Taeron-Systems-Inc/BespokeToast/data/plant-id/README.md

# Captures for plant identification

Eleven runs, taken off the serial console rather than out of the oven's own
logs, and decimated to 1 Hz.

The run logs the oven writes carry `elapsed_s, target_c, actual_c, relay,
cold_c, cpu_c` and **no duty**. Identification needs the input signal, and
the relay column sampled at 1 Hz is an aliased view of a 4 s
time-proportional window rather than the power actually applied. The console
prints the commanded duty every control step, which is what these hold.

1 Hz because the element time constant is about 14 s.

    python3 tools/identify_plant.py            cross-validate and score
    python3 tools/identify_plant.py --fit      fit on everything
    python3 tools/score_runs.py                the tracking figures the docs quote

`../README.md` lists every run in the repository, including the oven's own
logs for some of these same runs, and how to fetch one that is not here.

| file | run | span |
|---|---|---|
| `run-0011-ts391snl-warm.csv` | 0011 | 34 C warm start, to 247 C |
| `run-0013-ts391snl-hot.csv` | 0013 | 59 C start, the hottest allowed, to 247 C |
| `run-0014-ts391lt.csv` | 0014 | 28 C cold start, to 168 C |
| `run-0015-bake-125c.csv` | 0015 | 30 C to 125 C and held |
| `run-0016-ts391snl-hot-precharge.csv` | 0016 | 59 C start on the pre-charge loop, 2026-09-11 |
| `run-0017-ts391lt-hot-precharge.csv` | 0017 | 59 C start, TS391LT, pre-charge loop, 2026-09-11 |
| `run-0018-ts391snl-warm-predictive.csv` | 0018 | 34 C start on the predictive loop (lead 6 s), 2026-09-11 |
| `run-0019-ts391snl-hot-predictive.csv` | 0019 | 59 C start, predictive loop, decay-form prediction (ran 1.5 C hot from 160 C), 2026-09-11 |
| `run-0020-ts391lt-hot-predictive.csv` | 0020 | 59 C start, TS391LT, driven-form prediction, 2026-09-11 |
| `run-0021-ts391snl-cold-predictive.csv` | 0021 | 25 C cold start, driven-form prediction, 2026-09-11 |
| `run-0022-ts391snl-hot-predictive.csv` | 0022 | 59 C start, driven-form prediction -- the direct answer to 0019 |

0011-0015 on 2026-09-10, empty oven, and the four the element model was
fitted on are 0011, 0013, 0014 and 0015.

0016 is the same start as 0013 on the pre-charge firmware: 33 s of charge,
entered the profile at 80.5 C, heating phase rms 1.57 C, worst lag -5.1 C
(0013: 13.06 and -32.0). Its `precharge` rows are full-duty with the profile
clock held. 0017 is TS391LT from the same start: 27 s of charge, entered at
71.8 C, heating phase rms 2.24 C, worst lag -5.2 C, and +4.1 C of overshoot
at the soak knee at 98 C on stored element heat -- the case the predictive
lead was built from.

## The identification run, 2026-09-11

`run-ident-2026-09-11.csv` is the first schedule from
`tools/device/heat_step_test.py`: plateaux at 60, 100, 150, 195 and 235 C,
each held and then square-waved in duty. `run-ident-2026-09-11-console-4hz.txt`
is the raw console capture it was decimated from, kept because the
per-plateau analysis (`tools/plateau_dynamics.py`) reads the step markers
that decimation drops.

Stopped by hand at step 35 of 41 with the cold junction at 65 C and the top
plateau clamping on its 250 C ceiling; the 235 C excitation and the
scheduled cooling are not in it. Peak 250.8 C, no faults.

What it found, per plateau:

    plateau   mean C   gain C/s   tau s    determined?
    60C        42.2      --        --      no: flat, excitation too gentle
    100C       82.9      --        --      weakly, prefers longer tau
    150C      146.1     1.71      ~15-18   yes
    195C      212.3     1.46      ~9       yes

The element time constant FALLS with temperature. The fitted gains at 150
and 212 C agree with the heating table's h - c to within 8%, so the table
is right there; the 235 C plateau climbed 14 C above its setpoint at the
table's own hold duty, so the table is wrong at the top. That locates the
30% dispute between the linear two-state model and the table: it is a
high-temperature effect, and it is the table's.

A single-tau linear model fitted to all five captures is worse than one
fitted to the four profile runs -- rms 11.3 against 5.3 -- because this run
spans a tau that is not constant. The observer in oven/elementff.py uses
the four-run beta, fitted on the warm-start regime it is used in.
