Taeron-Systems-Inc/BespokeToast/docs/hardware.md

# Hardware

A toaster oven converted to a reflow soldering oven, controlled by an Adafruit
PyPortal.

No design documentation exists. Everything here was established by
inspecting the running device, and confirmed by the owner where marked. Claims
are tagged so it is clear what rests on what:

- **[observed]** — read directly off the device or host
- **[confirmed]** — confirmed by the owner
- **[spec]** — published board specification, not verified on this unit
- **[inferred]** — deduced from the firmware, not electrically confirmed
- **[unverified]** — assumed, still unconfirmed
- **[recorded]** — measured previously and recovered from this repository's
  history; conditions not fully documented

## Controller

| | |
|---|---|
| Board | Adafruit PyPortal **[observed]** |
| MCU | ATSAMD51J20 **[observed]** |
| USB ID | `239a:8036` **[observed]** |
| Board UID | `FCC166805943385320202046141E04FF` **[observed]** |
| CircuitPython | **8.0.5** (2023-03-31) **[observed]** |
| Serial | USB CDC console; enumerates as `Adafruit Industries LLC PyPortal` **[observed]** |
| Mass storage | 8 MB FAT volume, label `CIRCUITPY` **[observed]** |

The board also enumerates as a USB HID keyboard and mouse **[observed]**. It
sends no input, but it is capable of typing into whatever host it is connected
to.

## Mains switching

| | |
|---|---|
| Device | Mechanical relay **[confirmed]** |
| Control pin | `board.D4`, `digitalio` output, `True` energises **[observed]** |
| Connector | `D4` is one of the PyPortal's two 3-pin JST-PH connectors **[spec]** |
| Load | 120 VAC to the oven elements **[confirmed]** |

**Actuations are a consumable, and this firmware spends more of them than
the one it replaced [measured].** The relay is driven by a 4 s
time-proportional window, so it is held continuously while the error is
large and modulates near setpoint. Measured across the hold of a four-hour
bake, `data/bake-125c-run-0024-2026-09-16.csv`: 8.19 closures per minute,
about 1965 in the run. A reflow profile costs far fewer, because most of it
is spent saturated. The controller that was here before this one managed
roughly 20 in a session by holding the relay across consecutive saturated
windows; the cost of the change is relay life, and what it buys is 0.240 C
rms instead of a curve the oven wandered around. Contact rating is still
unknown — see *Open questions*.

**The relay fails safe [measured].** Reading `D4` back as an input under each
internal pull returns `False` under both pull-up and pull-down, so an external
pulldown dominates and the relay is de-energised whenever the pin is not
driven. Reproduced identically on three separate runs.

This matters beyond the obvious: CircuitPython releases pins whenever the VM
exits, so high-Z on `D4` occurs on every reset, every `Ctrl-C` and every
auto-reload. All of those are safe.

## Temperature sensing

| | |
|---|---|
| Device | MCP9601 thermocouple amplifier, Adafruit **5165** (STEMMA QT) **[confirmed]** |
| Thermocouple | Type **K**, Adafruit **3245**: glass braid, 2 mm stainless tip **[confirmed]** |
| I²C address | `0x67` (103 decimal), the board's default **[spec]** |
| Bus | `board.SCL` / `board.SDA` at 100 kHz **[observed]** |
| Driver | `adafruit_mcp9600`, which serves both chips **[spec]** |

Probe placement inside the oven cavity is **[unverified]**, which leaves thermal
lag between element and probe unquantified.

### What changed from the MCP9600 and the bare-bead probe

The oven was built with an MCP9600 (Adafruit 4101) and a bare-bead type-K
probe (Adafruit 270). **Everything measured in this document was measured on
that pair**: the step tests, the coast, the latch-up and the enclosure
temperatures. None of it has been repeated on the new parts yet.

**The driver on the board must accept the MCP9601.** It checks the chip's
device ID, and older releases of `adafruit_mcp9600` accept only the MCP9600's
`0x40`. With one of those the firmware stops at boot with "Failed to find
MCP9600". Install a current release from the bundle **[spec]**.

**The firmware refuses an MCP9600.** `oven/hardware.py` reads the device ID
itself and stops at boot unless it is the MCP9601's `0x41`. It reads the
MCP9601's status bits, and on an MCP9600 those mean something else.

**An open or shorted probe now trips at once.** The MCP9601 sets bit 4 of
its status register when the probe is open (or its voltage is outside the
type-K range, which at oven temperatures only a wiring fault causes) and bit
5 when it is shorted to VDD or ground. The firmware reports them as
`thermocouple open circuit` and `thermocouple short circuit`, and the
supervisor latches on either. Before, a disconnected probe produced a reading
and only the stall and frozen guards could catch it. They still run.

The detection works only if the breakout wires the chip's VSENSE pin, and
that is **[unverified]** for the 5165. To check it, with the oven unpowered at
the wall, take one probe lead out of the terminal block and power the
PyPortal over USB: the first reading should fault with `thermocouple open
circuit`. If it reads a temperature instead, the bits are not wired and the
oven is protected exactly as it was before.

**The probe's tip is its junction.** The 3245's junction is bonded to the
stainless tip, so the tip is electrically part of the thermocouple. If it
touches the oven's metal it ties the input to the chassis. Expect a short
circuit fault, if VSENSE is wired, or a noisy reading if it is not. Mount it
so the tip touches nothing but air.

**The probe is slower.** A 2 mm steel tip responds more slowly than a bare
bead, so the oven will look like it lags more and coasts further past a peak
than *Measured thermal behaviour* says. The controller was tuned on those
figures. Repeat the step tests before trusting a reflow profile to them
**[unverified]**.

**The PyPortal's I²C port jumper must be on 3V.** The port supplies 5 V by
default, and the breakout pulls SDA and SCL up to its supply through 10 kΩ.
At 5 V that back-feeds the SAMD51's 3.3 V rail through the bus lines, which
stopped the board booting with the MCP9600 fitted.

### The amplifier can latch up and hold the bus down

Twenty-three minutes into a 125 C bake, holding steady at 124.7 C, the
MCP9600 stopped answering between one sample and the next. The supervisor
faulted on the first missing reading and opened the relay: the run was lost,
and nothing else. Neither temperature channel gave warning. The cold junction
was 46.1 C and levelling off, below what it had reached twice that day without
trouble, and the chamber reading was quieter in its last minutes than earlier
in the hold.

Afterwards the board could not start the bus at all (`RuntimeError: No pull up
found on SDA or SCL`). Read as plain inputs, SCL sat high and SDA sat low even
with the processor's internal pull-up on: SDA was being held to ground.
Resetting the processor did not clear it. Removing all power did -- unplugging
the Pi and the oven's USB cable and plugging them back in, with nothing else
changed.

That is the amplifier latching up and holding SDA low, not a wiring fault.
Seen once. The oven faults safely when it happens -- the supervisor opens
the relay on the first missing reading -- and the fix is to remove power,
which can be done from the Pi without touching the bench (see *Cutting the
oven's power from the Pi*).

## Measured thermal behaviour

Measured with the MCP9600 and the bare-bead probe; see *What changed from the
MCP9600 and the bare-bead probe*.

Two step tests were run on 2026-08-25, empty oven, logged at 2 Hz:
`data/e2-step-test-2026-08-25.csv` (26 → 200 °C) and
`data/e2-step-test-240c-2026-08-25.csv` (53 → 240 °C).

| | **[measured]** |
|---|---|
| Heating, 26 → 200 °C | 143 s |
| Heating, 53 → 240 °C | 177 s |
| Peak heating rate | **1.85 °C/s at 80 °C** |
| Heating rate at 200 °C | **0.90 °C/s** |
| Passive cooling at 190 °C, door shut | **−0.70 °C/s** |
| Coast after relay opens, from 200 °C | **1.06 °C over 3 s** |
| Coast after relay opens, from 240 °C | **0.56 °C over 2 s** |
| Enclosure cold junction, peak | 41.8 °C |
| CPU die, peak | 36.2 °C |

Three things follow.

**The oven is not a first-order system.** Its heating rate *rises* to a peak
near 80 °C rather than decaying from the start, and its heating and cooling
time constants differ by roughly 2.5×. A fitted first-order-plus-dead-time
model gave a 20 s dead time, which predicts about 17 °C of coast — sixteen
times what was measured. The model is not used; the measured curves are.

**The oven's capability falls as it gets hotter, and reflow needs it hottest.**
1.85 °C/s at 80 °C but 0.90 °C/s at 200 °C. Both available profiles demand
their fastest rise in the spike zone, where the oven is weakest.

**Cooling cannot follow any reflow profile with the door shut**, at −0.70 °C/s
against the 1.3–2.0 °C/s profiles ask for.

### The 2023 figure was wrong

A calibration recovered from this repository's history recorded 29.6 °C of
overshoot over 37 s at a 100 °C setpoint. The measurement above is 1.06 °C
over 3 s — smaller by a factor of 28. Whatever that run measured, it does not
describe this oven. It is recorded here only so nobody re-derives anything
from it.

The procedure: heat until the setpoint is reached, open the relay, keep sampling
until the temperature stops rising. The resulting figures were stored as
`calibrate_temp` and `calibrate_seconds` in a configuration file the current
firmware no longer reads.

One data point, at one temperature, with ambient and load unrecorded — treat the
numbers as indicative rather than exact. What they establish is not in doubt:
this oven keeps heating substantially after power is removed. Any control scheme
that decides when to stop by looking only at the present temperature will
overshoot its peak.

## The enclosure warms unevenly

Two thermometers sit in the enclosure: the amplifier's cold junction (its own
die, which it needs anyway to compensate the thermocouple) and the SAMD51's
die. Across a full run they behave completely differently **[measured]**, on
the MCP9600:

| | cold junction | controller die |
|---|---|---|
| rise, step to 200 °C | **+15.3 °C** | +0.2 °C |
| rise, step to 240 °C | **+12.2 °C** | 0.0 °C |

The enclosure as a whole is not warming. One chip is. The SAMD51, centimetres
away in the same box, does not move at all, which rules out warm air and
points at conduction — almost certainly heat travelling up the thermocouple
wires into the MCP9600's terminals.

That matters beyond the enclosure. Cold-junction compensation assumes the
chip's die and the thermocouple terminals are at the same temperature. Heat
arriving *through the terminals* is exactly the case where they are not, and
the error grows through the run, peaking when the oven is hottest and the
reading matters most. Its size is **[unverified]**: bounding it needs a
reference probe in the cavity to compare against.

Both temperatures are logged every control step, so the divergence is
recorded on every run rather than inferred afterwards.

## Display and input

- 320×240 2.4" TFT with resistive touch **[spec]**. The firmware reads
  `board.DISPLAY.width` / `.height` rather than hardcoding **[observed]**.
- The panel is full colour. The firmware uses a five-entry palette — black,
  white, red, green, blue **[observed]**.
- Touch calibration in use: `((5200, 59000), (5800, 57000))` **[observed]**.

## Physical installation

The PyPortal, the relay, and the associated wiring are housed together in a
small 3D-printed plastic enclosure, hardwired into the oven and sitting beside
it **[confirmed]**.

Consequences worth recording:

- **No plug to pull.** The oven is hardwired, so isolating it means a breaker or
  an upstream switch, not unplugging. Any procedure that assumes a plug can be
  yanked needs rewriting.
- **The NeoPixel is not visible** from outside the enclosure **[confirmed]**,
  which leaves the screen as the only visual indicator, and audio as the only
  non-visual one.
- **The enclosure sits next to a heat source.** Internal ambient will rise during
  a run by an unmeasured amount. Two consequences: the enclosure material's
  softening point is a limit nobody has characterised, and the amplifier's
  cold-junction compensation assumes its die and the thermocouple terminals are
  at the same temperature — a thermal gradient across the enclosure introduces
  measurement error. Neither is quantified. **[unverified]**

## Fitted, not used by the firmware

microSD slot and light sensor **[spec]**, and the NeoPixel, which is in any
case enclosed and invisible — see above.

The speaker **is** used, for two sounds: a rising arpeggio when a profile
finishes, and a falling tone pair, twice, on a fault or a preheat that timed
out. Both are under two seconds and play without blocking the loop; see
`oven/chime.py`. `CHIME DONE` and `CHIME FAULT` on the console play them on
demand. A speaker that fails to start leaves the oven silent, not stopped.
The relay is driven open before the speaker is set up or touched, and
cannot close again until the sound is over (`hal.Interlocked`).

The ESP32 WiFi co-processor **is** used: it sets the clock at boot and serves
the oven's page while it is idle. It is kept out of the control loop by
timing rather than by choice, because one SPI call to it can block for 227 ms
against a 250 ms deadline. See `network.md`.

## Connecting to the device

Over USB the board presents two interfaces:

- **Serial console / REPL** — a USB CDC device, conventionally `/dev/ttyACM*` on
  Linux. The stable path is under `/dev/serial/by-id/`, keyed by the board UID
  above, which does not move between reboots or ports. On most Linux systems the
  node is group `dialout`, so the account using it needs that membership.
- **`CIRCUITPY` volume** — a small FAT filesystem. Where it does not auto-mount,
  mount it read-only unless you intend to deploy:

  ```
  sudo mount -o ro,uid=$(id -u),gid=$(id -g) /dev/disk/by-label/CIRCUITPY /mnt/circuitpy
  ```

Opening the serial console does not reset the board. Toggling DTR at 1200 baud
puts it into the UF2 bootloader, so avoid that unless reflashing is intended.

### Cutting the oven's power from the Pi

The bench Pi is a Raspberry Pi 3 Model B. Its USB ports 2 to 5 share one power
switch, reached through port 2, so the oven's power is cut and restored with

    sudo uhubctl -l 1-1 -p 2 -a cycle -d 12

That cuts every USB device plugged into the Pi, not only the oven. The Pi's own
network is its built-in WiFi, which is not on USB, so an SSH session survives
it; the wired Ethernet adapter sits on hub port 1 and is not switched.
Verified 2026-09-15: the board dropped off the bus and came back with its clock
restarted from zero.

**Asking for port 4, where the oven is plugged in, does nothing.** `uhubctl`
reports the port as off and the board re-enumerates, but power never drops. On
2026-09-11 that was taken for a real power cycle and reported as one. It was
not, which is why the latched amplifier survived it and a physical unplug
cleared it.

## Open questions

1. Where is the thermocouple mounted in the cavity? Unknown placement leaves
   the lag between element and probe unquantified.
2. Relay contact rating, and whether it switches one leg or both.
3. Is there an independent thermal cutout, or is the PyPortal the only
   control over the elements?
4. How large is the cold-junction compensation error at peak? Bounding it
   needs a reference probe in the cavity (see *The enclosure warms
   unevenly*).
5. Does the Adafruit 5165 wire the MCP9601's VSENSE pin? If not, the open
   and short circuit bits never set (see *What changed from the MCP9600 and
   the bare-bead probe*).
6. How much lag and coast does the 3245's steel tip add? The step tests need
   repeating on it.
