Taeron-Systems-Inc/BespokeToast/docs/frozen-build.md

# Building the firmware with the oven's own code frozen

## Why

The PyPortal has 256 kB of RAM and no more. Python module bytecode loaded
from the filesystem lives in that RAM; bytecode frozen into the CircuitPython
image executes from flash and costs almost nothing. Measured on this board:

| | free | largest block |
|---|---|---|
| all ten profiles loaded, libraries shadowed | 16 384 | 1 696 |
| one profile loaded | 30 352 | 4 912 |
| rate curves packed into arrays | 34 160 | — |
| shadowing libraries moved aside | 36 032 | 2 608 |
| **oven package frozen into the firmware** | **77 952** | **7 024** |

Nearly five times the memory it started with. The largest contiguous block
matters as much as the total: every render failure in this project was a
few hundred bytes failing against a heap with plenty free and no hole big
enough.

## Why the largest free block is the number to watch

Free memory has never been what failed on this board. Every render failure
in this project has been a few hundred to a couple of thousand bytes failing
against a heap with tens of kB free and no hole big enough, because
MicroPython's collector does not compact.

The clearest case: run 0009, a four-hour bake, reported 50 kB free and a
largest free block of 1776 bytes while the console counted 3256 memory
failures composing a screen. (The counter is a console warning from
`code.py`, not a column in the log —
`data/bake-125c-run-0009-2026-09-09.csv` is the run, not the counter.)
Measured on the board, one compose of
the running screen holds 2896 bytes -- but as forty small tuples plus, at
the time, two copied point lists:

    list(history), 150 points      1056 bytes
    list(profile_points), 25        160

A fragmented heap can satisfy forty small requests. It cannot satisfy one
kilobyte in one piece. Removing those two copies removed the largest single
request the screen makes, and nothing else about the compose changed.

The lesson generalises: when something fails for memory here, ask what the
biggest single allocation is, not how much is free.

## The rule that makes it work, and breaks it

**A file on CIRCUITPY shadows the frozen copy of the same module.** That is
how you undo all of this without any error appearing: everything still
works, on a third of the memory.

So a frozen build requires the volume NOT to contain:

- `oven/` — the firmware's own package
- `adafruit_display_text`, `adafruit_esp32spi`, `adafruit_bus_device`,
  `adafruit_portalbase`, `adafruit_requests`, `neopixel` — these are frozen
  into the stock PyPortal firmware already, and the Adafruit bundle puts
  copies on the volume

`tools/deploy.py` refuses to deploy when any of the libraries reappear, and
skips `oven/` entirely when it sees the board is running a frozen build.
The displaced copies are kept in `.shadowed/` on the volume.

## Why 8.0.5, and why it is pinned

The board runs CircuitPython **8.0.5** and the frozen build is pinned to it.
The reason is a version coupling inherited from the oven as found: the
controller that was on it called `display.show(group)`, which CircuitPython
9 removed, and its bundled `.mpy` libraries were 8.x builds. The current
firmware no longer depends on either, so the pin is now a deliberate choice
rather than a constraint: 8.0.5 is the version every measurement in this
repository was taken on, and moving it is a change to be made and validated
on purpose, not inherited by building against whatever is current.

## Building

The build host needs ~3 GB of disk and an ARM toolchain, which the Pi that
talks to the oven has neither of. `tools/release.py` takes it from
`TOASTER_BUILD_HOST` and refuses to run without it, rather than defaulting
to whichever machine happened to build it here:

    export TOASTER_BUILD_HOST=user@host

    # toolchain, no root required
    mkdir -p ~/toolchains && cd ~/toolchains
    curl -LO https://developer.arm.com/-/media/Files/downloads/gnu/13.2.rel1/binrel/arm-gnu-toolchain-13.2.rel1-x86_64-arm-none-eabi.tar.xz
    tar xf arm-gnu-toolchain-13.2.rel1-x86_64-arm-none-eabi.tar.xz
    pip3 install --user cascadetoml

    # source, matching the version already on the board
    mkdir -p ~/build && cd ~/build
    git clone --depth 1 --branch 8.0.5 https://github.com/adafruit/circuitpython.git
    cd circuitpython && make fetch-submodules

    # the oven's code, and the line that freezes it
    rsync -a firmware/oven/ ~/build/circuitpython/frozen/BespokeToast/oven/
    echo 'FROZEN_MPY_DIRS += $(TOP)/frozen/BespokeToast' \
      >> ports/atmel-samd/boards/pyportal/mpconfigboard.mk

    export PATH=$HOME/.local/bin:$HOME/toolchains/arm-gnu-toolchain-13.2.Rel1-x86_64-arm-none-eabi/bin:$PATH
    cd ports/atmel-samd && make -j24 BOARD=pyportal

Result: `build-pyportal/firmware.uf2`.

### One patch is required

GCC 13.2 is newer than CircuitPython 8.0.5 and its new diagnostics — a
dangling-pointer warning in `py/stackctrl.c` — are fatal under the port's
hardcoded `-Werror`. There is no `WERROR` knob and `CFLAGS_EXTRA` is applied
too early to override it, so the blanket flag is removed from
`ports/atmel-samd/Makefile`:

    -Wall -Werror -std=gnu11   ->   -Wall -std=gnu11

`-Werror=missing-prototypes` is deliberately left in place. The alternative
is to fetch a GCC contemporary with 8.0.5.

## Flashing

The bootloader can be entered without touching the board, which matters
because the USB port is behind a panel:

    import microcontroller
    microcontroller.on_next_reset(microcontroller.RunMode.BOOTLOADER)
    microcontroller.reset()

The volume reappears as `PORTALBOOT`; copy the `.uf2` onto it and the board
reboots itself.

## Rolling back

Two levels, cheapest first.

1. **Move `oven/` back** from `.shadowed/` on the volume. The filesystem
   copy shadows the frozen one, so the board runs the old code again with no
   reflash. This is why the flash and the switch are separate steps.
2. **Reflash the stock image**, kept alongside the build:
   `adafruit-circuitpython-pyportal-en_US-8.0.5.uf2` from
   downloads.circuitpython.org.

If CircuitPython will not boot at all, the bootloader is in a protected
region and survives; entering it then needs a physical double-tap on reset,
which means opening the panel.

## Who owns CIRCUITPY

A deploy needs the host to own the volume; the oven needs to own it to record
a run. Only one direction is automatic:

    cable comes out          the oven takes it back, one boot later
    cable goes in            nothing happens

    python3 tools/deploy.py /mnt/circuitpy      take it, and keep it
    python3 tools/deploy.py --standalone        hand it back, and keep it that way

Attaching a cable used to take the volume by itself, which meant an oven with
a programming cable left in could never record a run: every boot rewrote the
mode back to HOST, so every following boot came up host-owned with logging
off. It showed on the power-on screen as a red FAIL beside "run logging", on
an oven that was working perfectly.

Being locked out is a single command over the serial console, which is
available exactly when a cable is attached, so making this explicit costs
nothing and stops the oven quietly losing the one job only it can do.

## What changes about day-to-day work

Editing anything under `firmware/oven/` no longer takes effect by deploying.
It needs a rebuild and a reflash. `code.py`, `profiles/`, `assets/` and
`characterisation.json` still deploy normally, which covers most changes.
