Taeron-Systems-Inc/BespokeToast/tests/data/nc191-measured-run.csv

# NC191LTA10 datasheet profile as this oven actually ran it
# 2026-09-01 | cold start | operator opened the door at the end
# of the run. Decimated to 1 Hz. Used to test decisions against
# what the oven does rather than against a perfectly followed
# target -- with perfect tracking the door is never needed
# which is exactly why an idealised test proved nothing.
elapsed_s | temp_c
0.0 | 26.188
1.0 | 26.125
2.0 | 26.188
3.0 | 26.250
4.3 | 26.312
5.5 | 26.438
6.5 | 26.688
7.8 | 26.875
9.0 | 27.250
10.0 | 27.500
11.0 | 28.000
12.3 | 28.500
13.3 | 29.062
14.5 | 29.938
15.7 | 30.812
16.7 | 31.500
17.8 | 32.500
19.0 | 33.688
20.0 | 34.688
21.0 | 35.688
22.0 | 37.125
23.0 | 38.312
24.4 | 39.875
25.5 | 41.750
26.5 | 43.125
27.5 | 44.562
28.5 | 45.938
29.8 | 48.125
31.0 | 50.000
32.0 | 51.562
33.1 | 53.500
34.3 | 55.500
35.5 | 57.875
36.5 | 59.562
37.8 | 61.562
39.0 | 64.188
40.3 | 66.375
41.3 | 68.125
42.3 | 70.250
43.5 | 72.000
44.5 | 74.188
45.5 | 76.312
46.8 | 78.000
48.0 | 79.188
49.2 | 80.688
50.3 | 81.562
51.3 | 82.438
52.3 | 83.188
53.5 | 84.188
54.5 | 84.750
55.8 | 85.500
57.0 | 86.188
58.0 | 86.562
59.2 | 87.125
60.3 | 87.500
61.3 | 87.812
62.5 | 88.125
63.5 | 88.438
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
