Taeron-Systems-Inc/BespokeToast/tests/data/run-0006-nc191lta10.csv

# Taeron Reflow Oven run log
# firmware | v2.0-dev
# profile | NC191LTA10
# started_at_epoch | 1788899927
# started_at_local | 2026-09-08 13:38:47 PDT
# entered_at_s | 0.0
# wall clock of a row = started_at_epoch + elapsed_s
elapsed_s | target_c | actual_c | relay | cold_c | cpu_c
# event | 0.2 | run_started | entered_at_s=1.1 oven_c=26.4 profile=NC191LTA10
0.2 | 25.00 | 26.438 | 0 | 27.00 | 37.47
# event | 0.7 | stage_changed | stage=preheat
1.2 | 27.84 | 26.438 | 0 | 27.00 | 37.47
2.5 | 29.50 | 26.438 | 0 | 27.00 | 37.26
3.5 | 30.84 | 26.500 | 0 | 27.06 | 37.05
4.7 | 32.51 | 26.438 | 1 | 27.00 | 36.41
5.8 | 33.90 | 26.438 | 1 | 27.00 | 36.62
7.0 | 35.49 | 26.438 | 1 | 27.00 | 37.26
8.0 | 36.83 | 26.500 | 1 | 27.06 | 36.62
9.0 | 38.17 | 26.438 | 1 | 27.00 | 37.05
10.0 | 39.51 | 26.500 | 1 | 27.00 | 37.26
11.3 | 41.22 | 26.563 | 1 | 27.00 | 36.84
12.5 | 42.85 | 26.750 | 1 | 27.00 | 36.41
13.5 | 44.19 | 26.938 | 1 | 27.00 | 36.84
14.7 | 45.63 | 27.188 | 1 | 27.00 | 37.26
16.0 | 46.87 | 27.500 | 1 | 27.06 | 36.84
17.2 | 48.12 | 27.875 | 1 | 27.06 | 36.62
18.2 | 49.13 | 28.250 | 1 | 27.06 | 36.41
19.5 | 50.39 | 28.875 | 1 | 27.06 | 37.69
20.7 | 51.63 | 29.438 | 1 | 27.06 | 37.26
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
