Taeron-Systems-Inc/BespokeToast/design_files/BespokeToast_Rev-0_v77.brd

## EAGLE design design_files/BespokeToast_Rev-0_v77.brd (2023-02-11, last stored version)

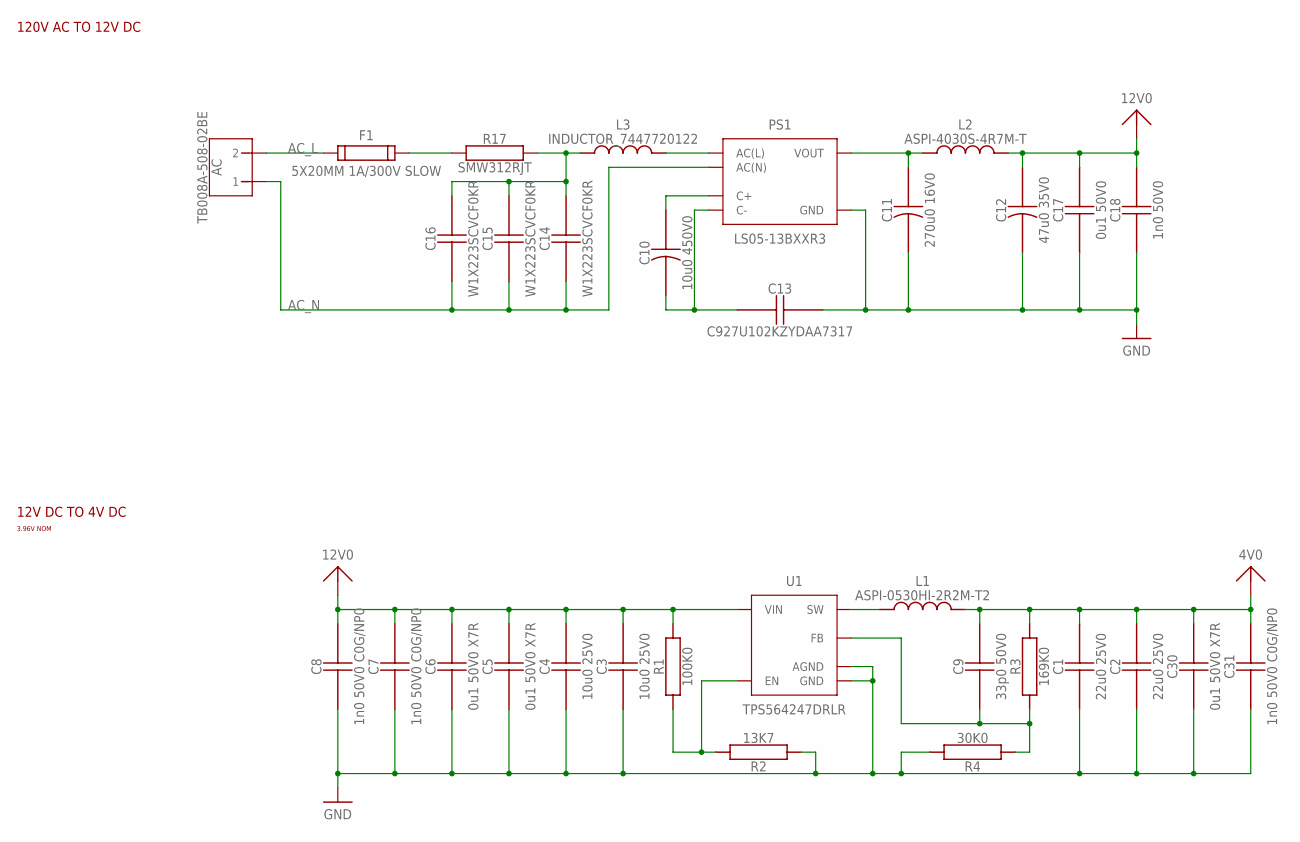
[picture p1: schematic BespokeToast_Rev-0_v77.sch, sheet 1, POWER SUPPLY]

Parts:
AC: TB008A-508-02BE
C1, C2: 22u0 25V0; SAMSUNG_CAP-0805
C3, C4: 10u0 25V0; SAMSUNG_CAP-0805
C5, C6, C30: 0u1 50V0 X7R; SAMSUNG_CAP-0402
C7, C8, C31: 1n0 50V0 C0G/NP0; SAMSUNG_CAP-0402
C9: 33p0 50V0; SAMSUNG_CAP-0402
C10: 10u0 450V0; RUBYCON_CAP-POL-5X10
C11: 270u0 16V0; RUBYCON_CAP-POL-3.5X8
C12: 47u0 35V0; RUBYCON_CAP-POL-3.5X8
C13: C927U102KZYDAA7317; TH_CAP-7.5
C14, C15, C16: W1X223SCVCF0KR; TH_CAP-7.5
C17: 0u1 50V0; SAMSUNG_CAP-0402
C18: 1n0 50V0; SAMSUNG_CAP-0402
F1: 5X20MM 1A/300V SLOW; FC-203-22
L1: ASPI-0530HI-2R2M-T2
L2: ASPI-4030S-4R7M-T
L3: INDUCTOR_7447720122; 7447720122
PS1: LS05-13BXXR3
R1: 100K0; YAGEO_RES-0402
R2: 13K7; YAGEO_RES-0402
R3: 169K0; YAGEO_RES-0402
R4: 30K0; YAGEO_RES-0402
R17: SMW312RJT
U1: TPS564247DRLR

Connections:
4V0: C1.P$2, C2.P$2, C9.P$2, C30.P$2, C31.P$2, L1.P$2, R3.P$2; also elsewhere on the board
12V0: C3.P$2, C4.P$2, C5.P$2, C6.P$2, C7.P$2, C8.P$2, C12.+, C17.P$2, C18.P$2, L2.P$2, R1.P$2, U1.P$1 (VIN); also elsewhere on the board
AC_L: AC.P$2 (2), F1.P$1, F1.P$2; also elsewhere on the board
AC_N: AC.P$1 (1), C14.P$1, C15.P$1, C16.P$1, PS1.P$2 (AC(N)); also elsewhere on the board
GND: C1.P$1, C2.P$1, C3.P$1, C4.P$1, C5.P$1, C6.P$1, C7.P$1, C8.P$1, C11.-, C12.-, C13.P$2, C17.P$1, C18.P$1, C30.P$1, C31.P$1, PS1.P$5 (GND), R2.P$1, R4.P$2, U1.P$3 (GND), U1.P$4 (AGND); also elsewhere on the board
unnamed: R1.P$1, R2.P$2, U1.P$5 (EN)
unnamed: C10.+, PS1.P$3 (C+)
unnamed: C10.-, C13.P$1, PS1.P$4 (C-)
unnamed: C11.+, L2.P$1, PS1.P$6 (VOUT)
unnamed: F1.P$3, F1.P$4, R17.P$2
unnamed: C9.P$1, R3.P$1, R4.P$1, U1.P$6 (FB)
unnamed: C14.P$2, C15.P$2, C16.P$2, L3.P$1, R17.P$1
unnamed: L3.P$2, PS1.P$1 (AC(L))
OUT: L1.P$1, U1.P$2 (SW)

Notes on the sheet:
120V AC TO 12V DC
12V DC TO 4V DC
3.96V NOM

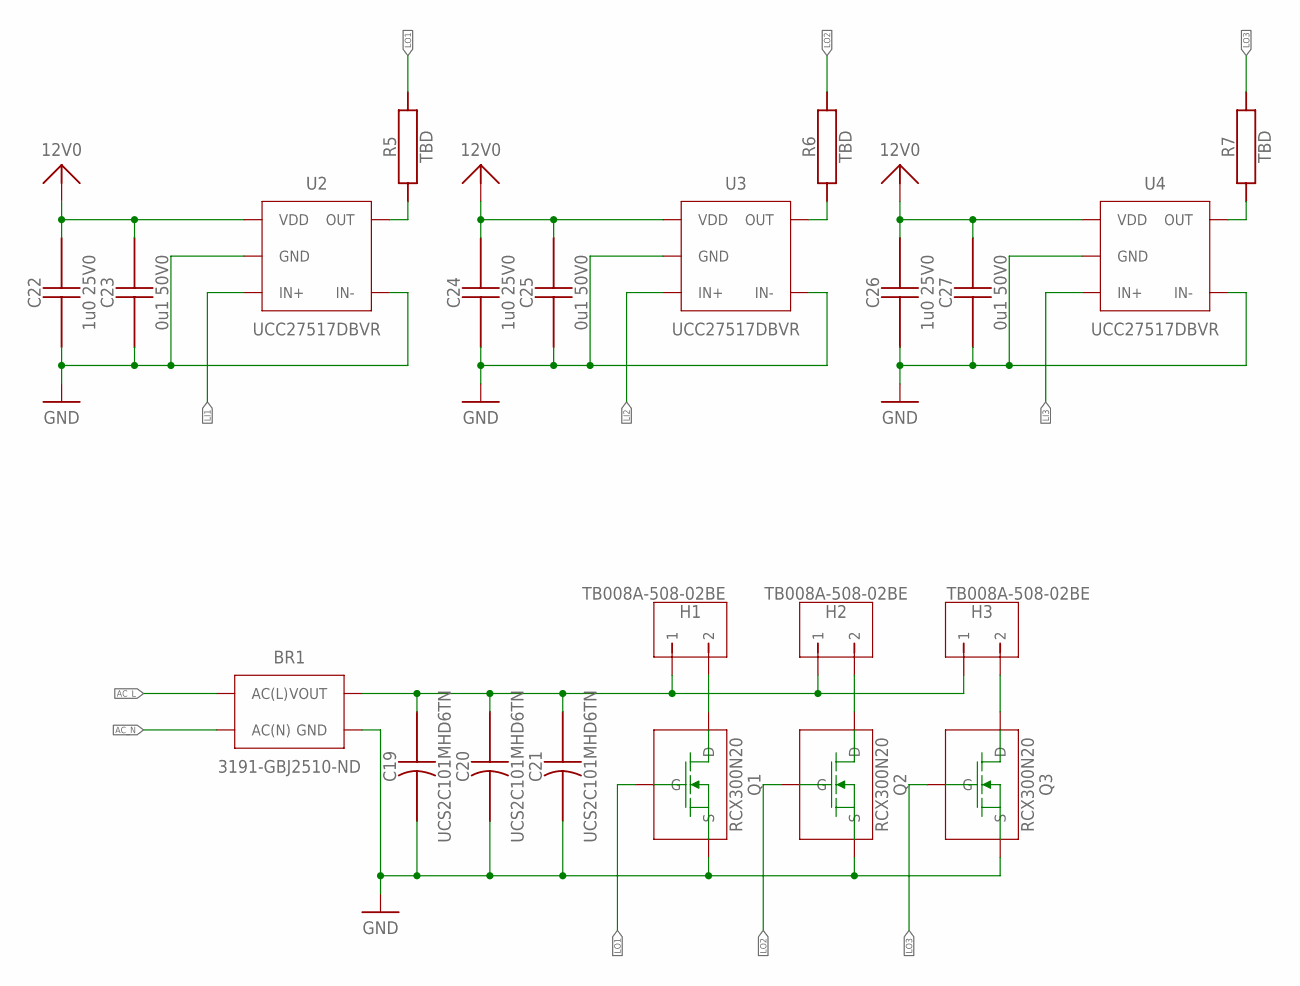
[picture p2: schematic BespokeToast_Rev-0_v77.sch, sheet 2, POWER]

Parts:
BR1: 3191-GBJ2510-ND; GBJ2510
C19, C20, C21: UCS2C101MHD6TN; RUBYCON_CAP-POL-7.5X16
C22, C24, C26: 1u0 25V0; SAMSUNG_CAP-0805
C23, C25, C27: 0u1 50V0; SAMSUNG_CAP-0402
H1, H2, H3: TB008A-508-02BE
Q1, Q2, Q3: RCX300N20; FET_TO220-VTH
R5, R6, R7: TBD; YAGEO_RES-0402
U2, U3, U4: UCC27517DBVR

Connections:
12V0: C22.P$2, C23.P$2, C24.P$2, C25.P$2, C26.P$2, C27.P$2, U2.P$1 (VDD), U3.P$1 (VDD), U4.P$1 (VDD); also elsewhere on the board
AC_L: BR1.P$2 (AC(L)); also elsewhere on the board
AC_N: BR1.P$3 (AC(N)); also elsewhere on the board
GND: BR1.P$4 (GND), C19.-, C20.-, C21.-, C22.P$1, C23.P$1, C24.P$1, C25.P$1, C26.P$1, C27.P$1, Q1.S, Q2.S, Q3.S, U2.P$2 (GND), U2.P$4 (IN-), U3.P$2 (GND), U3.P$4 (IN-), U4.P$2 (GND), U4.P$4 (IN-); also elsewhere on the board
LI1: U2.P$3 (IN+); also elsewhere on the board
LI2: U3.P$3 (IN+); also elsewhere on the board
LI3: U4.P$3 (IN+); also elsewhere on the board
LO1: Q1.G, R5.P$2
LO2: Q2.G, R6.P$2
LO3: Q3.G, R7.P$2
unnamed: H1.P$2 (2), Q1.D
unnamed: H2.P$2 (2), Q2.D
unnamed: H3.P$2 (2), Q3.D
unnamed: BR1.P$1 (VOUT), C19.+, C20.+, C21.+, H1.P$1 (1), H2.P$1 (1), H3.P$1 (1)
unnamed: R6.P$1, U3.P$5 (OUT)
unnamed: R5.P$1, U2.P$5 (OUT)
unnamed: R7.P$1, U4.P$5 (OUT)

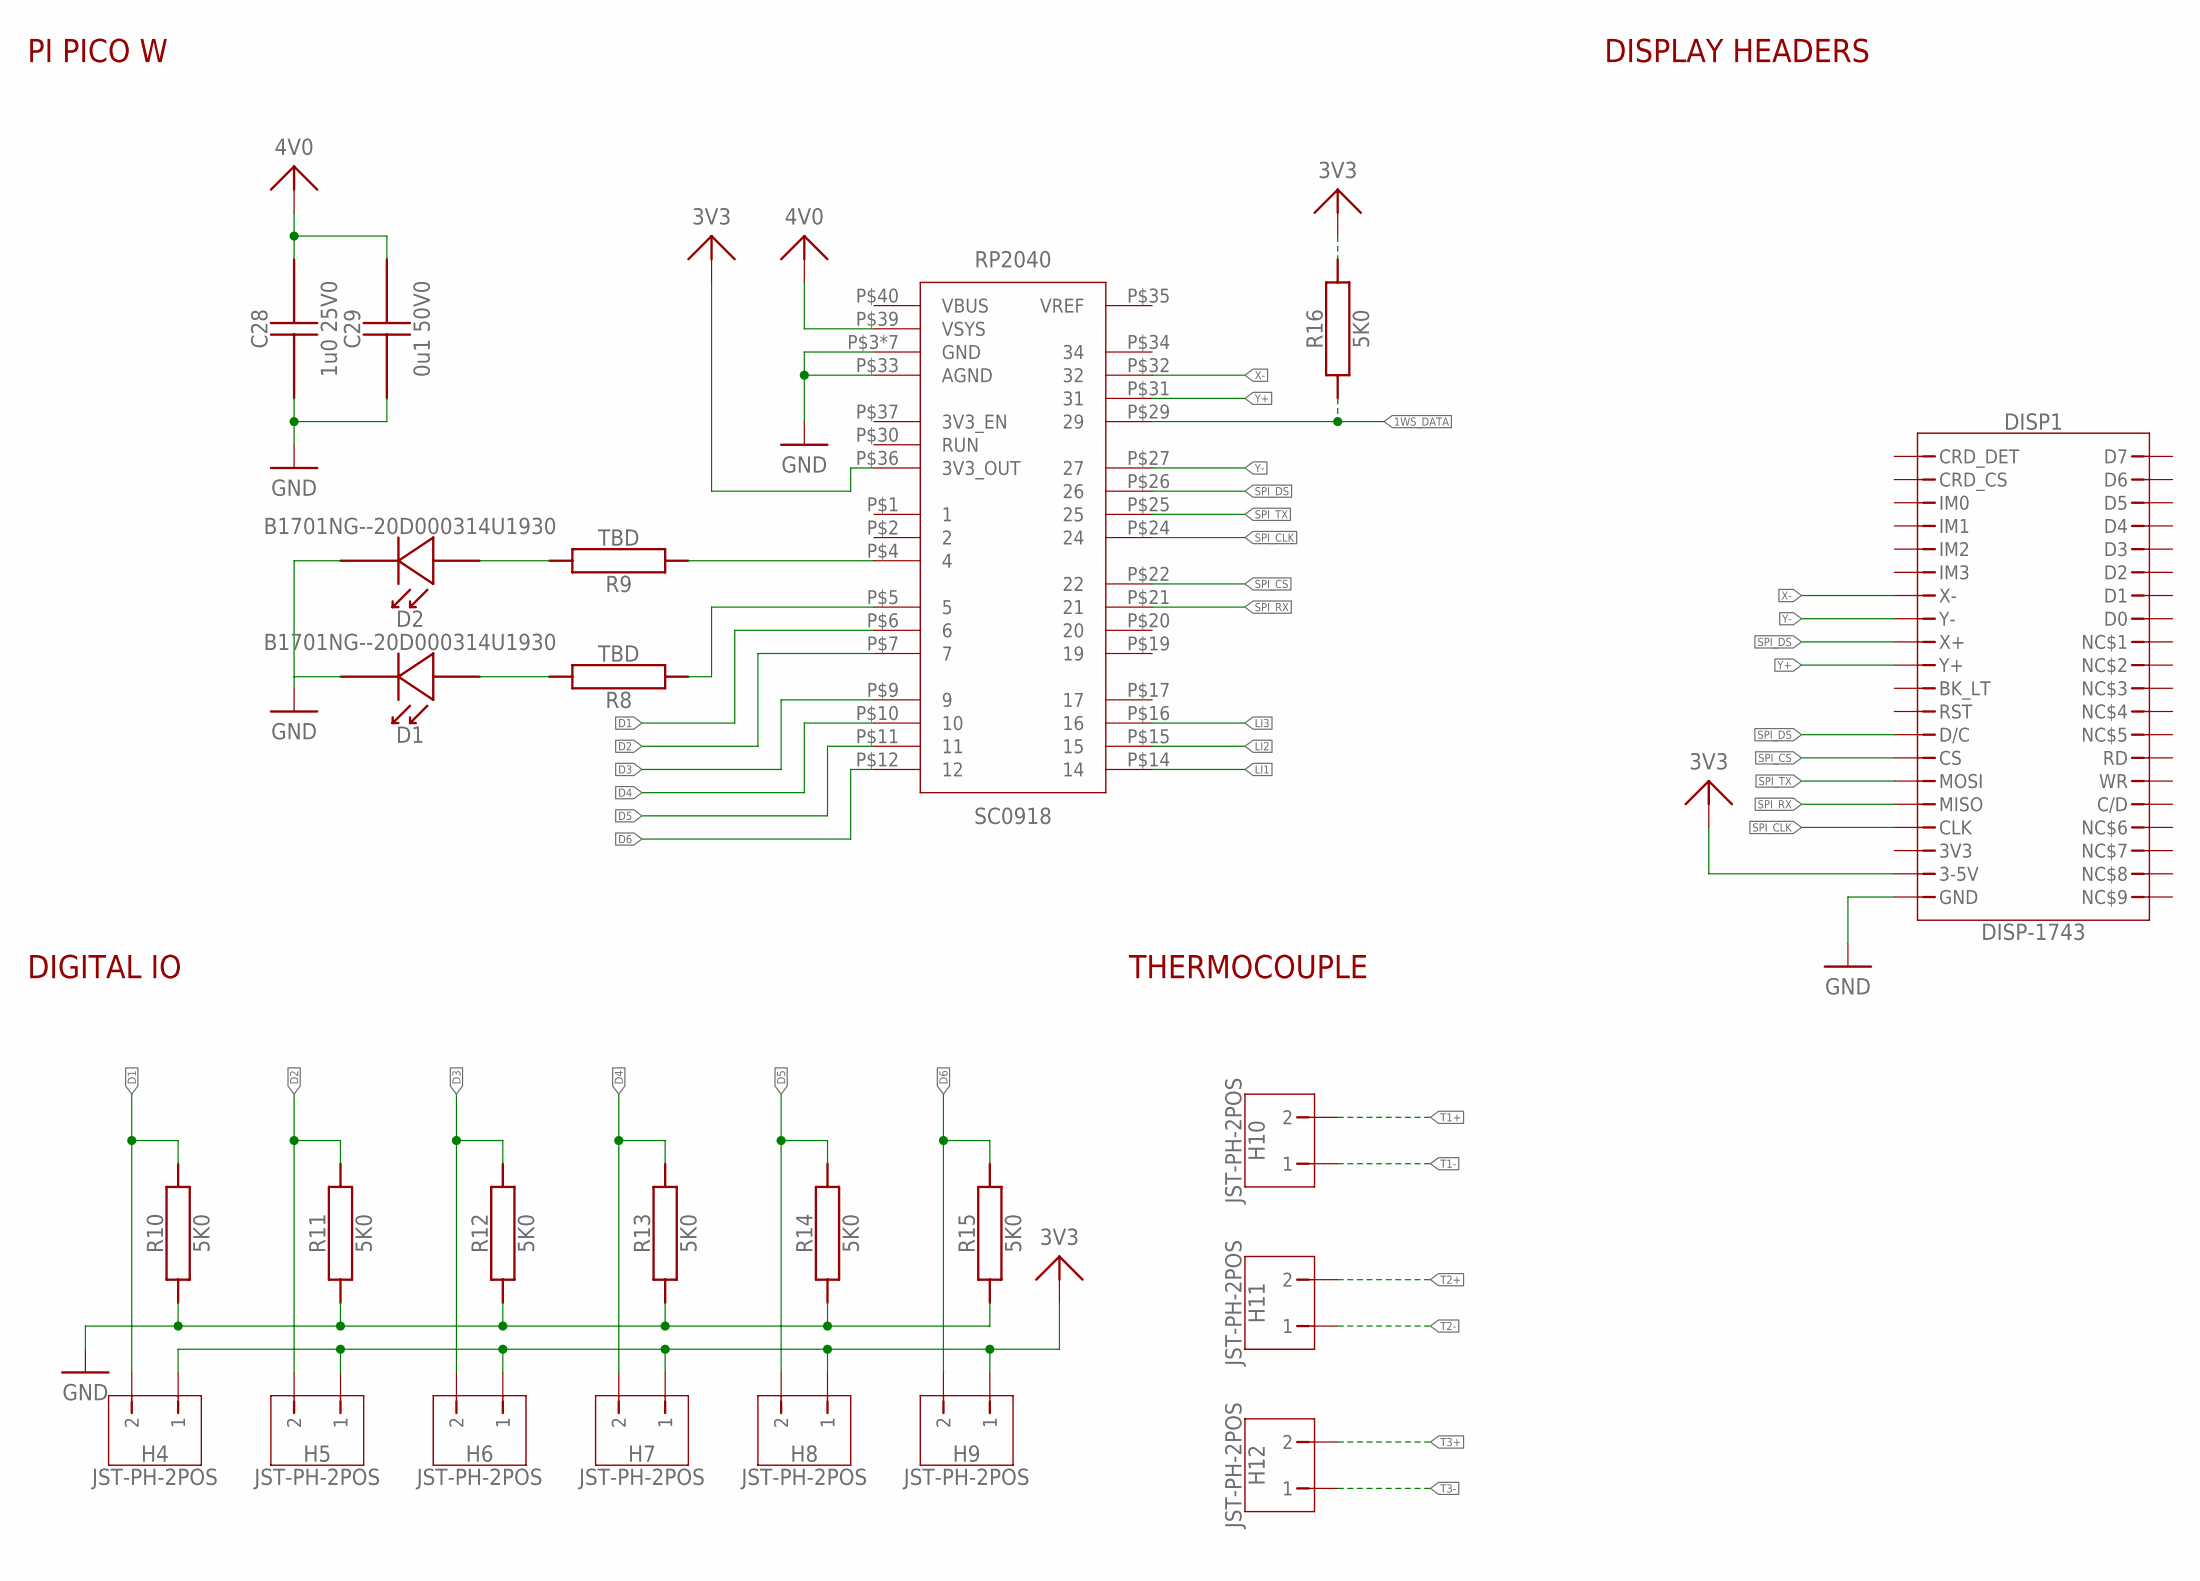
[picture p3: schematic BespokeToast_Rev-0_v77.sch, sheet 3, LOGIC]

Parts:
C28: 1u0 25V0; SAMSUNG_CAP-0805
C29: 0u1 50V0; SAMSUNG_CAP-0402
D1, D2: B1701NG--20D000314U1930
DISP1: DISP-1743
H4, H5, H6, H7, H8, H9, H10, H11, H12: JST-PH-2POS
R8, R9: TBD; YAGEO_RES-0402
R10, R11, R12, R13, R14, R15, R16: 5K0; YAGEO_RES-0402
RP2040: SC0918; SC0915

Connections:
1WS_DATA: R16.P$1, RP2040.P$29 (29); also elsewhere on the board
3V3: DISP1.P$19 (3-5V), H4.P$1 (1), H5.P$1 (1), H6.P$1 (1), H7.P$1 (1), H8.P$1 (1), H9.P$1 (1), R16.P$2, RP2040.P$36 (3V3_OUT)
4V0: C28.P$2, C29.P$2, RP2040.P$39 (VSYS); also elsewhere on the board
D1: H4.P$2 (2), R10.P$2, RP2040.P$6 (6)
D2: H5.P$2 (2), R11.P$2, RP2040.P$7 (7)
D3: H6.P$2 (2), R12.P$2, RP2040.P$9 (9)
D4: H7.P$2 (2), R13.P$2, RP2040.P$10 (10)
D5: H8.P$2 (2), R14.P$2, RP2040.P$11 (11)
D6: H9.P$2 (2), R15.P$2, RP2040.P$12 (12)
GND: C28.P$1, C29.P$1, D1.P$1 (VSS), D2.P$1 (VSS), DISP1.P$20 (GND), R10.P$1, R11.P$1, R12.P$1, R13.P$1, R14.P$1, R15.P$1, RP2040.P$3 (GND), RP2040.P$8 (GND), RP2040.P$13 (GND), RP2040.P$18 (GND), RP2040.P$23 (GND), RP2040.P$28 (GND), RP2040.P$33 (AGND), RP2040.P$38 (GND); also elsewhere on the board
LI1: RP2040.P$14 (14); also elsewhere on the board
LI2: RP2040.P$15 (15); also elsewhere on the board
LI3: RP2040.P$16 (16); also elsewhere on the board
unnamed: D1.P$2 (VDD), R8.P$2
unnamed: D2.P$2 (VDD), R9.P$2
unnamed: R8.P$1, RP2040.P$5 (5)
unnamed: R9.P$1, RP2040.P$4 (4)
SPI_CLK: DISP1.P$17 (CLK), RP2040.P$24 (24)
SPI_CS: DISP1.P$14 (CS), RP2040.P$22 (22)
SPI_DS: DISP1.P$9 (X+), DISP1.P$13 (D/C), RP2040.P$26 (26)
SPI_RX: DISP1.P$16 (MISO), RP2040.P$21 (21)
SPI_TX: DISP1.P$15 (MOSI), RP2040.P$25 (25)
T1+: H10.P$2 (2); also elsewhere on the board
T1-: H10.P$1 (1); also elsewhere on the board
T2+: H11.P$2 (2); also elsewhere on the board
T2-: H11.P$1 (1); also elsewhere on the board
T3+: H12.P$2 (2); also elsewhere on the board
T3-: H12.P$1 (1); also elsewhere on the board
X-: DISP1.P$7 (X-), RP2040.P$32 (32)
Y+: DISP1.P$10 (Y+), RP2040.P$31 (31)
Y-: DISP1.P$8 (Y-), RP2040.P$27 (27)

Notes on the sheet:
DIGITAL IO
PI PICO W
DISPLAY HEADERS
THERMOCOUPLE

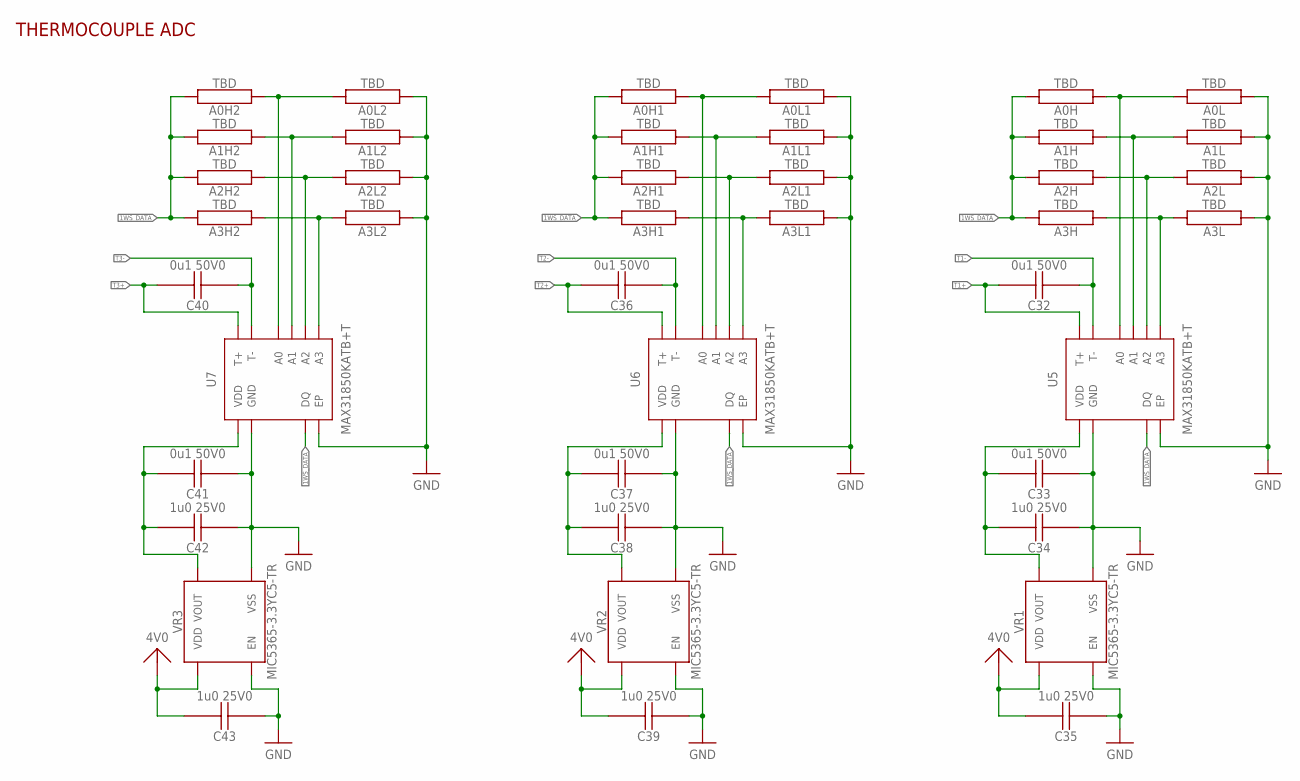
[picture p4: schematic BespokeToast_Rev-0_v77.sch, sheet 4, THERMOCOUPLE ADC]

Parts:
A0H, A0H1, A0H2, A0L, A0L1, A0L2, A1H, A1H1, A1H2, A1L, A1L1, A1L2, A2H, A2H1, A2H2, A2L, A2L1, A2L2, A3H, A3H1, A3H2, A3L, A3L1, A3L2: TBD; YAGEO_RES-0402
C32, C33, C36, C37, C40, C41: 0u1 50V0; SAMSUNG_CAP-0402
C34, C35, C38, C39, C42, C43: 1u0 25V0; SAMSUNG_CAP-0603
U5, U6, U7: MAX31850KATB+T; MAX31850
VR1, VR2, VR3: MIC5365-3.3YC5-TR

Connections:
1WS_DATA: A0H.P$2, A0H1.P$2, A0H2.P$2, A1H.P$2, A1H1.P$2, A1H2.P$2, A2H.P$2, A2H1.P$2, A2H2.P$2, A3H.P$2, A3H1.P$2, A3H2.P$2, U5.P$5 (DQ), U6.P$5 (DQ), U7.P$5 (DQ); also elsewhere on the board
4V0: C35.P$2, C39.P$2, C43.P$2, VR1.P$1 (VDD), VR2.P$1 (VDD), VR3.P$1 (VDD); also elsewhere on the board
GND: A0L.P$1, A0L1.P$1, A0L2.P$1, A1L.P$1, A1L1.P$1, A1L2.P$1, A2L.P$1, A2L1.P$1, A2L2.P$1, A3L.P$1, A3L1.P$1, A3L2.P$1, C33.P$1, C34.P$1, C35.P$1, C37.P$1, C38.P$1, C39.P$1, C41.P$1, C42.P$1, C43.P$1, U5.EP, U5.P$1 (GND), U6.EP, U6.P$1 (GND), U7.EP, U7.P$1 (GND), VR1.P$2 (VSS), VR1.P$3 (EN), VR2.P$2 (VSS), VR2.P$3 (EN), VR3.P$2 (VSS), VR3.P$3 (EN); also elsewhere on the board
unnamed: A0H.P$1, A0L.P$2, U5.P$6 (A0)
unnamed: A1H.P$1, A1L.P$2, U5.P$7 (A1)
unnamed: A2H.P$1, A2L.P$2, U5.P$8 (A2)
unnamed: A3H.P$1, A3L.P$2, U5.P$9 (A3)
unnamed: A0H1.P$1, A0L1.P$2, U6.P$6 (A0)
unnamed: A1H1.P$1, A1L1.P$2, U6.P$7 (A1)
unnamed: A2H1.P$1, A2L1.P$2, U6.P$8 (A2)
unnamed: A3H1.P$1, A3L1.P$2, U6.P$9 (A3)
unnamed: C33.P$2, C34.P$2, U5.P$4 (VDD), VR1.P$5 (VOUT)
unnamed: C37.P$2, C38.P$2, U6.P$4 (VDD), VR2.P$5 (VOUT)
unnamed: A0H2.P$1, A0L2.P$2, U7.P$6 (A0)
unnamed: A1H2.P$1, A1L2.P$2, U7.P$7 (A1)
unnamed: A2H2.P$1, A2L2.P$2, U7.P$8 (A2)
unnamed: A3H2.P$1, A3L2.P$2, U7.P$9 (A3)
unnamed: C41.P$2, C42.P$2, U7.P$4 (VDD), VR3.P$5 (VOUT)
T1+: C32.P$2, U5.P$3 (T+); also elsewhere on the board
T1-: C32.P$1, U5.P$2 (T-); also elsewhere on the board
T2+: C36.P$2, U6.P$3 (T+); also elsewhere on the board
T2-: C36.P$1, U6.P$2 (T-); also elsewhere on the board
T3+: C40.P$2, U7.P$3 (T+); also elsewhere on the board
T3-: C40.P$1, U7.P$2 (T-); also elsewhere on the board

Notes on the sheet:
THERMOCOUPLE ADC

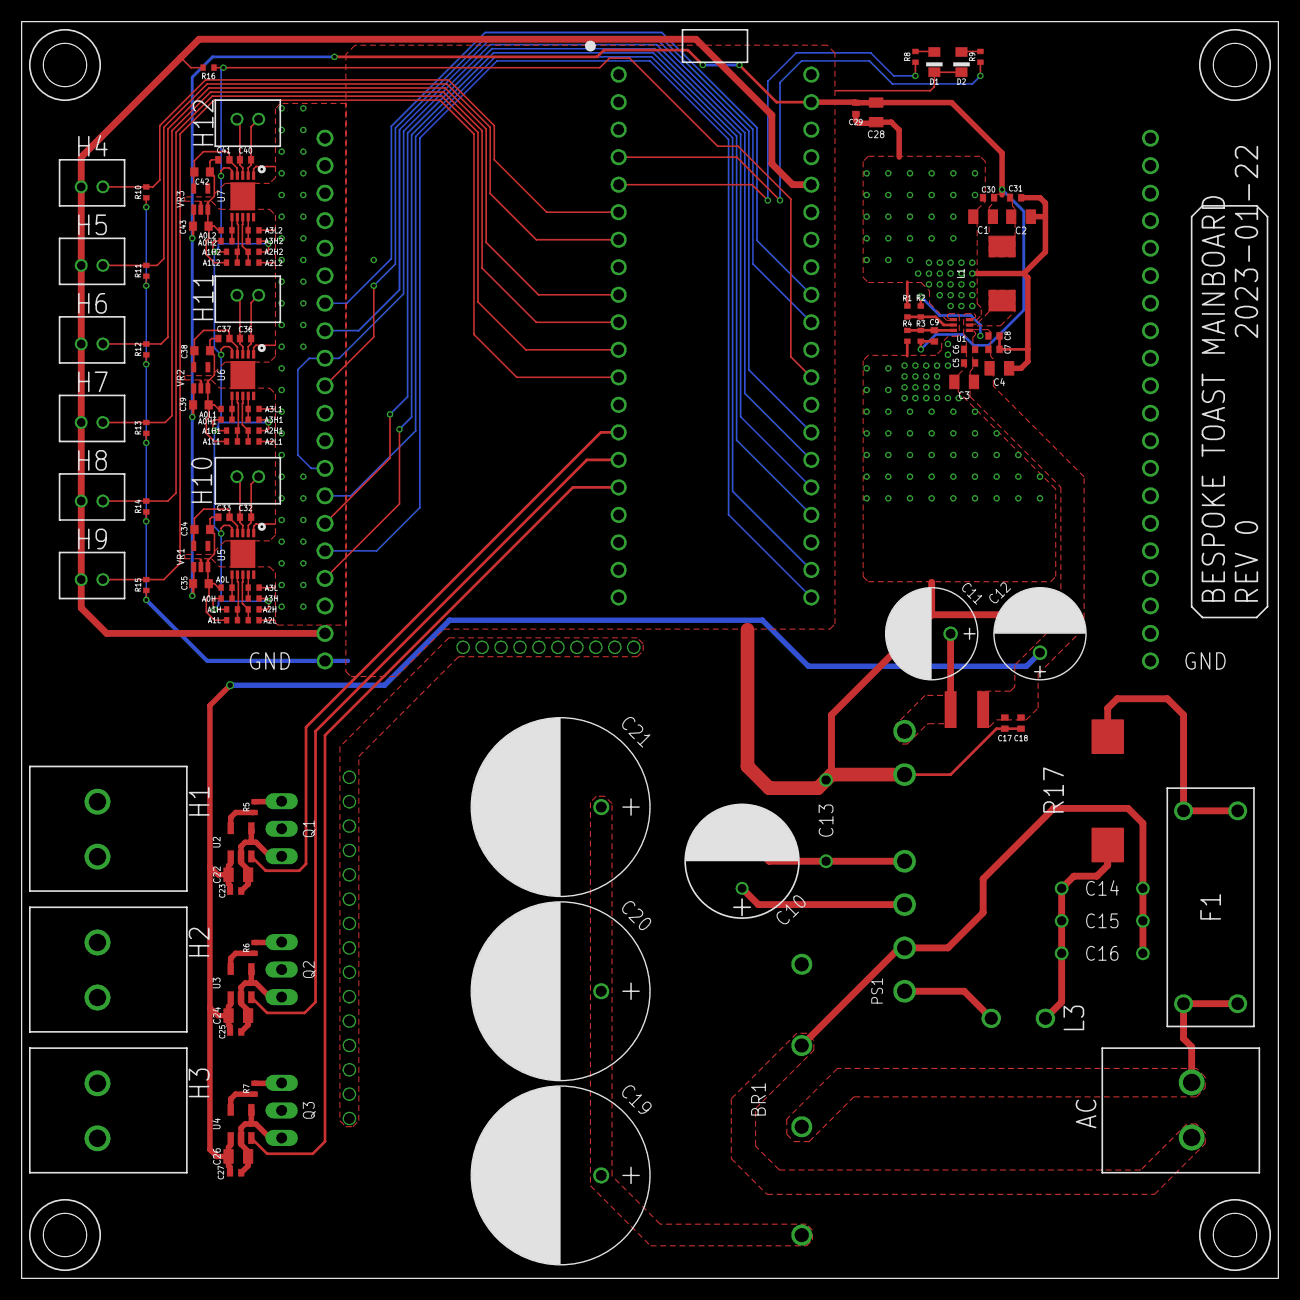
[picture p5: board BespokeToast_Rev-0_v77.brd from above]

Board: 2 copper layers, 116.0 x 116.0 mm, 120 parts (0 on the bottom side), 68 nets.
