Taeron-Systems-Inc/BespokeToast/firmware/oven/hardware.py

# SPDX-License-Identifier: MIT
"""The only module that touches the board.

Everything else in this package is plain stdlib and runs under CPython, which
is what makes the control and safety logic testable. That property is only
worth anything if this file stays the single exception — so keep board,
digitalio, busio and their kin here.

A note on fault detection, because it shapes the safety design. The amplifier
is an MCP9601 (Adafruit 5165), which reports an open or shorted probe in its
status register, and the supervisor trips at once on either. That detection
depends on the chip's VSENSE pin being wired on the breakout, which is not yet
confirmed on this oven (docs/hardware.md), so it is not the only line. The
checks below also include an I2C failure and plausibility bounds, and the rest
of the work falls to the supervisor's stall and frozen-value guards, which
catch a probe that reads plausibly but is not measuring the oven.
"""

import array
import math

import board
import busio
import digitalio
import microcontroller
import time

import adafruit_touchscreen

from adafruit_mcp9600 import MCP9600

from . import hal

RELAY_PIN = board.D4
MCP9601_ADDRESS = 0x67
MCP9601_DEVICE_ID = 0x41
I2C_FREQUENCY = 100000
THERMOCOUPLE_TYPE = "K"

_STATUS_REGISTER = 0x04
_DEVICE_ID_REGISTER = 0x20

# Anything outside this is not a temperature this oven can be at.
PLAUSIBLE_MIN_C = -20.0
PLAUSIBLE_MAX_C = 400.0


class Relay(hal.Interlocked):
    """The mains relay on D4.

    Measured on this oven: an external pulldown holds the relay de-energised
    whenever the pin is not driven, so releasing the pin — on reset, on an
    unhandled exception, on a watchdog reset — is a safe state rather than an
    undefined one.

    Everything but the pin itself is hal.Interlocked, including the hold
    the speaker takes before it is touched.
    """

    def __init__(self, pin=RELAY_PIN):
        hal.Interlocked.__init__(self)
        self._io = digitalio.DigitalInOut(pin)
        self._io.direction = digitalio.Direction.OUTPUT
        self._io.value = False

    def _drive(self, on):
        self._io.value = on

    def deinit(self):
        try:
            self._io.value = False
        finally:
            self._io.deinit()


class Thermocouple(object):
    """MCP9601 + type-K probe, reporting faults rather than hiding them."""

    def __init__(self, i2c=None, address=MCP9601_ADDRESS):
        self._i2c = i2c or busio.I2C(board.SCL, board.SDA,
                                     frequency=I2C_FREQUENCY)
        self._address = address
        # One driver serves both chips and accepts either. The status bits
        # read below are the MCP9601's: on an MCP9600 bit 4 means something
        # else and a short is never reported, so that chip is refused here
        # rather than trusted to detect what it cannot.
        self._sensor = MCP9600(self._i2c, address, THERMOCOUPLE_TYPE)
        device_id = self._register(_DEVICE_ID_REGISTER)
        if device_id != MCP9601_DEVICE_ID:
            raise RuntimeError(
                "thermocouple amplifier is not an MCP9601 (device ID 0x%02x)"
                % device_id)

    def read(self):
        faults = hal.FAULT_NONE
        hot = cold = None
        try:
            hot = self._sensor.temperature
            cold = self._sensor.ambient_temperature
        except Exception:
            # Any I2C or device error is a bus fault. Deliberately broad:
            # the supervisor's job is to refuse heat, not to diagnose.
            return hal.Reading(None, None, hal.FAULT_BUS, time.monotonic())

        try:
            faults |= hal.mcp9601_status_faults(
                self._register(_STATUS_REGISTER))
        except Exception:
            faults |= hal.FAULT_BUS

        if hot is None or not (PLAUSIBLE_MIN_C <= hot <= PLAUSIBLE_MAX_C):
            faults |= hal.FAULT_RANGE

        return hal.Reading(hot, cold, faults, time.monotonic(),
                           cpu=cpu_temperature())

    def _register(self, register):
        """The first byte of *register*: for the device ID, the ID itself."""
        buf = bytearray(1)
        while not self._i2c.try_lock():
            pass
        try:
            self._i2c.writeto_then_readfrom(
                self._address, bytes([register]), buf)
        finally:
            self._i2c.unlock()
        return buf[0]


class Touchscreen(object):
    """Resistive touch panel.

    Calibration measured on this panel rather than inherited.

    Re-derived 2026-09-01 with a person touching five crosses at known
    points. The inherited values read consistently high: mean bias +11.8 px
    in x and +5.6 px in y, and because the bias almost equalled the mean
    absolute error it was systematic offset rather than noise. Both ends of
    each axis are shifted by the same number of raw counts, which moves the
    output without changing the scale.

    Previous value, carried over from the firmware before this one and
    never checked: ((5200, 59000), (5800, 57000)).
    """

    CALIBRATION = ((7184, 60984), (6995, 58195))

    def __init__(self):
        self._ts = adafruit_touchscreen.Touchscreen(
            board.TOUCH_XL, board.TOUCH_XR, board.TOUCH_YD, board.TOUCH_YU,
            calibration=self.CALIBRATION,
            size=(board.DISPLAY.width, board.DISPLAY.height))
        self._was_down = False

    def press(self):
        """Return (x, y) once per touch, on the press edge.

        Edge-triggered deliberately: a held finger must not repeat an action,
        and START is not something to trigger twice.
        """
        point = self._ts.touch_point
        if point is None:
            self._was_down = False
            return None
        if self._was_down:
            return None
        self._was_down = True
        return (point[0], point[1])


class Speaker(object):
    """The PyPortal's onboard speaker, as a voice for oven.chime.

    One cycle of a sine wave, looped, with the pitch set by the rate it is
    played at: 32 bytes of buffer for any note, where a rendered melody
    would want kilobytes in one block. Playback is DMA, so ``tone`` returns
    at once and the control loop never waits on sound.

    The amplifier is enabled only while a note sounds. Left on, it hisses.
    """

    SAMPLES = 16
    # Fraction of full scale. Loud enough to hear across a room through the
    # enclosure; a sine at full scale on this speaker is shrill.
    VOLUME = 0.5

    def __init__(self):
        import audiocore
        import audioio
        mid = 32768
        amp = int(32767 * self.VOLUME)
        wave = array.array("H", [
            mid + int(amp * math.sin(2 * math.pi * i / self.SAMPLES))
            for i in range(self.SAMPLES)])
        self._sample = audiocore.RawSample(wave, sample_rate=8000)
        self._enable = digitalio.DigitalInOut(board.SPEAKER_ENABLE)
        self._enable.direction = digitalio.Direction.OUTPUT
        self._enable.value = False
        self._out = audioio.AudioOut(board.SPEAKER, quiescent_value=mid)

    def tone(self, hz):
        # A RawSample's rate only takes effect when play is called, so
        # every note is a fresh play.
        self._out.stop()
        self._sample.sample_rate = int(hz * self.SAMPLES)
        self._enable.value = True
        self._out.play(self._sample, loop=True)

    def quiet(self):
        self._out.stop()
        self._enable.value = False


class Clock(object):
    def monotonic(self):
        return time.monotonic()


def cpu_temperature():
    """SAMD51 die temperature — a second, independent read on how warm the
    enclosure is getting, free of the thermocouple's cold junction."""
    try:
        return microcontroller.cpu.temperature
    except Exception:
        return None


class Hardware(object):
    """Everything the application needs, assembled and in a safe state."""

    def __init__(self):
        self.relay = Relay()          # first: the pin is claimed and driven low
        self.clock = Clock()
        self.sensor = Thermocouple()
        self.touch = Touchscreen()
        # Optional. The oven is no less safe without sound, so a speaker
        # that will not start costs the sound and nothing else. Loaded with
        # the relay held open, like every other speaker call: see
        # hal.Interlocked.
        self.relay.hold_off("speaker setup")
        try:
            self.speaker = Speaker()
        except Exception as e:
            print("# speaker: not available (%r); runs will be silent" % e)
            self.speaker = None
        self.relay.release("speaker setup")

    def safe(self):
        self.relay.off()
