Taeron-Systems-Inc/BespokeToast/firmware/code.py

# SPDX-License-Identifier: MIT
"""BespokeToast entry point.

Assembles the hardware, wires the application to the interface, and runs the
loop. Deliberately thin: everything that decides anything lives in oven/,
where it can be tested without a board.
"""

import gc
import json
import os
import sys
import time

import board
import supervisor

from oven import bringup as bringup_mod
from oven import chime as chime_mod
from oven.app import App, STATE_IDLE, STATE_RUNNING, STATE_PREHEAT, \
    STATE_PRECHARGE, STATE_COOLDOWN, STATE_REPORT, STATE_FAULT
from oven.controller import Controller, FeedForward, PID
from oven.hardware import Hardware, cpu_temperature
from oven.history import History
from oven.metrics import Limits as MetricLimits
from oven import profilestore
from oven.profile import Profile, choose, latest, offered, \
    scan as scan_profiles, versions_of
from oven.ui import layout as L
from oven.ui import theme as T
from oven.ui.display import Display, preload

VERSION = "v2.0"

# Commands accepted on the serial console, one per line. This exists so a run
# can be started and supervised from a host when nobody is standing at the
# oven. ABORT is unconditional and always available -- that is the point of
# having it at all.
#
# Reading the console does not disable the REPL: Ctrl-C still interrupts.
PROFILE_DIR = "/profiles"
CHARACTERISATION = "/characterisation.json"


def remember_boot_mode():
    """Record, for the next boot, that no host is attached.

    boot.py cannot tell -- usb_connected reads False there because
    CircuitPython starts USB afterwards. Here it is reliable, so the answer
    is written to non-volatile memory, which does not care who owns the
    filesystem. The cost is a boot of lag after the cable comes out.

    Only that direction is automatic, and that is a change. This used to
    write HOST whenever it saw a cable, which meant an oven with a
    programming cable left in could never record a run: every boot rewrote
    the mode back to HOST, so every subsequent boot came up with the volume
    owned by the host and logging off. It showed on the power-on screen as
    a red FAIL beside "run logging", on an oven that was working perfectly.

    Taking the volume is now something a person asks for, once, and it
    sticks: `python3 tools/deploy.py <mount>` claims it and
    `--standalone` hands it back. That is safe in a way it was not when
    this was written -- the reclaim goes over the serial console, which is
    available exactly when a cable is attached, and it is now the ordinary
    path rather than a rescue. Unset or corrupt nvm still reads as HOST, so
    a fresh board is programmable without knowing any of this.
    """
    try:
        import microcontroller
        from oven.bootmode import STANDALONE, decode, encode, name
        if supervisor.runtime.usb_connected:
            return
        if decode(microcontroller.nvm) != STANDALONE:
            microcontroller.nvm[0:2] = encode(STANDALONE)
            print("# boot mode recorded as %s; it takes effect on the next "
                  "hard reset" % name(STANDALONE))
    except Exception as e:
        print("# WARNING could not record the boot mode (%r); the oven may "
              "not be able to log its next run" % e)


def set_rtc(epoch_seconds):
    """Put the network's answer into the board's own clock.

    This used to restart the program afterwards, and the reason was real at
    the time: importing the WiFi stack cost 7280 bytes measured, sys.modules
    held them for the life of the program even after the connection was
    dropped, and that was 22% of a heap which then had to build a run
    screen. It showed immediately -- on the boot that first synced the
    clock, the font metrics failed to load and every button label fell back
    to being centred by estimate. Deleting the modules by hand made it
    worse, 25392 free becoming 11472.

    The reason has expired twice over. The radio now stays associated for
    the whole session, so the modules are resident whatever happens here and
    the restart freed memory that was re-spent seconds later by the page.
    And the frozen build moved the numbers: measured on the board with the
    server up, 60368 free with a largest block of 8624.

    What the restart cost was a second cold boot on every power cycle, with
    the self-test panel frozen on screen for the whole of the first one.
    That is what "it boots up twice and looks hung" was.
    """
    try:
        import rtc
        import time as _time
        rtc.RTC().datetime = _time.localtime(epoch_seconds)
    except Exception as e:
        print("# clock: could not set the RTC (%r); the time will not "
              "survive this restart" % e)
        return False
    print("# clock: %s UTC" % now_iso())
    return True


def now_epoch():
    """Seconds since 1970, or None if the clock has never been set.

    Recorded beside the local stamp because it is the one form nothing has
    to parse: no timezone, no format, no ambiguity about which of two
    numbers in a date is the month.
    """
    if not clock_is_set():
        return None
    try:
        return int(time.time())
    except Exception as e:
        print("# clock: cannot read the epoch (%r)" % e)
        return None


def now_iso():
    """The current UTC time as a sortable stamp, or None if unknown.

    Reads the RTC rather than anything the network handed back. The
    bring-up reports a time only on the boot that actually fetched one --
    never when the clock was already set and the radio was deliberately not
    asked -- so relying on that value put "monotonic+" in the header of
    every log except the first after a power cut, which is exactly
    backwards.
    """
    try:
        import rtc
        import time as _time
        from oven import timesync
        now = rtc.RTC().datetime
        if now.tm_year < 2025:
            return None
        return timesync.iso(_time.mktime(now))
    except Exception as e:
        print("# clock: cannot read the time (%r)" % e)
        return None


# How often the web service checks that the radio is still associated.
# Long enough that it costs nothing -- one SPI call a minute on the idle
# path -- and short enough that a silent drop is noticed in a minute rather
# than the eight hours it went unnoticed on 2026-09-16.
LIVENESS_INTERVAL_S = 60.0

# How long to wait before trying the network again after a bring-up fails.
# Not zero: a failed scan-and-join costs three join attempts of 10 s, and
# retrying flat out would spend the idle loop on the radio. Not never, which
# is what it used to be -- see the retry note in WebService.advance.
RETRY_INTERVAL_S = 120.0


class WebService(object):
    """The oven's own web page, served only while it is idle.

    The oven is the only machine present in normal operation: USB is
    power-only behind a panel, and the network it sits on does not reach
    the machine that builds its firmware. So a browser pointed at the oven
    is how anyone gets a run log off it.

    Served only while idle. Not a preference: an SPI call to the
    co-processor can block for 227 ms against a 250 ms control deadline, so
    polling a socket during a profile would put network latency inside the
    loop that decides when the heater switches off.

    The radio itself is NOT brought down for a run. It used to be, and
    bringing it back up cost a measured 24.22 s of frozen main loop on the
    one transition that does it -- back to idle, which is the DONE button
    at the end of every run. Staying associated costs 1472 bytes and no
    loop time, because the driver touches SPI only when it is called.
    """

    def __init__(self, logs, profiles_ref, status_fn):
        self.logs = logs
        self.profiles_ref = profiles_ref
        self.status_fn = status_fn
        # Called after the page changes what is in /profiles, so the oven
        # can move its selection off a profile that was archived or
        # deleted, or onto the version that was just uploaded.
        self.on_catalogue = None
        self.radio = None
        self.server = None
        self.address = None
        self.bringup = None
        self.on_epoch = None
        self.status = None
        # When the association was last confirmed still to exist. See
        # _still_associated.
        self._checked_at = None
        # When to try again after a failed bring-up, or None.
        self._retry_at = None

    def advance(self):
        """One step towards being up, or one poll once it is.

        Called from the loop, while idle, and it returns immediately. That
        is the whole design: bringing the radio up used to be one blocking
        call of a measured 24.22 s, done twice at boot -- once for the clock
        and once for the page -- with a reload between them. The oven
        answered nothing for the whole of it and looked hung, which is
        exactly what it was reported as.

        Returns False when there is no point calling again.
        """
        if self._retry_at is not None:
            if time.monotonic() < self._retry_at:
                return True
            self._retry_at = None
        if self.server is not None:
            if not self._still_associated():
                # Gone. stop() clears the server and the bring-up, so the
                # next pass starts a fresh one and the screen goes back to
                # saying which stage it is in.
                #
                # Returns True, not False. The caller keeps calling advance()
                # only while it returns True, so False means "stop trying" --
                # which is right for a network that is not there, and exactly
                # wrong here, where the whole point is to try again. Written
                # as False first, which would have turned an eight-hour
                # silent drop into a permanent one.
                print("# web: the radio is no longer associated; rejoining")
                self.stop()
                return True
            self.poll()
            return True
        if self.bringup is None:
            return self._begin()

        state = self.bringup.step()
        self.status = self.bringup.status_text()
        if state == bringup_mod.FAILED:
            # Try again later; do NOT return False. The caller keeps calling
            # advance() only while it returns True, and web_wanted is set
            # True exactly once at startup and never restored -- so returning
            # False here took the oven off the network until a human rebooted
            # it. A boot that loses a scan to a busy channel, or meets an
            # access point still coming up, was permanently offline while
            # sitting there healthy and reporting no fault. The liveness
            # check does not save it either: that only guards an association
            # lost AFTER a server exists.
            print("# web: no network (%s); retrying in %.0f s"
                  % (self.bringup.detail, RETRY_INTERVAL_S))
            self.bringup = None
            self.stop()
            self._retry_at = time.monotonic() + RETRY_INTERVAL_S
            return True
        if state != bringup_mod.READY:
            return True

        # Joined. The clock, if it was asked for and the network had one to
        # give, then the page.
        if self.bringup.epoch is not None:
            if self.on_epoch is not None:
                self.on_epoch(self.bringup.epoch)
        elif self.bringup.want_clock:
            # Only worth saying when a clock was actually wanted. Printing
            # the bring-up's detail unconditionally reported "clock:
            # starting" on every warm boot, which reads as a failure and is
            # the clock already being set.
            print("# clock: %s" % self.bringup.detail)
        self.address = self.bringup.ip
        self.bringup = None
        return self._serve()

    def _begin(self):
        try:
            from oven import netconfig
            from oven.radio import Radio
        except Exception as e:
            print("# web: not available (%r)" % e)
            return False
        networks = netconfig.load()
        if not networks:
            return False
        self.radio = Radio()
        self.bringup = bringup_mod.Bringup(
            networks, self.radio, want_clock=not clock_is_set())
        self.status = self.bringup.status_text()
        return True

    def _serve(self):
        try:
            from adafruit_esp32spi import adafruit_esp32spi_wsgiserver as wsgi
            wsgi.set_interface(self.radio._hardware())
            self.server = wsgi.WSGIServer(80, application=self._app)
            self.server.start()
            print("# web: http://%s/ -- runs and profiles, while idle"
                  % self.address)
            self.status = self.address
            return True
        except Exception as e:
            print("# web: could not start (%r)" % e)
            self.stop()
            return False

    def _still_associated(self):
        """Is the radio actually still on the network?

        Nothing used to ask. On 2026-09-16 the access point restarted its
        radio, the oven lost its association, and for eight hours it went on
        reporting a joined network and a live address while answering
        nothing and being absent from the access point's station table. Its
        own console could not be told apart from a healthy one. Restarting
        code.py rejoined it in seconds, so the recovery was always there --
        only the noticing was missing.

        One SPI call, and at most one per LIVENESS_INTERVAL_S. This runs on
        the idle path only, because advance() is not called during a run;
        the 227 ms an SPI call can cost must never land inside the control
        loop. A co-processor that raises rather than answering is treated as
        gone, which is what the library does with a busy or wedged one.
        """
        now = time.monotonic()
        if self._checked_at is not None and \
                now - self._checked_at < LIVENESS_INTERVAL_S:
            return True
        self._checked_at = now
        if self.radio is None:
            return False
        try:
            return bool(self.radio._hardware().is_connected)
        except Exception as e:
            print("# web: cannot ask the radio if it is associated (%r)" % e)
            return False

    def stop(self):
        # _retry_at is deliberately NOT cleared here: stop() is how a failed
        # bring-up tears itself down, and clearing it would retry instantly.
        self._checked_at = None
        self.server = None
        self.bringup = None
        if self.radio is not None:
            self.radio.close()
            self.radio = None
        self.address = None
        self.status = None

    def poll(self):
        if self.server is None:
            return
        try:
            self.server.update_poll()
        except Exception as e:
            print("# web: stopped serving (%r)" % e)
            self.stop()

    def _app(self, environ, start_response):
        from oven import webapp
        method = environ.get("REQUEST_METHOD", "GET")
        path = environ.get("PATH_INFO", "/")
        kind, arg = webapp.route(method, path)

        if kind == "log":
            known = self.logs.runs() if self.logs else []
            name = webapp.safe_log_name(arg, known)
            if name is None:
                start_response("404 Not Found", [("Content-Type", "text/plain")])
                return [b"no such run"]
            # Saved under the name the page offered, not the name on
            # flash. A file called .sent tells whoever downloaded it
            # nothing, and will not open in the thing they open CSVs with.
            start_response("200 OK", [
                ("Content-Type", "text/csv"),
                ("Content-Disposition", 'attachment; filename="%s"' % name)])
            # Streamed off the filesystem: a run log is tens of kilobytes
            # and must never exist in memory as one object.
            return self.logs.chunks(name, webapp.CHUNK)

        if kind == "get-profile":
            # Served so that "what does a profile look like?" is answered by
            # a real one rather than by prose that can go stale. Only the
            # profiles offered at the oven, matched by filename against the
            # catalogue, so this cannot be talked into reading anything else
            # off the filesystem.
            wanted = None
            for ref in self._listed():
                if ref.filename == arg:
                    wanted = ref.path
                    break
            if wanted is None:
                start_response("404 Not Found",
                               [("Content-Type", "text/plain")])
                return [b"no such profile"]
            try:
                with open(wanted, "r") as f:
                    body = f.read()
            except OSError as e:
                print("# web: cannot read %s (%r)" % (wanted, e))
                start_response("500 Internal Server Error",
                               [("Content-Type", "text/plain")])
                return [b"could not read it"]
            start_response("200 OK", [("Content-Type", "application/json")])
            # In pieces, like everything else here: a profile is up to
            # 2.5 kB and one contiguous bytes object of that is the
            # allocation this page has failed on before.
            return [body[i:i + webapp.CHUNK].encode("utf-8")
                    for i in range(0, len(body), webapp.CHUNK)]

        if kind == "get-bundle":
            refs = [r for r in self._listed() if r.stem == arg]
            if not refs:
                start_response("404 Not Found",
                               [("Content-Type", "text/plain")])
                return [b"no such profile"]
            start_response("200 OK", [
                ("Content-Type", "application/json"),
                ("Content-Disposition",
                 'attachment; filename="%s-all-versions.json"' % arg)])
            # Streamed: every version at once is several times the largest
            # block this heap can be relied on for.
            return profilestore.bundle_chunks(refs, arg, webapp.CHUNK)

        if kind in ("archive", "unarchive", "delete-version",
                    "delete-profile"):
            return self._change(kind, arg, start_response)

        if kind == "index":
            runs = []
            if self.logs:
                # Newest first: whoever loads this page has almost always
                # just finished a run and wants that one.
                for name in reversed(self.logs.runs()):
                    head = self.logs.header(name)
                    # started_at_epoch is what the header writes now;
                    # started_at is what it wrote before 2026-09-08. Both,
                    # or the older runs lose their dates -- which is
                    # exactly what happened.
                    runs.append((name, self.logs.size(name),
                                 head.get("started_at_epoch")
                                 or head.get("started_at"),
                                 head.get("profile")))
            # Name and filename: the filename makes each one a link to the
            # profile itself, which is the only description of the format
            # that cannot drift from the format.
            refs = self._listed()
            profiles = [webapp.profile_entry(
                r.name, r.stem, r.archived,
                [(v.version, v.filename) for v in versions_of(refs, r.stem)])
                for r in latest(refs)]
            refs = None
            # The only thing worth saying at the top of the page, and only
            # when it is true: an unset clock means every date below was
            # written by a board that did not know the date.
            warning = None
            if not clock_is_set():
                warning = ("This oven's clock is not set, so the dates "
                           "below are not to be trusted.")
            # Returned in pieces, never as one string: the whole page is
            # 3 kB and asking the heap for that in one block is what made
            # it answer one request in four.
            parts = webapp.index_parts(runs, profiles, warning=warning)
            start_response("200 OK", [("Content-Type", "text/html")])
            return [piece.encode("utf-8") for piece in parts]

        if kind == "put-profile":
            body = None
            try:
                length = int(environ.get("CONTENT_LENGTH") or 0)
            except ValueError:
                print("# web: upload sent a Content-Length that is not a "
                      "number (%r); treating it as empty"
                      % environ.get("CONTENT_LENGTH"))
                length = 0
            if length > webapp.MAX_PROFILE_BYTES:
                page = webapp.result_page(
                    "Too big",
                    "That is %d bytes and the limit is %d. The body is not "
                    "read at all past the limit, so nothing was written."
                    % (length, webapp.MAX_PROFILE_BYTES), ok=False)
                start_response("413 Payload Too Large",
                               [("Content-Type", "text/html")])
                return [page.encode("utf-8")]
            try:
                stream = environ.get("wsgi.input")
                body = stream.read(length) if stream and length else None
                if isinstance(body, bytes):
                    body = body.decode("utf-8")
            except Exception as e:
                body = None
                print("# web: could not read the uploaded profile (%r)" % e)

            filename, data, rest = webapp.accept_profile(body, Profile.from_dict)
            if filename is None:
                page = webapp.result_page("Not kept", rest, ok=False)
                start_response("400 Bad Request",
                               [("Content-Type", "text/html")])
                return [page.encode("utf-8")]

            # The device can only write to its own filesystem when it owns
            # it, which is when no host is attached. Saying so beats an
            # OSError 30 that reads like a broken oven.
            if not storage_is_writable():
                page = webapp.result_page(
                    "Cannot write",
                    "The oven does not own its filesystem right now, which "
                    "happens while it is plugged into a computer. Unplug it "
                    "and send this again.", ok=False)
                start_response("409 Conflict",
                               [("Content-Type", "text/html")])
                return [page.encode("utf-8")]

            # A new version, never an overwrite: the slug filename only
            # decides which profile this is when no listed profile already
            # has the name.
            filename, version = profilestore.new_version_filename(
                self.profiles_ref[1], data.get("name", ""), filename)
            if profilestore.reserved(self.profiles_ref[1], filename):
                page = webapp.result_page(
                    "Not kept", "%s is the diagnostic profile's name; give "
                    "this one another." % data.get("name", filename), ok=False)
                start_response("400 Bad Request",
                               [("Content-Type", "text/html")])
                return [page.encode("utf-8")]
            path = "%s/%s" % (webapp.PROFILE_DIR, filename)
            try:
                handle = open(path, "w")
                handle.write(json.dumps(data))
                handle.close()
            except Exception as e:
                page = webapp.result_page(
                    "Not kept", "could not write %s (%r)" % (filename, e),
                    ok=False)
                start_response("500 Internal Server Error",
                               [("Content-Type", "text/html")])
                return [page.encode("utf-8")]

            # The catalogue is read at startup, so a profile written now is
            # invisible until it is read again.
            self._rescan()
            archived = False
            for r in self.profiles_ref[1]:
                if r.filename == filename:
                    archived = r.archived
            if version > 1:
                detail = ("%s is on the oven as version %d (%s). The newest "
                          "version is the one that runs, so this replaces "
                          "the older ones at the oven; they stay on the "
                          "page until you delete them."
                          % (data.get("name", filename), version, filename))
            else:
                detail = ("%s is on the oven as %s. Select it at the oven "
                          "to use it." % (data.get("name", filename),
                                          filename))
            if archived:
                detail += (" It is archived, so it is not offered at the "
                           "oven until you unarchive it.")
            page = webapp.result_page(
                "Version %d added" % version if version > 1 else "Added",
                detail, rest)
            start_response("200 OK", [("Content-Type", "text/html")])
            return [page.encode("utf-8")]

        if kind == "status":
            start_response("200 OK", [("Content-Type", "text/plain")])
            return [self.status_fn().encode("utf-8")]

        start_response("404 Not Found", [("Content-Type", "text/plain")])
        return [b"not found"]

    def _listed(self):
        """Every version the page manages. DIAGNOSTIC is not one of them,
        for the same reason it is not offered at the oven."""
        return [r for r in self.profiles_ref[1] if not r.diagnostic]

    def _rescan(self):
        try:
            self.profiles_ref[1][:] = scan_profiles(PROFILE_DIR)
        except Exception as e:
            print("# web: /profiles changed but the catalogue did not "
                  "reload (%r)" % e)
            return
        if self.on_catalogue is not None:
            self.on_catalogue()

    def _change(self, kind, arg, start_response):
        """Archive, unarchive or delete, then say what happened."""
        from oven import webapp

        def reply(status, heading, detail, ok):
            start_response(status, [("Content-Type", "text/html")])
            return [webapp.result_page(heading, detail, ok=ok)
                    .encode("utf-8")]

        if not storage_is_writable():
            return reply("409 Conflict", "Cannot write",
                         "The oven does not own its filesystem right now, "
                         "which happens while it is plugged into a computer. "
                         "Unplug it and try again.", False)
        refs = self._listed()
        name = arg
        for r in refs:
            if r.stem == arg or r.filename == arg:
                name = r.name
        try:
            if kind == "archive":
                why = profilestore.set_archived(webapp.PROFILE_DIR, refs,
                                                arg, True)
                done = ("Archived", "%s is no longer offered at the oven. "
                        "Nothing about it has changed otherwise." % name)
            elif kind == "unarchive":
                why = profilestore.set_archived(webapp.PROFILE_DIR, refs,
                                                arg, False)
                done = ("Unarchived", "%s is offered at the oven again."
                        % name)
            elif kind == "delete-version":
                ref = profilestore.find_version(refs, arg)
                why = profilestore.delete_version(webapp.PROFILE_DIR, refs,
                                                  arg)
                done = ("Deleted", "Version %d of %s is gone from the oven."
                        % (ref.version if ref else 0, name))
            else:
                why = profilestore.delete_profile(webapp.PROFILE_DIR, refs,
                                                  arg)
                done = ("Deleted", "%s, every version of it, is gone from "
                        "the oven." % name)
        except Exception as e:
            print("# web: %s %s failed (%r)" % (kind, arg, e))
            self._rescan()
            return reply("500 Internal Server Error", "Not done",
                         "could not change %s (%r)" % (arg, e), False)
        refs = None
        if why is not None:
            return reply("404 Not Found", "Not done", why, False)
        self._rescan()
        print("# web: %s %s" % (kind, arg))
        return reply("200 OK", done[0], done[1], True)


def uploader_pending(logs):
    """How many runs are waiting, without importing the radio."""
    try:
        from oven import uploader
        return uploader.pending(logs.runs(), logs.sent())
    except Exception as e:
        print("# archive: cannot list pending runs (%r)" % e)
        return []


def upload_finished_runs(logs, state, heating, radio=None):
    """Send any runs the oven has kept but not yet handed over.

    Only when the oven is idle and not heating -- netconfig.may_connect
    decides that, and the reason is in its docstring. An SPI call to the
    co-processor can block for 227 ms against a 250 ms control deadline,
    so the radio has no business being up while a profile is running.

    A log is marked sent only on a 2xx. Anything else leaves it pending,
    because marking it wrongly means the oven's copy is the only one and
    the next run's eviction may delete it.

    *radio* is the one the web service already has associated, and it is
    required. This used to construct its own, scan and join -- a second
    independent bring-up, on the return to idle, which is the DONE press at
    the end of every run. Two ESP_SPIcontrol objects on the same pins is
    also how you get "ESP_CS in use" now that the first one never goes
    away. Archiving is switched off on this oven, so that never fired; it
    would have on the day somebody turned it on.
    """
    if logs is None:
        return 0
    if radio is None:
        return 0
    try:
        from oven import netconfig, uploader
    except Exception as e:
        print("# archive: no networking available (%r)" % e)
        return 0

    endpoint = netconfig.archive()
    if endpoint is None:
        return 0
    if not netconfig.may_connect(state, heating):
        return 0
    waiting = uploader.pending(logs.runs(), logs.sent())
    if not waiting:
        return 0

    host, port, path = endpoint
    sent = 0
    print("# archive: uploading %d run(s) to %s:%d%s"
          % (len(waiting), host, port, path))
    for name in waiting:
        length = logs.size(name)
        if length is None:
            continue
        ok = False
        for _ in range(uploader.MAX_ATTEMPTS):
            # A callable, not the bytes: the log is streamed off the
            # filesystem straight into the socket and never exists as
            # one object. Reading a 26 kB run whole failed with
            # MemoryError with the radio up.
            if uploader.succeeded(
                    radio.post(host, port, path, name,
                               lambda n=name: logs.chunks(n),
                               length=length)):
                ok = True
                break
        if not ok:
            print("# archive: %s not accepted; keeping it" % name)
            break          # a receiver that is refusing will refuse the rest
        if logs.mark_sent(name):
            sent += 1
            print("# archive: sent %s" % name)
    return sent


def clock_is_set():
    """Whether this board already knows the date.

    CircuitPython's RTC keeps running as long as the board has power, and
    this oven is powered continuously -- USB carries 5 V from an internal
    converter even with no data host. So the clock survives soft resets and
    auto-reloads, and only a power cut clears it.

    A microcontroller.reset() clears it too -- observed, three times in a
    row, each hard reset coming back to "clock: not set" and re-syncing.
    That costs a boot two radio bring-ups instead of one, about 50 s, and
    it does not happen in service because nothing hard-resets the oven
    there. It happens constantly while programming, which is the only
    reason it is worth writing down.
    """
    try:
        import rtc
        from oven import timesync
        now = rtc.RTC().datetime
        return now.tm_year >= 2025
    except Exception as e:
        # No rtc module, or it has never been set. Either way the answer is
        # "no", and the caller will go and ask the network.
        print("# clock: not set (%r)" % e)
        return False


def storage_is_writable():
    """Can the device write to its own filesystem?

    Only when CIRCUITPY is not mounted writable by a host. Asking directly is
    better than assuming: the answer decides whether runs are recorded, and a
    silent no would look exactly like a logging bug later.
    """
    probe = "/.write-probe"
    try:
        with open(probe, "w") as f:
            f.write("x")
        os.remove(probe)
        return True
    except OSError:
        return False


def load_characterisation():
    """The measured plant model.

    Without it the controller falls back to a crude straight-line estimate of
    the oven, which will track badly and could miss a peak entirely. That is
    far too significant to happen quietly.
    """
    try:
        with open(CHARACTERISATION) as f:
            return json.load(f)
    except Exception as e:
        print("# WARNING no %s (%r): falling back to an ESTIMATED oven "
              "model. Tracking will be poor." % (CHARACTERISATION, e))
        return None


def load_profiles():
    """Catalogue the profiles without keeping them.

    Each file is parsed and validated here, so a broken profile is reported
    at boot rather than when someone presses START with a board in the oven
    -- but only the name and a couple of flags are retained. Holding all ten
    cost 24 kB of a heap with about 180 kB in it, measured on the device,
    for nine profiles nobody had selected.
    """
    return scan_profiles(PROFILE_DIR)


HARDWARE = None


def load_element_model(characterisation):
    """The identified two-state model from the characterisation, or None
    (and a line on the console saying why)."""
    if not characterisation or not characterisation.get("element_model"):
        print("# element model: none in the characterisation; pre-charge and "
              "predictive tracking off")
        return None
    em = characterisation["element_model"]
    try:
        from oven.elementff import ElementModel
        return ElementModel(g=em["g"], beta=em["beta"], gamma=em["gamma"],
                            d=em["d"], ambient_c=em["ambient_c"])
    except Exception as e:
        print("# element model: unusable (%r); off" % e)
        return None


def make_precharge_factory(characterisation, model=None):
    """(profile, temperature, observer) -> PreCharge, from the identified
    model.

    Returns a factory that yields None when there is nothing to charge for:
    no model in the characterisation, or a curve whose opening asks for
    less than the element already gives. Cold starts therefore go straight
    to running, which simulation says is right -- they charge for a second
    or two and stand aside.
    """
    if model is None:
        model = load_element_model(characterisation)
    if model is None:
        return None
    from oven.elementff import ElementObserver, PreCharge
    pc = (characterisation.get("precharge") or {}) if characterisation else {}
    max_s = float(pc.get("max_s", 40.0))
    margin = float(pc.get("margin", 1.0))

    def factory(profile, temp_c, observer=None):
        entry = profile.entry_time_for(temp_c)
        slope = profile.slope_at(entry)
        # The curve has to be asking for a rise. z_for is
        # rate + d*(temp - ambient), so on a flat opening the rate term
        # vanishes and the test collapses to "is the oven warmer than the
        # model's 23.5 C ambient" -- true in any warm room, for any
        # profile, however cold its target. A no-heat profile with a 10 C
        # target closed the relay for 0.6 s at full duty on 2026-09-16
        # because of this. Pre-charge exists to fill the element before a
        # ramp; where there is no ramp there is nothing to fill it for.
        if slope <= 0.0:
            return None
        need = model.z_for(slope, temp_c)
        if need <= 0.0:
            return None
        return PreCharge(observer or ElementObserver(model), need,
                         max_s=max_s, margin=margin)
    return factory


def make_observer_factory(model):
    """(profile, temperature) -> a fresh ElementObserver on *model*, so the
    controller can read the element state for the whole run. None when
    there is no model. A plain function rather than an attribute on the
    pre-charge factory: CircuitPython functions do not take attributes,
    and the board said so on the first boot that tried."""
    if model is None:
        return None
    from oven.elementff import ElementObserver

    def factory(profile, temp_c):
        return ElementObserver(model)
    return factory


def main():
    global HARDWARE
    hw = Hardware()                    # claims D4 and drives it low
    HARDWARE = hw
    display = Display(board.DISPLAY)
    # Warm the font cache here, not inside the first render: see preload().
    preload((T.FONT_READOUT, T.FONT_LARGE, T.FONT_BODY, T.FONT_SMALL))
    # Claim the chart buffer now, while the heap is whole.
    display.reserve_chart(L.CHART[2], L.CHART[3])

    # Run logging. CircuitPython can only write to CIRCUITPY when the volume
    # is NOT writable over USB, which is the opposite of what a development
    # machine wants, so on a bench-connected board this is unavailable.
    #
    # Imported only when it can be used: the module costs 5.9 kB of a heap
    # that has about 22 kB to give, and paying that for a feature that is
    # switched off is how the display ran out of memory in the first place.
    log_writable = storage_is_writable()
    remember_boot_mode()
    logs = None
    LOG_INTERVAL_S = 1.0
    if log_writable:
        from oven.logstore import LogStore, INTERVAL_S as LOG_INTERVAL_S
        logs = LogStore()

    data = load_characterisation()
    have_characterisation = data is not None
    characterisation_data = data
    if data:
        ff = FeedForward(heating_rates=data.get("heating_rate_c_per_s"),
                         cooling_rates=data.get("cooling_rate_c_per_s"))
        coast = data.get("coast_tau_s", 1.2)
        # Drop the parsed JSON. FeedForward has packed the curves into
        # array('f'); holding the dict as well keeps the original lists of
        # [temperature, rate] pairs alive for the life of the run, which is
        # the 7 kB the packing was meant to recover. Measured: free went
        # DOWN, from 30352 to 27056, until this line existed.
        characterisation_data = {
            "element_model": data.get("element_model"),
            "precharge": data.get("precharge"),
            "predictive": data.get("predictive")}
        data = None
        gc.collect()
    else:
        ff = FeedForward()
        coast = 1.2

    # Pre-charge the element before a run's clock starts, and let the
    # controller track the curve a few seconds ahead against the same
    # element state. Both come from the identified two-state model in the
    # characterisation; without one the factory is None, runs start the
    # way they always did, and the loop acts on the present. See
    # oven/elementff.py and docs/control-loop.md.
    element_model = load_element_model(characterisation_data)
    precharge_factory = make_precharge_factory(characterisation_data,
                                               element_model)
    lead_s = 0.0
    if element_model is not None and characterisation_data:
        lead_s = float((characterisation_data.get("predictive") or {})
                       .get("lead_s", 0.0))
    print("# predictive tracking: %s" % ("lead %.1f s" % lead_s if lead_s > 0.0
                                         else "off"))

    profiles = load_profiles()
    # Alphabetical order would select "4900P (as run)", which measurement
    # shows this oven cannot follow. A profile may declare itself the default.
    # Only the newest version of a profile that is not archived is chosen.
    chosen = choose(profiles)

    # Exactly one profile is resident at a time: the one that is selected.
    selected_ref = [chosen]
    selected_profile = [None]

    def selected():
        """The loaded profile for the current selection, read on demand."""
        if selected_profile[0] is None and selected_ref[0] is not None:
            try:
                selected_profile[0] = selected_ref[0].load()
            except Exception as e:
                print("# WARNING could not load %s (%r)"
                      % (selected_ref[0].name, e))
                return None
        return selected_profile[0]

    def select(ref):
        selected_ref[0] = ref
        selected_profile[0] = None
        gc.collect()

    display.render(L.splash(VERSION))
    time.sleep(1.2)

    reading = hw.sensor.read()
    display.render(L.self_test([
        ("thermocouple", reading is not None and reading.ok),
        ("relay safe state", not hw.relay.is_on()),
        ("profiles", bool(profiles)),
        ("characterisation", have_characterisation),
        # Not a fault when it is off: it means a programming cable owns the
        # filesystem, which is a choice somebody made with deploy.py.
        ("run logging", True if log_writable else "HOST"),
    ]))
    if not log_writable:
        print("# run logging unavailable: CIRCUITPY is writable over USB, so "
              "the device cannot write to it. Serial telemetry is unaffected.")
    time.sleep(1.5)

    def make_controller(profile):
        # Tuned against the measured plant, not guessed. Run 3 showed the
        # oven lagging the early ramp by up to 15 °C while only 1 % of the
        # samples that were behind had duty saturated -- headroom sitting
        # unused because the gains were too soft. Swept in simulation and
        # checked for robustness against +/-20 % plant error and a warm
        # start; every case stayed inside the peak and time-above-liquidus
        # windows.
        return Controller(profile, coast_tau_s=coast, feed_forward=ff,
                          pid=PID(kp=0.22, ki=0.004, kd=0.5,
                                  i_max=0.6, i_min=-0.6),
                          element_model=element_model, lead_s=lead_s)

    # Every control step is printed as CSV on the serial console. The
    # previous firmware kept no record of any run it ever performed; a host
    # capturing this gets the whole run without the device needing storage.
    # cpu_c is a second thermometer in the same box, on a different chip.
    # The pair is the useful thing: across a full run the amplifier's cold
    # junction rises 12-15 °C while the SAMD51 die does not move at all, so
    # the box is not warming -- heat is reaching that one chip, almost
    # certainly along the thermocouple wires into its terminals. That is the
    # mechanism behind cold-junction compensation error, and logging both is
    # what turns it from a worry into a measurement.
    memory_failures = {}

    def note_memory_failure(where):
        """Count a memory failure, and say so without making it worse.

        Printing on every failure allocates, which is precisely what is
        already failing, so this reports on a widening schedule. The totals
        are available from MEM and are printed at the end of a run.
        """
        n = memory_failures.get(where, 0) + 1
        memory_failures[where] = n
        if n in (1, 10, 100, 1000):
            print("# WARNING %s ran out of memory %d time(s); the display "
                  "may be stale, the run is not affected" % (where, n))

    last_log = [0.0]
    logging_run = [False]
    run_started_at = [0.0]
    entered_at = [0.0]

    def _detail(payload):
        """A dict flattened to one readable field, without json."""
        if not payload:
            return ""
        return " ".join("%s=%s" % (k, payload[k]) for k in sorted(payload))

    def begin_log(profile):
        if logs is None:
            return
        stamp = now_iso() or ("monotonic+%.0f" % hw.clock.monotonic())
        # A warm oven does not start at the beginning of the curve: the run
        # clock is set to wherever the profile already matches the oven, so
        # elapsed_s = 0 is a point that never happened. Recording the offset
        # is what makes wall clock recoverable from any row.
        entered_at[0] = app.elapsed
        # Wound back to the instant elapsed_s would have been zero. A warm
        # oven joins the curve part-way along, so the moment START was
        # pressed is somewhere in the middle of the file; a header stamp
        # that matches row one and nothing else is the more useful of the
        # two, and it makes wall clock a plain addition.
        epoch = now_epoch()
        if epoch is not None:
            epoch -= int(round(app.elapsed))
        path = logs.begin(profile.name, VERSION, stamp,
                          entered_at_s=app.elapsed, epoch=epoch)
        logging_run[0] = path is not None
        last_log[0] = 0.0
        run_started_at[0] = hw.clock.monotonic()
        if path:
            print("# recording this run to %s" % path)

    def end_log():
        if logging_run[0] and logs is not None:
            summary = None
            # peak_c is None until the first sample, and a run can end before
            # one: a fault at START. "%.1f" % None raised out of the main
            # loop and stopped the controller, so that run has no summary.
            if app.metrics and app.metrics.peak_c is not None:
                summary = "peak=%.1f" % app.metrics.peak_c
                if app.metrics.liquidus_c:
                    summary += " tal=%.0f" % app.metrics.time_above_liquidus
                # The verdict too, so the log answers "was this run good?"
                # without needing the profile file alongside it.
                if app.profile is not None:
                    try:
                        checks = app.metrics.check(
                            MetricLimits.for_profile(app.profile))
                        for name, _value, ok, text in checks:
                            logs.event(app.elapsed, "check",
                                       "%s %s %s" % (name,
                                                     "ok" if ok else "FAILED",
                                                     text))
                    except Exception as e:
                        print("# WARNING could not record the run checks "
                              "(%r)" % e)
            logs.end(summary)
            logging_run[0] = False

    # Anything left over from a run that finished while the network was
    # down, or before an archive was configured. Without this a log that
    # missed its upload waits for the NEXT run to end, which may be days,
    # and may be evicted first.
    # ...but not here. At boot the radio is not up yet -- it comes up over
    # the first few seconds of the loop, behind a live screen -- so this
    # waits for the moment it is.
    caught_up = [logs is None]

    print("# t,state,temp_c,target_c,duty,relay,cold_c,cpu_c")

    def emit(row):
        # Formatting and printing a row allocates. Losing a telemetry line
        # is nothing; losing the run because of one is not acceptable.
        try:
            _emit(row)
        except MemoryError:
            gc.collect()
            note_memory_failure("printing telemetry")

    def _emit(row):
        cpu = cpu_temperature()
        # One row a second on the device against four a second on the wire:
        # nothing in a reflow profile moves faster than a second, and it
        # quarters what the flash has to hold.
        if logging_run[0] and row["t"] - last_log[0] >= LOG_INTERVAL_S:
            last_log[0] = row["t"]
            # Profile time, not board uptime. The column used to hold
            # monotonic seconds -- 8672.2 on a run that had been going for
            # two -- while events on the very next line held run-relative
            # seconds. Two clocks, one column heading, and nothing could be
            # plotted against anything.
            logs.write(row["t"] - run_started_at[0] + entered_at[0],
                       row["target"], row["temp"], row["relay"],
                       row["cold"], cpu)
        print("%.2f,%s,%s,%s,%.3f,%d,%s,%s" % (
            row["t"], row["state"],
            "" if row["temp"] is None else "%.4f" % row["temp"],
            "" if row["target"] is None else "%.2f" % row["target"],
            row["duty"] or 0.0, 1 if row["relay"] else 0,
            "" if row["cold"] is None else "%.2f" % row["cold"],
            "" if cpu is None else "%.2f" % cpu))

    # The end of a run, said out loud: the screen is the only other
    # indicator, and nobody stands watching it. An abort from the button or
    # the console is silent -- whoever pressed it already knows -- but a
    # preheat that gave up is an abort nobody asked for, and sounds like the
    # fault it is.
    #
    # A sound holds the relay open from start to finish: see oven/chime.py
    # and hal.Interlocked. Every event that plays one has opened the relay
    # already. Starting a run stops any sound first, which releases the
    # hold, so the run gets its heat at once rather than up to two seconds
    # later.
    chime = chime_mod.Chime(hw.speaker, hw.clock, hw.relay)

    def announce(name, payload):
        print("# event %s %s" % (name, payload))
        if name == "run_finished":
            chime.play(chime_mod.DONE)
        elif name == "faulted" or (name == "aborted" and payload
                                   and payload.get("reason")):
            chime.play(chime_mod.FAULT)
        # The log opens here, not when START is accepted. request_start
        # enters PREHEAT; the warm-start offset is not applied until the
        # transition into RUNNING, so opening earlier read the offset as
        # zero and wound the header stamp back by nothing. A run whose
        # header said entered_at_s,0.0 while its own first event said 1.1
        # is what showed it.
        #
        # Nothing is lost by waiting: on the run that found this, zero
        # sample rows preceded run_started.
        if name == "run_started" and not logging_run[0] and app.profile:
            begin_log(app.profile)
        # Into the run's own log as well. A log that stops without saying
        # why is indistinguishable from a power cut.
        if logging_run[0] and logs is not None:
            detail = payload if isinstance(payload, str) else _detail(payload)
            # The same clock the samples use, in every state. This used
            # a third origin once the run ended, so a fault during cooldown
            # landed at a time no sample ever had.
            logs.event(hw.clock.monotonic() - run_started_at[0]
                       + entered_at[0], name, detail)

    app = App(hw.relay, hw.sensor, hw.clock, make_controller,
              on_event=announce, sample=emit)

    # The chart needs a trace. One point every two seconds is plenty at 308
    # pixels wide, and History is bounded: past its limit it halves its own
    # resolution instead of growing. This was a plain list, and growing it
    # killed a run at 90 C with the relay at full duty -- the allocation that
    # failed was 256 bytes.
    history = History(max_points=150, interval_s=2.0)

    def cooling_rate():
        if len(history) < 4:
            return None
        pts = history.points
        (t0, v0), (t1, v1) = pts[-4], pts[-1]
        return None if t1 <= t0 else (v1 - v0) / (t1 - t0)

    screen = []
    last_render = [0.0]
    command = [""]

    def poll_command():
        """Read a line from the console without blocking."""
        try:
            n = supervisor.runtime.serial_bytes_available
        except AttributeError:
            return None
        while n:
            ch = sys.stdin.read(1)
            n -= 1
            if ch in ("\r", "\n"):
                line = command[0].strip().upper()
                command[0] = ""
                if line:
                    return line
            elif len(command[0]) < 32:
                command[0] += ch
        return None

    def status_line():
        return "%s, %s, profile %s" % (
            app.state,
            "-- \u00b0C" if app.temperature is None
            else "%d \u00b0C" % round(app.temperature),
            selected_ref[0].name if selected_ref[0] else "none")

    app.precharge_factory = precharge_factory
    app.observer_factory = make_observer_factory(element_model)

    web = WebService(logs, (selected_ref[0], profiles), status_line)
    # The clock is set on the connection the page is already making, rather
    # than on a second one of its own. Two bring-ups at boot was two scans,
    # two joins and a restart between them.
    web.on_epoch = set_rtc

    def catalogue_changed():
        # Stay on the same profile, at its newest version; or, if the page
        # archived or deleted it, fall back the way boot does.
        select(choose(profiles, selected_ref[0]))
        print("# profiles changed from the page; selected: %s"
              % (selected_ref[0].name if selected_ref[0] else "none"))

    web.on_catalogue = catalogue_changed
    # One attempt. If the radio is not there, do not spend a scan every
    # time round the loop looking for it.
    web_wanted = [True]
    previous_state = [app.state]

    while True:
        app.tick()
        chime.tick()

        # A run has ended when it leaves the states that heat or cool. The
        # log is closed here rather than on an event so that an abort, a
        # fault and a normal finish all go through one path.
        if app.state != previous_state[0]:
            if previous_state[0] in (STATE_PREHEAT, STATE_PRECHARGE, STATE_RUNNING,
                                     STATE_COOLDOWN) and \
                    app.state in (STATE_REPORT, STATE_FAULT, STATE_IDLE):
                end_log()
            if app.state in (STATE_PREHEAT, STATE_PRECHARGE, STATE_RUNNING) and \
                    web.server is not None:
                # A run is starting. What must not happen during it is
                # polling the socket -- that is the call that costs up to
                # 227 ms against a 250 ms control deadline -- and the guard
                # on the poll below is what prevents it. The radio itself
                # stays associated and the listening socket stays bound.
                #
                # This used to close both, and bringing them back up when
                # the run ended took a measured 24.2 s of frozen main loop:
                # no telemetry, no touch, no console, and the report screen
                # still up because the render never got a turn. That is the
                # lag between pressing DONE and the home screen appearing,
                # and it happened after every single run.
                #
                # Staying up costs 1472 bytes, measured on the board:
                # associated 1200, listening socket a further 272. The
                # imports are 5792 more and are not returned by closing
                # anyway -- CircuitPython keeps them in sys.modules.
                print("# web: not polled until this run ends "
                      "(the radio stays associated)")
            if app.state == STATE_IDLE and previous_state[0] != STATE_IDLE:
                # Back to idle with nothing on the line: the one moment the
                # radio is allowed up.
                upload_finished_runs(logs, app.state,
                                     hw.relay.is_on(), radio=web.radio)
            previous_state[0] = app.state

        cmd = poll_command()
        # poll_command returns None on every pass with no complete line, and
        # None has no .startswith. The equality branches tolerated it; the
        # prefix match did not, and it crashed the firmware on the first
        # loop.
        if not cmd:
            pass
        elif cmd == "ABORT":
            app.abort()
            print("# command ABORT accepted, state=%s" % app.state)
        elif cmd == "START":
            chime.stop()
            profile = selected()
            problem = app.request_start(profile) if profile else None
            if profile is None:
                print("# command START refused: no profile")
            elif problem is not None:
                print("# command START refused: %s" % problem.message)
            else:
                print("# command START accepted: %s" % profile.name)
        elif cmd == "ACK":
            app.acknowledge_fault()
            print("# command ACK, state=%s" % app.state)
        elif cmd == "DONE":
            # Dismiss a finished run's report. The touchscreen has a DONE
            # button; the console had no equivalent, so a run that finished
            # with nobody present parked on the report screen indefinitely.
            if app.state == STATE_REPORT:
                app.state = STATE_IDLE
            print("# command DONE, state=%s" % app.state)
        elif cmd.startswith("PROFILE "):
            wanted = cmd[8:].strip().lower()
            match = None
            for pr in latest(profiles):
                if wanted in pr.name.lower():
                    match = pr
                    break
            if match is None:
                print("# command PROFILE unknown %r; have: %s"
                      % (wanted, " | ".join(p.name for p in latest(profiles))))
            elif app.state not in (STATE_IDLE, STATE_REPORT):
                print("# command PROFILE refused: oven is %s" % app.state)
            else:
                select(match)
                print("# command PROFILE selected: %s" % match.name)
        elif cmd == "PROFILES":
            for pr in latest(profiles):
                print("# profile %s%s%s%s"
                      % (pr.name,
                         " v%d" % pr.version if pr.version > 1 else "",
                         " (selected)" if pr is selected_ref[0] else "",
                         " (not offered at the oven)"
                         if pr.diagnostic or pr.archived else ""))
        elif cmd.startswith("SELECT "):
            # The console is the only way to reach DIAGNOSTIC, which is
            # deliberately kept out of the cycle someone steps through at
            # the oven looking for their paste. Hiding it without this left
            # it unreachable, and a comment claiming otherwise.
            wanted = cmd[len("SELECT "):].strip().upper()
            found = None
            for pr in latest(profiles):
                if pr.name.upper() == wanted:
                    found = pr
                    break
            if found is None:
                print("# no profile called %r -- PROFILES lists them" % wanted)
            elif app.state != STATE_IDLE:
                print("# not while the oven is %s" % app.state)
            else:
                select(found)
                print("# selected %s" % found.name)
        elif cmd == "MEM":
            # No "import gc" here: gc is imported at module scope, and a
            # local import would make the name local to the whole of main(),
            # so every other gc.collect() in this function -- including the
            # ones in the MemoryError guards and in select() -- would raise
            # NameError instead of collecting. That is exactly what happened.
            gc.collect()
            from oven.ui.display import largest_free_block
            print("# mem free=%d largest=%s memory_failures=%s"
                  % (gc.mem_free(), largest_free_block(),
                     memory_failures or "none"))
        elif cmd == "UPLOAD":
            # Force a hand-over now. Useful when a receiver has been down,
            # and the only way to exercise this path without waiting for a
            # run to finish.
            if logs is None:
                print("# command UPLOAD refused: the host owns the "
                      "filesystem, so there are no logs of our own")
            else:
                waiting = len(uploader_pending(logs))
                print("# command UPLOAD: %d run(s) waiting" % waiting)
                sent = upload_finished_runs(logs, app.state,
                                            hw.relay.is_on(),
                                            radio=web.radio)
                print("# command UPLOAD done: %d sent" % sent)
        elif cmd in ("CHIME DONE", "CHIME FAULT"):
            # Hear the sounds without running a profile to the end. Not
            # while a run is in progress: nothing touches the speaker then.
            if app.state not in (STATE_IDLE, STATE_REPORT, STATE_FAULT) \
                    or hw.relay.is_on():
                print("# command %s refused: oven is %s" % (cmd, app.state))
            else:
                chime.play(chime_mod.DONE if cmd == "CHIME DONE"
                           else chime_mod.FAULT)
                print("# command %s: %s" % (cmd, "playing" if chime.playing
                                            else "no speaker"))
        elif cmd.startswith("CLOCK "):
            # Set the board's clock from the host. The network sets it too,
            # but a board that has just been reflashed often cannot join for
            # a minute or two, and a run started in that window is written
            # with no date at all -- runs 0020 to 0022 are undated for
            # exactly this reason. The host always knows the time.
            try:
                set_rtc(int(cmd[6:].strip()))
                print("# clock set from the host")
            except Exception as e:
                print("# clock: refused (%r)" % e)
        elif cmd == "STATUS":
            print("# status state=%s temp=%s target=%s relay=%d profile=%s"
                  % (app.state, app.temperature, app.target,
                     1 if hw.relay.is_on() else 0,
                     selected_ref[0].name if selected_ref[0] else None))
            # The network belongs here too. A boot that fails to join says
            # so once, in a line that scrolls past; after that the only way
            # to find out whether the page is reachable was to try the page.
            print("# status network=%s" % (web.status or "not up"))
        elif cmd:
            print("# unknown command %r" % cmd)

        if app.state in (STATE_RUNNING, STATE_COOLDOWN) and \
                app.temperature is not None:
            now = hw.clock.monotonic()
            # During cooldown the run clock has stopped, so the trace is
            # continued on its own axis rather than restarting at zero.
            mark = app.elapsed if app.state == STATE_RUNNING else now
            # This is the line a run died on. History is bounded now, but a
            # bounded buffer still allocates a tuple per sample, and a chart
            # point is never worth a run.
            try:
                history.add(mark, app.temperature)
            except MemoryError:
                gc.collect()
                note_memory_failure("recording a chart point")
        elif app.state in (STATE_IDLE, STATE_PREHEAT, STATE_PRECHARGE) and len(history):
            history.clear()

        # Touch is polled outside the control step: a press must not be able
        # to delay a control step, and a missed press is merely annoying.
        point = hw.touch.press()
        if point is not None:
            action = L.hit(screen, point[0], point[1])
            if action == "start" and selected_ref[0] is not None:
                # A run started here is the one most likely to have nobody
                # watching it, so it is the one that most needs recording.
                chime.stop()
                profile = selected()
                problem = app.request_start(profile) if profile else None
                if problem is not None:
                    print("# start refused: %s" % problem.message)

            elif action == "abort":
                app.abort()
            elif action == "acknowledge":
                app.acknowledge_fault()
            elif action == "done":
                app.state = STATE_IDLE
            elif action == "profiles" and profiles:
                cycle = offered(profiles)
                if selected_ref[0] in cycle:
                    nxt = (cycle.index(selected_ref[0]) + 1) % len(cycle)
                else:
                    nxt = 0
                if cycle:
                    select(cycle[nxt])

        # Composing a screen allocates, and the heap late in a run has no
        # large holes left. A MemoryError here used to propagate out of
        # main() and stop the firmware: the exit handler drove the relay
        # low, so it failed safe, but the oven stopped controlling and
        # stopped answering ABORT. The display is never worth a run -- on
        # failure the previous screen simply stays up.
        try:
            if app.state == STATE_FAULT:
                screen = L.fault(app.fault.message if app.fault else "unknown")
            elif app.state in (STATE_RUNNING, STATE_PREHEAT, STATE_PRECHARGE):
                remaining = 0.0
                if app.profile is not None:
                    remaining = app.profile.duration - app.elapsed
                screen = L.running(app.temperature, app.target, app.elapsed,
                                   remaining, app.stage,
                                   app.metrics.time_above_liquidus if app.metrics
                                   else 0.0,
                                   app.profile.liquidus_c if app.profile else None,
                                   app.duty, hw.relay.is_on(),
                                   history=history.points,
                                   profile_points=app.profile.points
                                   if app.profile else None,
                                   duration_s=app.profile.duration
                                   if app.profile else None,
                                   open_the_door=app.door_prompted,
                                   door_in_s=app.door_in_s)
            elif app.state == STATE_COOLDOWN:
                screen = L.open_the_door(app.temperature, cooling_rate())
            elif app.state == STATE_REPORT and app.metrics and app.profile:
                screen = L.report(app.metrics.check(
                    MetricLimits.for_profile(app.profile)),
                    app.metrics.peak_c, app.metrics.time_above_liquidus)
            else:
                ready = app.temperature is not None and app.temperature < 60.0
                screen = L.home(app.temperature,
                                selected_ref[0].name if selected_ref[0] else None,
                                ready and selected_ref[0] is not None,
                                None if ready else "oven too hot to start",
                                address=web.address,
                                net_status=web.status)
        except MemoryError:
            gc.collect()
            note_memory_failure("composing a screen")

        # Rendering at the control cadence rebuilds every label four times a
        # second for no benefit; 2 Hz is beyond what anyone reads and halves
        # the allocation churn.
        now_r = hw.clock.monotonic()
        if now_r - last_render[0] >= 0.5:
            last_render[0] = now_r
            try:
                display.render(screen)
            except MemoryError:
                gc.collect()
                note_memory_failure("drawing the screen")

        # The web page, only while idle and only between control steps --
        # and after the frame, never before it. One step per pass: the
        # radio comes up over several seconds of loop time rather than in
        # one call that stops the oven, and the screen says what it is
        # doing while it happens.
        # Idle OR the report screen. netconfig.SAFE_STATES has always said
        # both are safe; this line said only idle, and the two disagreed.
        # The cost of that disagreement: after every run the oven parks on
        # the report screen until somebody presses DONE, and for the whole
        # of that time the page is unreachable while the oven sits there
        # healthy and still associated. Measured 2026-09-16: ping 0% loss
        # throughout the run and the report, HTTP dead for both, back
        # within 34 s of DONE. It reads exactly like "it doesn't come back
        # after a run", and the radio never went anywhere.
        if app.state in (STATE_IDLE, STATE_REPORT) and not hw.relay.is_on():
            if web_wanted[0]:
                web_wanted[0] = web.advance()
            if not caught_up[0] and web.server is not None:
                # The first moment the radio has ever been up this boot.
                # Anything left over from a run that finished while the
                # network was down goes now; without this it waits for the
                # NEXT run to end, which may be days, and may be evicted
                # first.
                caught_up[0] = True
                upload_finished_runs(logs, app.state, hw.relay.is_on(),
                                     radio=web.radio)


try:
    main()
finally:
    # Whatever happens, stop heating. CircuitPython releases the pin on the
    # way out anyway and this oven's relay has a pulldown, but saying it
    # explicitly costs nothing.
    # Use the relay object that already owns the pin. Constructing a second
    # DigitalInOut on D4 raises "D4 in use" and the drive-low never happens --
    # which is exactly what occurred when the run crashed, leaving the
    # hardware pulldown as the only thing holding the relay off. It held, but
    # the belt-and-braces did not.
    try:
        if HARDWARE is not None:
            HARDWARE.relay.off()
            print("# relay driven low on exit")
        else:
            import digitalio
            _r = digitalio.DigitalInOut(board.D4)
            _r.direction = digitalio.Direction.OUTPUT
            _r.value = False
            print("# relay driven low on exit (fresh pin)")
    except Exception as e:
        print("# WARNING could not drive the relay low on exit (%r); the "
              "pulldown on D4 is now the only thing holding it off" % e)
