Taeron-Systems-Inc/BespokeToast/firmware/oven/safety.py

# SPDX-License-Identifier: MIT
"""Safety supervision.

The supervisor is the only thing permitted to say yes to heat. The controller
proposes; this decides. It is deliberately separate from the controller so it
can be reasoned about, and tested, on its own.

Three principles shape it.

**Fail closed.** Anything the supervisor cannot make sense of — a missing
reading, a sensor fault flag, a gap in time — denies heat. There is no state in
which "I don't know" allows the relay on.

**Latch.** A tripped fault stays tripped until a person acknowledges it.
Faults that clear themselves hide the thing that caused them.

**Watch the direction that hurts.** A thermocouple failing *low* makes the
control error larger and asks for more heat. Validation therefore runs before
the controller sees a reading, not after.

**Blind is not the same as broken.** The amplifier shares an I2C bus with
everything else, and one read in a long run can fail for no lasting reason.
Tripping on that ended whole runs on a single hiccup. So a *missed* reading
-- nothing came back, or the bus failed, or the value was out of range -- is
tolerated, within limits that keep the oven from heating while nobody is
looking. That tolerance holds only because of three rules:

- A missed step never allows heat. ``allow_heat`` is false for that step,
  so the relay opens at once. While the sensor is blind the oven can only
  cool. It can never climb.
- Misses are bounded twice: a few in a row, and a budget over a sliding
  window. A sensor that is dying rather than hiccuping trips, latched, as
  it always did.
- A miss leaves the stall and frozen guards alone. Otherwise a sensor that
  drops out often enough would keep restarting their windows, and a probe
  that has fallen out of the oven could go on calling for heat without
  ever being caught.

A thermocouple fault the driver reports as definite (open or short circuit)
is not a miss. It trips at once.
"""

from . import hal

# Fault codes.
FAULT_NONE = 0
FAULT_OVER_TEMP = 1
FAULT_RATE = 2
FAULT_SENSOR = 3
FAULT_SENSOR_STALE = 4
FAULT_SENSOR_FROZEN = 5
FAULT_STALL = 6
FAULT_ENCLOSURE = 7
FAULT_RUN_TIMEOUT = 8
FAULT_IMPLAUSIBLE_START = 9
FAULT_CPU_HOT = 10

# Sensor fault bits that mean "this one read failed" rather than "the probe is
# broken". Only these, or no reading at all, count as a tolerable miss.
_MISSABLE_SENSOR_FAULTS = hal.FAULT_BUS | hal.FAULT_RANGE

_FAULT_TEXT = {
    FAULT_OVER_TEMP: "over temperature",
    FAULT_RATE: "temperature rising too fast",
    FAULT_SENSOR: "thermocouple fault",
    FAULT_SENSOR_STALE: "no sensor reading",
    FAULT_SENSOR_FROZEN: "sensor reading not changing",
    FAULT_STALL: "heating but temperature not rising",
    FAULT_ENCLOSURE: "electronics enclosure too hot",
    FAULT_RUN_TIMEOUT: "run exceeded its time limit",
    FAULT_IMPLAUSIBLE_START: "starting temperature implausible",
    FAULT_CPU_HOT: "controller too hot",
}


class Limits(object):
    """Bounds the supervisor enforces. Values are defaults; see config."""

    __slots__ = ("max_temp_c", "max_rate_c_per_s", "max_enclosure_c",
                 "stall_window_s", "stall_min_rise_c", "max_run_s",
                 "sensor_stale_s", "sensor_frozen_s", "start_min_c",
                 "start_max_c", "rate_window_s", "max_cpu_c",
                 "max_cooldown_s", "max_consecutive_misses",
                 "miss_window_s", "max_misses_in_window")

    def __init__(self, max_temp_c=260.0, max_rate_c_per_s=4.0,
                 max_enclosure_c=70.0, stall_window_s=15.0,
                 stall_min_rise_c=0.5, max_run_s=3600.0,
                 sensor_stale_s=3.0, sensor_frozen_s=5.0,
                 start_min_c=5.0, start_max_c=60.0,
                 rate_window_s=3.0, max_cpu_c=80.0,
                 max_cooldown_s=3600.0, max_consecutive_misses=3,
                 miss_window_s=60.0, max_misses_in_window=8):
        self.max_temp_c = max_temp_c
        self.max_rate_c_per_s = max_rate_c_per_s
        self.max_enclosure_c = max_enclosure_c
        # Stall and frozen are how long heat may go in with no sign that the
        # probe is measuring the oven: a probe that has fallen out reads a
        # plausible room temperature and the controller asks for full heat.
        # So they are as short as the oven allows, and the oven sets the
        # limit, not the code. Measured after the relay closes, every run in
        # data/ and the 4 Hz capture in data/plant-id: no rise at all for up
        # to 10 s (138.8 C, 4 Hz capture), +0.5 C by 11.25 s at the latest,
        # +2 C by 15 s. A 10 s window trips on that healthy oven at any
        # threshold, so 15 s it is. 0.5 C is eight sensor steps, well clear
        # of the +-0.0625 C flicker a probe on the oven floor shows -- a
        # threshold inside that flicker would be met by noise, restart the
        # window, and never trip.
        self.stall_window_s = stall_window_s
        self.stall_min_rise_c = stall_min_rise_c
        self.max_run_s = max_run_s
        self.sensor_stale_s = sensor_stale_s
        # The longest a healthy reading has stayed identical while heating is
        # 3.2 s (2.75 s in the 4 Hz capture): the last bit flickers. This
        # catches a reading that has stopped changing at all, not a probe
        # that has fallen out, which still flickers; that is the stall
        # guard's.
        self.sensor_frozen_s = sensor_frozen_s
        self.start_min_c = start_min_c
        self.start_max_c = start_max_c
        # max_enclosure_c is set from what the electronics tolerate, not from
        # the enclosure material: the printed parts sit away from the oven and
        # are reached by thermally protected wiring, so softening is not the
        # constraint. The binding part is the TFT, typically rated to 70 °C
        # operating; the SAMD51 is good to 85 °C and the MCP9601 to 125 °C.
        # 60 °C was too tight to run back to back -- the enclosure rises about
        # 21 °C per run and peaks after it, so a second run had to wait.
        #
        # Rate is measured across this window, not between adjacent samples.
        # At 4 Hz on a probe quantised to 0.0625 C, ordinary noise shows up as
        # 8-11 C/s between neighbours on an oven whose real maximum is
        # 1.85 C/s -- so a neighbour-to-neighbour limit is certain to trip on
        # nothing at all. It did, mid-run, on the bench.
        self.rate_window_s = rate_window_s
        # The SAMD51 is rated to 85 °C. Measured, its die does not move during
        # a run -- the cold junction rises 12-15 °C while this stays flat --
        # so tripping here would mean something genuinely unlike any run so
        # far, which is exactly what a guard is for.
        self.max_cpu_c = max_cpu_c
        self.max_cooldown_s = max_cooldown_s
        # Missed readings. Three in a row is 0.75 s blind at 4 Hz, and the
        # relay is held open for all of it. The window budget catches a
        # sensor that keeps missing one step at a time and never reaches the
        # consecutive limit. More than eight in a minute is over 3% of steps,
        # which is no longer "occasional".
        self.max_consecutive_misses = max_consecutive_misses
        self.miss_window_s = miss_window_s
        self.max_misses_in_window = max_misses_in_window


class Fault(object):
    __slots__ = ("code", "detail", "t")

    def __init__(self, code, detail="", t=None):
        self.code = code
        self.detail = detail
        self.t = t

    @property
    def message(self):
        base = _FAULT_TEXT.get(self.code, "unknown fault")
        return "%s: %s" % (base, self.detail) if self.detail else base

    def __repr__(self):
        return "Fault(%s)" % self.message


class Supervisor(object):
    """Gates the relay. Call :meth:`update` every control step."""

    def __init__(self, limits=None):
        self.limits = limits or Limits()
        self.fault = None
        self._run_start = None
        self._run_limit_s = None
        self._last_t = None
        self._last_temp = None
        self._relay_on_since = None
        self._temp_at_relay_on = None
        self._frozen_since = None
        self._frozen_value = None
        self._rate_history = []
        self._consecutive_misses = 0
        self._miss_times = []
        self.blind = False

    # -- state -------------------------------------------------------------

    @property
    def tripped(self):
        return self.fault is not None

    def allow_heat(self):
        """The only authority for energising the relay.

        False after a missed reading even though nothing has latched: a
        step without a temperature is a step without heat.
        """
        return self.fault is None and not self.blind

    def acknowledge(self):
        """Clear a latched fault. Requires a deliberate act by a person."""
        self.fault = None
        self._reset_tracking()

    def _reset_tracking(self):
        self._last_t = None
        self._last_temp = None
        self._relay_on_since = None
        self._temp_at_relay_on = None
        self._frozen_since = None
        self._frozen_value = None
        self._rate_history = []
        self._consecutive_misses = 0
        self._miss_times = []
        self.blind = False

    def _trip(self, code, detail, t):
        if self.fault is None:            # keep the first cause, not the last
            self.fault = Fault(code, detail, t)
        return self.fault

    # -- run lifecycle -----------------------------------------------------

    def check_start(self, reading):
        """Pre-flight check. Returns a Fault, or None if it is safe to begin.

        Does not latch: refusing to start is not the same as tripping mid-run,
        and the operator may simply need to wait for the oven to cool.
        """
        if reading is None or reading.hot is None:
            return Fault(FAULT_SENSOR_STALE, "no reading before start")
        if reading.faults:
            return Fault(FAULT_SENSOR,
                         ", ".join(hal.describe_faults(reading.faults)))
        lim = self.limits
        if not (lim.start_min_c <= reading.hot <= lim.start_max_c):
            return Fault(
                FAULT_IMPLAUSIBLE_START,
                "%.1f \u00b0C is outside the %.0f-%.0f \u00b0C band expected "
                "before a run"
                % (reading.hot, lim.start_min_c, lim.start_max_c))
        return None

    def begin_run(self, t, expected_duration_s=None):
        """Start supervising a run.

        The timeout follows the profile when one is given. It was a flat
        3600 s, which the shipped 125 C MSL bake exceeds four times over --
        that profile could never have completed, and would have faulted at
        the one-hour mark every time it was run. A fixed ceiling is also
        needlessly slack for a short run: a stuck eight-minute reflow had an
        hour to sit there before anything noticed.

        The allowance is ten minutes plus a quarter of the profile, which
        covers a slow oven and a cold start without letting a runaway sit.
        It covers the heated phase only -- see begin_cooldown, which is a
        separate and much slower clock.
        """
        self._run_start = t
        if expected_duration_s:
            self._run_limit_s = (expected_duration_s + 600.0
                                 + 0.25 * expected_duration_s)
        else:
            self._run_limit_s = self.limits.max_run_s
        self._reset_tracking()

    def begin_cooldown(self, t):
        """The profile is done; the oven is now just losing heat.

        Cooldown gets its own clock. Leaving the run's timeout running
        through it faulted a completed run: passive cooling from 224 C took
        longer than the profile's own allowance, so a perfectly good run
        ended in "run exceeded its time limit" -- and because a fault
        latches, every subsequent run was refused until it was acknowledged.

        Measured passive cooling is about -0.7 C/s at 190 C and falls off
        sharply as the oven approaches ambient, so cooling from a reflow
        peak takes tens of minutes with the door shut. The guard still
        exists, because an oven that never cools has something wrong with
        it, but it is set for the physics rather than the profile.
        """
        self._run_start = t
        self._run_limit_s = self.limits.max_cooldown_s

    def end_run(self):
        self._run_start = None
        self._run_limit_s = None
        self._reset_tracking()

    # -- the per-step check ------------------------------------------------

    def _windowed_rate(self, now, window_s):
        """Rate of rise across the window, or None until there is enough
        history to mean anything."""
        oldest = None
        for ts, value in self._rate_history:
            if now - ts <= window_s:
                oldest = (ts, value)
                break
        if oldest is None or len(self._rate_history) < 2:
            return None
        t1, v1 = self._rate_history[-1]
        t0, v0 = oldest
        if t1 - t0 < window_s * 0.5:
            return None
        return (v1 - v0) / (t1 - t0)

    def update(self, t, reading, relay_on):
        """Evaluate one control step. Returns the active Fault, or None.

        *relay_on* is what the relay was actually doing over the step just
        ended, not what is being requested for the next one.
        """
        if self.fault is not None:
            return self.fault

        lim = self.limits

        # A definite probe fault trips at once. A failed read is a miss.
        if reading is not None and reading.faults & ~_MISSABLE_SENSOR_FAULTS:
            return self._trip(
                FAULT_SENSOR,
                ", ".join(hal.describe_faults(reading.faults)), t)
        # A hot value with only the range bit set is a reading, not a miss.
        if (reading is not None and reading.hot is not None
                and reading.hot >= lim.max_temp_c):
            return self._trip(FAULT_OVER_TEMP,
                              "%.1f \u00b0C reached the %.1f \u00b0C limit"
                              % (reading.hot, lim.max_temp_c), t)
        if reading is None or reading.hot is None or reading.faults:
            return self._miss(t, reading, relay_on)

        # Seeing again. The relay was held open while blind, by this class
        # and not by the controller, which the guards below need to know.
        was_blind = self.blind
        self.blind = False
        self._consecutive_misses = 0

        temp = reading.hot

        # Absolute ceiling. Checked first: it is the one that matters most.
        if temp >= lim.max_temp_c:
            return self._trip(FAULT_OVER_TEMP,
                              "%.1f \u00b0C reached the %.1f \u00b0C limit"
                              % (temp, lim.max_temp_c), t)

        # The enclosure holds the electronics and sits beside the oven.
        if reading.cold is not None and reading.cold >= lim.max_enclosure_c:
            return self._trip(FAULT_ENCLOSURE,
                              "%.1f \u00b0C inside the enclosure, limit %.1f \u00b0C"
                              % (reading.cold, lim.max_enclosure_c), t)

        if reading.cpu is not None and reading.cpu >= lim.max_cpu_c:
            return self._trip(FAULT_CPU_HOT,
                              "%.1f \u00b0C on the controller die, limit "
                              "%.1f \u00b0C" % (reading.cpu, lim.max_cpu_c), t)

        limit_s = self._run_limit_s or lim.max_run_s
        if self._run_start is not None and t - self._run_start > limit_s:
            return self._trip(FAULT_RUN_TIMEOUT,
                              "%.0f s elapsed, limit %.0f s"
                              % (t - self._run_start, limit_s), t)

        if self._last_t is not None:
            dt = t - self._last_t

            # A gap in the control cadence means we were not watching.
            #
            # Two cases, and the second was missed at first. If the relay was
            # on through the gap, that is plainly not a step anyone can vouch
            # for. But a gap DURING A RUN is not harmless just because the
            # relay happened to be off at that instant: the profile clock
            # advanced without supervision, so the controller resumes against
            # a timeline that no longer describes the oven and commands heat
            # to catch up. Found by writing a test for a blocking network
            # call -- the exact thing the WiFi stack will introduce.
            in_run = self._run_start is not None
            if dt > lim.sensor_stale_s and (relay_on or in_run):
                return self._trip(
                    FAULT_SENSOR_STALE,
                    "%.1f s without a check %s" % (
                        dt, "while heating" if relay_on else "during a run"), t)

        self._rate_history.append((t, temp))
        cutoff = t - lim.rate_window_s * 2
        while len(self._rate_history) > 2 and self._rate_history[0][0] < cutoff:
            self._rate_history.pop(0)
        rate = self._windowed_rate(t, lim.rate_window_s)
        if rate is not None and rate > lim.max_rate_c_per_s:
            return self._trip(
                FAULT_RATE, "%.1f \u00b0C/s over %.0f s exceeds %.1f \u00b0C/s"
                % (rate, lim.rate_window_s, lim.max_rate_c_per_s), t)



        # A thermocouple reading the identical value for a long stretch while
        # heat is being applied is not measuring anything.
        #
        # Both of these guards reset when the relay goes off. A step after a
        # miss is off only because the supervisor forced it off, so it must
        # not reset them. Otherwise a sensor dropping out more often than the
        # stall window -- once every 10 s is well inside the miss budget --
        # would restart that window every time, and a probe lying on the
        # floor of the oven would never be caught.
        hold = was_blind and not relay_on
        if hold:
            pass
        elif relay_on:
            if self._frozen_value is None or temp != self._frozen_value:
                self._frozen_value = temp
                self._frozen_since = t
            elif t - self._frozen_since > lim.sensor_frozen_s:
                return self._trip(
                    FAULT_SENSOR_FROZEN,
                    "%.2f \u00b0C unchanged for %.0f s while heating"
                    % (temp, t - self._frozen_since), t)
        else:
            self._frozen_value = None
            self._frozen_since = None

        # Heat going in with nothing coming out: element or probe failure.
        if hold:
            pass
        elif relay_on:
            if self._relay_on_since is None:
                self._relay_on_since = t
                self._temp_at_relay_on = temp
            elif t - self._relay_on_since >= lim.stall_window_s:
                rise = temp - self._temp_at_relay_on
                if rise < lim.stall_min_rise_c:
                    return self._trip(
                        FAULT_STALL,
                        "%.1f \u00b0C rise over %.0f s of heating"
                        % (rise, t - self._relay_on_since), t)
                self._relay_on_since = t
                self._temp_at_relay_on = temp
        else:
            self._relay_on_since = None
            self._temp_at_relay_on = None

        self._last_t = t
        self._last_temp = temp
        return None

    def _miss(self, t, reading, relay_on):
        """One step without a usable reading. Denies heat for this step,
        and trips once misses are no longer occasional."""
        lim = self.limits
        self.blind = True
        self._consecutive_misses += 1
        self._miss_times.append(t)
        while self._miss_times[0] <= t - lim.miss_window_s:
            self._miss_times.pop(0)

        why = (", ".join(hal.describe_faults(reading.faults))
               if reading is not None and reading.faults
               else "sensor returned nothing")
        if self._consecutive_misses > lim.max_consecutive_misses:
            return self._trip(FAULT_SENSOR_STALE,
                              "%s, %d readings in a row"
                              % (why, self._consecutive_misses), t)
        if len(self._miss_times) > lim.max_misses_in_window:
            return self._trip(FAULT_SENSOR_STALE,
                              "%s, %d missed in %.0f s"
                              % (why, len(self._miss_times),
                                 lim.miss_window_s), t)

        # A miss still counts as a check for the cadence guard, but a late
        # one does not: a gap is a gap whatever the step finds.
        if self._last_t is not None:
            dt = t - self._last_t
            if dt > lim.sensor_stale_s and (relay_on
                                            or self._run_start is not None):
                return self._trip(
                    FAULT_SENSOR_STALE,
                    "%.1f s without a check %s" % (
                        dt, "while heating" if relay_on else "during a run"),
                    t)
        self._last_t = t
        return None
