Taeron-Systems-Inc/BespokeToast/firmware/oven/logstore.py

# SPDX-License-Identifier: MIT
"""On-device run logs, oldest discarded first.

The previous firmware kept no record of any run it ever performed. Serial
telemetry fixed that only while a host was attached, which is exactly when it
is least needed -- a run started from the touchscreen with nobody watching is
the one whose record you want afterwards.

Each run is one CSV file with a metadata header. The store keeps writing new
runs until free space would drop below a reserve, then deletes the oldest
runs until it fits. Nothing here is a ring buffer over a fixed region: files
vary in length with the profile, so "how many runs fit" is not a constant and
pretending otherwise would either waste most of the flash or truncate a long
run. The reserve is what is held constant.

Every filesystem call is injected. That is not ceremony -- it means the
eviction logic, which deletes files, is exercised entirely off the board.

Failure here must never disturb a run. A full or read-only filesystem makes
logging stop and say so once; it does not raise into the control loop.
"""

import os as _os

HEADER_FIELDS = ("elapsed_s", "target_c", "actual_c", "relay", "cold_c", "cpu_c")

# 1 Hz. The control loop runs at 4 Hz, but a reflow profile has no feature
# that moves faster than a second, and quartering the row count quadruples
# the history the flash holds.
INTERVAL_S = 1.0

DEFAULT_RESERVE_BYTES = 1000000


from oven import pacific

SENT_INDEX = "sent-index"   # not *.csv on purpose: runs() must skip it


class LogStore(object):
    def __init__(self, root="/logs", reserve_bytes=DEFAULT_RESERVE_BYTES,
                 fs=None, on_warning=None):
        self.root = root
        self.reserve_bytes = reserve_bytes
        self.fs = fs or _RealFS()
        self._warn = on_warning or (lambda msg: print("# WARNING %s" % msg))
        self._file = None
        self._path = None
        self._rows = 0
        self._disabled = False
        self._last_write = None

    # -- lifecycle ---------------------------------------------------------

    def begin(self, profile_name, version, started_at, limits=None,
              entered_at_s=0.0, epoch=None):
        """Open a log for a run. Returns the path, or None if unavailable."""
        if self._disabled:
            return None
        self.close()
        try:
            if not self.fs.exists(self.root):
                self.fs.mkdir(self.root)
            self._make_room()
            self._path = "%s/%s.csv" % (self.root, self._next_name(profile_name))
            self._file = self.fs.open(self._path, "w")
            self._file.write("# Taeron Reflow Oven run log\n")
            self._file.write("# firmware,%s\n" % version)
            self._file.write("# profile,%s\n" % profile_name)
            # Both stamps are the instant elapsed_s is zero, which is not
            # the instant START was pressed: a warm oven joins the curve
            # part-way along, so the clock is wound back by that offset.
            # The alternative was a header stamp that matched some row in
            # the middle of the file and an arithmetic rule to find it.
            #
            # Epoch rather than an ISO stamp because nothing has to parse
            # it, and there is no timezone or field order to get wrong. The
            # local stamp beside it is for whoever opens the file and wants
            # to know which afternoon this was.
            here = None
            if epoch is not None:
                self._file.write("# started_at_epoch,%d\n" % epoch)
                here = pacific.local_from_epoch(epoch)
            if here:
                self._file.write("# started_at_local,%s %s %s\n" % here)
            if epoch is None:
                self._file.write("# started_at,%s\n" % started_at)
            # Not needed for the arithmetic any more. Kept because it says
            # the run joined the curve warm, and a large value means the
            # oven was not given time to cool.
            self._file.write("# entered_at_s,%.1f\n" % entered_at_s)
            if epoch is not None:
                self._file.write("# wall clock of a row = "
                                 "started_at_epoch + elapsed_s\n")
            if limits:
                self._file.write("# limits,%s\n" % limits)
            self._file.write(",".join(HEADER_FIELDS) + "\n")
            self._rows = 0
            return self._path
        except Exception as e:
            self._fail("cannot open a run log (%r); this run will not be "
                       "recorded on the device" % e)
            return None

    def write(self, t, target_c, actual_c, relay, cold_c, cpu_c):
        """Append one sample. Rate limiting is the caller's business."""
        if self._file is None:
            return False
        try:
            self._file.write("%.1f,%s,%s,%d,%s,%s\n" % (
                t,
                "" if target_c is None else "%.2f" % target_c,
                "" if actual_c is None else "%.3f" % actual_c,
                1 if relay else 0,
                "" if cold_c is None else "%.2f" % cold_c,
                "" if cpu_c is None else "%.2f" % cpu_c))
            self._rows += 1
            # Flushed every 16 rows rather than every row: a run that loses
            # power keeps all but the last few seconds, and the flash sees a
            # sixteenth of the write cycles.
            if self._rows % 16 == 0:
                self._file.flush()
            return True
        except Exception as e:
            self._fail("run log write failed (%r); the rest of this run will "
                       "not be recorded" % e)
            return False

    def event(self, t, name, detail=""):
        """Record something that happened, in line with the samples.

        Without this a run that faulted looks exactly like a run that was
        unplugged: the samples simply stop. The fault, the abort, the
        request to open the door and the liquidus crossings are the parts
        someone reads the log to understand, and they were the one thing
        it did not carry.

        Written as a comment so a CSV reader skips it, and in time order so
        it can be lined up against the temperature either side of it.
        """
        if self._file is None:
            return False
        text = str(detail).replace("\n", " ").replace("\r", " ")
        try:
            self._file.write("# event,%.1f,%s,%s\n" % (t, name, text))
            self._file.flush()
            return True
        except Exception as e:
            self._fail("could not record event %s (%r); the rest of this run "
                       "will not be recorded" % (name, e))
            return False

    def end(self, summary=None):
        if self._file is None:
            return
        try:
            if summary:
                self._file.write("# summary,%s\n" % summary)
            self._file.write("# rows,%d\n" % self._rows)
        except Exception as e:
            # The samples are already on the flash; only the trailer is lost,
            # so this is worth a word rather than an abort.
            self._warn("could not write the run log trailer (%r)" % e)
        if not self.close():
            self._warn("the run log did not close cleanly; the last few "
                       "samples may be missing")

    def close(self):
        """Close the open log. Returns False if it did not close cleanly."""
        if self._file is None:
            return True
        handle, self._file = self._file, None
        try:
            handle.flush()
            handle.close()
        except Exception:
            return False
        return True

    # -- housekeeping ------------------------------------------------------

    def runs(self):
        """Existing logs, oldest first.

        Ordered by the sequence number in the name, not by mtime: the board
        has no clock until it has been told the time, so every file written
        before then shares one timestamp.
        """
        names = self._names()
        # Keyed once per name, then sorted on the pairs. MicroPython's sort
        # calls a key= function on every comparison, not once per item, and
        # its quicksort is quadratic on input that is already in order --
        # which a directory listing is. With 53 logs on the board that was
        # 1.05 s per call, twice per START, inside a control step; the
        # 3 s cadence guard tripped and the run faulted at once.
        keyed = [(_sequence_of(n), n) for n in names]
        keyed.sort()
        return [n for _, n in keyed]

    def _names(self):
        """Run log names in directory order, or [] if there is no listing."""
        try:
            return [n for n in self.fs.listdir(self.root) if ".csv" in n]
        except Exception:
            return []

    def read(self, name):
        """A stored run's bytes, or None. Used by the uploader."""
        try:
            with self.fs.open("%s/%s" % (self.root, name), "r") as f:
                return f.read()
        except Exception as e:
            self._warn("cannot read run log %s (%r)" % (name, e))
            return None

    def header(self, name):
        """The `# key,value` preamble of a run log, as a dict.

        Read back off the file rather than kept in an index, because the
        filesystem is the index: there is no database, and a run that
        survived a power cut still carries its own profile name and start
        time. 256 bytes reaches every field begin() writes, and costs
        nothing beside a 26 kB file -- which matters, because the runs page
        does this once per run every time it is loaded.
        """
        out = {}
        try:
            handle = self.fs.open("%s/%s" % (self.root, name), "r")
        except Exception as e:
            self._warn("cannot read the header of %s (%r)" % (name, e))
            return out
        try:
            head = handle.read(256)
        except Exception as e:
            self._warn("cannot read the header of %s (%r)" % (name, e))
            head = ""
        finally:
            try:
                handle.close()
            except Exception:
                self._warn("run log %s would not close after reading its "
                           "header; the runs page may fail to load" % name)
        for line in head.split("\n"):
            if not line.startswith("#"):
                if out:
                    break       # past the preamble, into the samples
                continue
            body = line[1:].strip()
            if "," in body:
                key, value = body.split(",", 1)
                out[key.strip()] = value.strip()
        return out

    def size(self, name):
        """Bytes on disk, for a Content-Length without reading the file."""
        try:
            return self.fs.size("%s/%s" % (self.root, name))
        except Exception as e:
            self._warn("cannot size run log %s (%r)" % (name, e))
            return None

    def chunks(self, name, size=512):
        """Yield the file in pieces. Never holds the whole run in memory."""
        try:
            handle = self.fs.open("%s/%s" % (self.root, name), "r")
        except Exception as e:
            self._warn("cannot open run log %s (%r)" % (name, e))
            return
        try:
            while True:
                piece = handle.read(size)
                if not piece:
                    return
                yield piece
        finally:
            try:
                handle.close()
            except Exception:
                self._warn("run log %s would not close after reading; the "
                           "next upload may fail to open it" % name)

    def sent(self):
        """Names already handed to an archive.

        Kept in an index rather than by renaming the file. Renaming put
        this oven's housekeeping into the name of a file someone
        downloads, where it meant nothing to them and stopped it opening
        as a CSV. The index is not called *.csv, so runs() steps over it.
        """
        try:
            with self.fs.open("%s/%s" % (self.root, SENT_INDEX), "r") as f:
                return set(n.strip() for n in f.read().split("\n") if n.strip())
        except Exception:
            return set()

    def mark_sent(self, name):
        """Record that a run has been handed over. Returns True if noted."""
        already = self.sent()
        if name in already:
            return True
        handle = None
        try:
            handle = self.fs.open("%s/%s" % (self.root, SENT_INDEX), "w")
            handle.write("\n".join(sorted(already | set([name]))) + "\n")
            handle.close()
            return True
        except Exception as e:
            self._warn("could not record that %s was sent (%r); it will be "
                       "offered again next time" % (name, e))
            return False

    def free_bytes(self):
        try:
            return self.fs.free_bytes()
        except Exception:
            return None

    def _make_room(self):
        """Delete oldest runs until the reserve is satisfied.

        The reserve exists because CircuitPython needs writable space for
        more than logs -- a filesystem with nothing spare is one that cannot
        take a firmware update.
        """
        free = self.free_bytes()
        if free is None or free >= self.reserve_bytes:
            # Nearly every START. Listing and ordering the runs is not free,
            # and it happens inside a control step.
            return
        removed = []
        # Oldest first, and nothing cleverer. Preferring already-uploaded
        # runs was tried; it coupled the log store to the uploader for a
        # preference that only differs when the disk is full AND an
        # archive exists AND the oldest run happens to be the unsent one.
        for name in self.runs():
            if free >= self.reserve_bytes:
                break
            path = "%s/%s" % (self.root, name)
            try:
                size = self.fs.size(path)
                self.fs.remove(path)
                removed.append(name)
                free += size
            except Exception as e:
                self._warn("could not discard old run log %s (%r); keeping "
                           "it and stopping here" % (name, e))
                break
        if removed:
            self._warn("run log full: discarded %d oldest run(s) to stay "
                       "above the %d-byte reserve (%s)"
                       % (len(removed), self.reserve_bytes,
                          ", ".join(removed)))

    def _next_name(self, profile_name):
        # The highest number needs no ordering: one pass over the listing.
        seq = 0
        for name in self._names():
            seq = max(seq, _sequence_of(name))
        # Collapse runs of separators: "SAC305 (this oven)" should become
        # 0008-SAC305-this-oven.csv, not 0008-SAC305--this-oven-.csv.
        safe = ""
        for c in profile_name:
            if c.isalpha() or c.isdigit():
                safe += c
            elif not safe.endswith("-"):
                safe += "-"
        return "%04d-%s" % (seq + 1, safe.strip("-")[:24] or "run")

    def _fail(self, message):
        self.close()
        if not self._disabled:
            self._warn(message)
        self._disabled = True


def _sequence_of(name):
    head = name.split("-", 1)[0]
    try:
        return int(head)
    except ValueError:
        return 0


class _RealFS(object):
    def exists(self, path):
        try:
            _os.stat(path)
            return True
        except OSError:
            return False

    def listdir(self, path):
        return _os.listdir(path)

    def mkdir(self, path):
        _os.mkdir(path)

    def remove(self, path):
        _os.remove(path)

    def size(self, path):
        return _os.stat(path)[6]

    def open(self, path, mode):
        return open(path, mode)

    def rename(self, old, new):
        _os.rename(old, new)

    def free_bytes(self):
        st = _os.statvfs("/")
        return st[0] * st[3]             # f_bsize * f_bavail
