Taeron-Systems-Inc/BespokeToast/firmware/oven/app.py

# SPDX-License-Identifier: MIT
"""The run state machine and the scheduler that drives it.

Two things this module exists to get right.

**Control cadence is not negotiable.** The previous firmware refreshed the
display inside its control loop, so every redraw stretched the control step.
Here ``tick`` is called as fast as the caller likes, but the control step
fires on a fixed 250 ms schedule measured against a monotonic clock, and
rendering happens with whatever time is left. If a redraw overruns, the next
control step is late by that much and the supervisor sees it -- which is
exactly what its stale-reading guard is for.

**Nothing heats without the supervisor.** The controller proposes a duty; the
supervisor holds a veto; the relay is only ever driven with both in agreement.
There is no path from profile to relay that bypasses it.

Pure stdlib -- runs on the device and under CPython for tests.
"""

from . import metrics
from .safety import Supervisor

STATE_IDLE = "idle"
STATE_PREHEAT = "preheat"
# Heating the element, clock held, before the run proper. See _in_precharge.
STATE_PRECHARGE = "precharge"
STATE_RUNNING = "running"
STATE_COOLDOWN = "cooldown"
STATE_REPORT = "report"
STATE_FAULT = "fault"

CONTROL_INTERVAL_S = 0.25

# How close to the profile's starting temperature the oven must be before the
# clock starts. Beginning a run from an arbitrary temperature is the largest
# avoidable source of run-to-run variation.
PREHEAT_TOLERANCE_C = 5.0
PREHEAT_TIMEOUT_S = 900.0

# Opening the door reaches the probe in about four seconds.
#
# Measured: the operator opened the door within two seconds of the screen
# asking, and cooling faster than -1.5 C/s appeared four seconds after that,
# reaching -5.2 C/s within ten. Closed, this oven manages -0.4 C/s.
#
# Two wrong numbers were published for this before it was right. The trace
# appeared to show a 60 s delay, which was read first as a slow operator
# and then as thermal lag in the probe. Both were artefacts of anchoring to
# a prompt that never appeared on screen -- the banner was not wired up, so
# what the operator actually responded to was the cooldown screen a minute
# later. The instrument was wrong, not the oven.
DOOR_COOLING_C_PER_S = 5.2

# Below this the cooldown is finished and the oven is safe to open or reload.
COOLDOWN_TARGET_C = 60.0

# A warm start is normal for a tool in use: back-to-back boards, or a run
# begun shortly after the last. The profile simply holds heat off until its
# own curve catches up with wherever the oven already is.


class Event(object):
    """Something the UI, the log or the speaker should react to."""
    RUN_STARTED = "run_started"
    STAGE_CHANGED = "stage_changed"
    PEAK_REACHED = "peak_reached"
    ABOVE_LIQUIDUS = "above_liquidus"
    BELOW_LIQUIDUS = "below_liquidus"
    OPEN_THE_DOOR = "open_the_door"
    RUN_FINISHED = "run_finished"
    FAULTED = "faulted"
    ABORTED = "aborted"


class App(object):
    def __init__(self, relay, sensor, clock, controller_factory,
                 supervisor=None, on_event=None, sample=None):
        self.relay = relay
        self.sensor = sensor
        self.clock = clock
        self.controller_factory = controller_factory
        self.supervisor = supervisor or Supervisor()
        self.on_event = on_event or (lambda name, payload: None)
        self.sample = sample or (lambda row: None)

        self.state = STATE_IDLE
        self.profile = None
        self.controller = None
        self.metrics = None
        self.reading = None
        self.temperature = None
        self.target = None
        self.duty = 0.0
        self.elapsed = 0.0
        self.stage = None
        self.fault = None

        self._next_control = None
        self._state_entered = None
        self._run_started = None
        # (profile, temperature) -> a PreCharge, or None to skip. Injected
        # so the state machine can be tested without the model, and so the
        # model can be tested without the state machine.
        self.precharge_factory = None
        self._precharge = None
        # (profile, temp_c) -> ElementObserver, or None. One observer per
        # run: pre-charge fills it, and the controller reads it for the
        # rest of the run. See Controller.duty_for's element_z.
        self.observer_factory = None
        self.observer = None
        self._above = False
        self._door_prompted = False
        self.door_in_s = None

    # -- lifecycle ---------------------------------------------------------

    def request_start(self, profile):
        """Begin a run. Returns None, or a Fault explaining the refusal."""
        if self.state not in (STATE_IDLE, STATE_REPORT):
            return None
        reading = self._read()
        problem = self.supervisor.check_start(reading)
        if problem is not None:
            return problem
        self.profile = profile
        self.controller = self.controller_factory(profile)
        self.metrics = metrics.RunMetrics(profile.liquidus_c or 0.0)
        self._above = False
        self._door_prompted = False
        self.door_in_s = None
        self._enter(STATE_PREHEAT)
        return None

    def abort(self):
        if self.state in (STATE_PREHEAT, STATE_PRECHARGE, STATE_RUNNING):
            self.relay.set(False)
            self._emit(Event.ABORTED, {})
            self._enter(STATE_COOLDOWN)

    def acknowledge_fault(self):
        if self.state == STATE_FAULT:
            self.supervisor.acknowledge()
            self.fault = None
            self._enter(STATE_IDLE)

    # -- the loop ----------------------------------------------------------

    def tick(self):
        """Call as often as you like. The control step self-schedules."""
        now = self.clock.monotonic()
        if self._next_control is None:
            self._next_control = now
        if now < self._next_control:
            return False
        # Schedule from the deadline, not from now, so a slow render does not
        # let the cadence drift permanently late.
        self._next_control += CONTROL_INTERVAL_S
        if self._next_control < now - CONTROL_INTERVAL_S:
            self._next_control = now + CONTROL_INTERVAL_S
        self._control_step(now)
        return True

    def _control_step(self, now):
        relay_was_on = self.relay.is_on()
        self.reading = self._read()
        self.temperature = self.reading.hot if self.reading else None

        fault = self.supervisor.update(now, self.reading, relay_was_on)
        if fault is not None:
            self.relay.set(False)
            # Announced once, not every step. The supervisor goes on
            # returning a latched fault until it is acknowledged, and this
            # used to announce it again each time: on 2026-09-11 a dead
            # sensor printed the same line 888 times, buried the console's
            # answer to STATUS at the moment it mattered whether the relay
            # was open, and wrote every copy into the run's log. If the
            # supervisor ever returns a different fault, that is announced.
            news = not (self.state == STATE_FAULT and self.fault is not None
                        and self.fault.code == fault.code)
            self.fault = fault
            if news:
                self._emit(Event.FAULTED, {"fault": fault})
                self._enter(STATE_FAULT)
            return

        if self.supervisor.blind:
            # A missed reading the supervisor is tolerating. No state handler
            # runs: each one wants a temperature, and the controller would
            # act on nothing. The relay opens for the step, so being blind
            # can only ever cost heat. The profile clock keeps running, which
            # is why the supervisor only tolerates a short miss.
            self.temperature = None
            self.relay.set(False)
            self.duty = 0.0
            self.sample({"t": now, "state": self.state, "temp": None,
                         "target": self.target, "duty": 0.0,
                         "relay": False,
                         "cold": self.reading.cold if self.reading else None})
            return

        handler = getattr(self, "_in_" + self.state)
        handler(now)

        self.sample({"t": now, "state": self.state, "temp": self.temperature,
                     "target": self.target, "duty": self.duty,
                     "relay": self.relay.is_on(),
                     "cold": self.reading.cold if self.reading else None})

    # -- states ------------------------------------------------------------

    def _in_idle(self, now):
        self.relay.set(False)
        self.duty = 0.0
        self.target = None

    def _in_fault(self, now):
        self.relay.set(False)
        self.duty = 0.0

    def _in_report(self, now):
        self.relay.set(False)
        self.duty = 0.0

    def _in_preheat(self, now):
        """Hold at the profile's starting temperature, then start the clock."""
        start_c = self.profile.target_at(0.0)
        self.target = start_c
        temp = self.temperature
        if temp is None:
            self.relay.set(False)
            return
        if temp >= start_c - PREHEAT_TOLERANCE_C:
            self._begin_precharge_or_run(now)
            return
        if now - self._state_entered > PREHEAT_TIMEOUT_S:
            self.relay.set(False)
            self._emit(Event.ABORTED, {"reason": "preheat timed out"})
            self._enter(STATE_COOLDOWN)
            return
        # Gentle approach: never more than half power getting to the start.
        self.duty = 0.5 if temp < start_c - PREHEAT_TOLERANCE_C else 0.0
        self._drive(now, self.duty)

    @property
    def door_prompted(self):
        """Whether the operator has been asked to open the door.

        Exposed so the running screen can show it. An event on the serial
        console is invisible to someone standing at the oven, which is the
        only person who can act on it.
        """
        return self._door_prompted

    def _prompt_door_for_liquidus_window(self, temp):
        """Ask for the door when opening it now lands inside the window.

        Time above liquidus is what a low-temperature alloy cares about, and
        both ends of the window matter: on the measured NC191 run, opening
        the door at the peak would have given 44 s against a 60 s minimum,
        while leaving it shut gave 133 s against a 90 s maximum. Earlier is
        not simply better.

        So the prompt fires when the run has banked enough time that the
        descent will land it mid-window: accumulated time above liquidus,
        plus what the descent itself will add at the measured door-open
        rate, reaching the middle of the profile's own window.

        The descent is short -- the door reaches the probe in about four
        seconds and then pulls 5.2 C/s -- so it is the accumulated time,
        not the descent, that decides the outcome.
        """
        self.door_in_s = None
        if self._door_prompted or self.profile is None or temp is None:
            return
        if not getattr(self.profile, "cooling_assumes_open_door", False):
            return
        if self.metrics is None or self.profile.liquidus_c is None:
            return
        floor = self.profile.tal_min_s
        if not floor:
            return
        ceiling = self.profile.tal_max_s or floor
        target = (floor + ceiling) / 2.0
        descent_s = max(0.0, (temp - self.profile.liquidus_c)
                        / DOOR_COOLING_C_PER_S)
        # How long until it will be time. Time above liquidus grows at one
        # second per second while the oven is above it, so the shortfall in
        # seconds IS the countdown -- no prediction machinery, and it
        # self-corrects every tick as the temperature moves.
        #
        # Worth having because the alternative was asking for the door with
        # no notice at all. On NC191LTA10 the request went up while the
        # operator was across the room, and the twenty-six seconds it took
        # them to reach it was the whole of that run's overrun.
        shortfall = target - (self.metrics.time_above_liquidus + descent_s)
        if shortfall > 0:
            if self.metrics.time_above_liquidus > 0.0:
                self.door_in_s = shortfall
            return
        self._door_prompted = True
        self._emit(Event.OPEN_THE_DOOR,
                   {"temp": temp,
                    "tal_s": round(self.metrics.time_above_liquidus, 1),
                    "reason": "open now to land inside this profile's time "
                              "above liquidus"})

    def _begin_precharge_or_run(self, now):
        """Charge the element first if there is a reason to, else just go.

        The warm-start lag is a saturated actuator: the curve asks for a
        rate the instant the clock starts, the element is stone cold, and
        for ten to fourteen seconds nothing the controller asks for arrives.
        Measured at -24 C from a 34 C start and -32 C from 59 C, with duty
        at 1.0 throughout. More gain cannot help; earlier heat can. So the
        element is driven at full duty with the profile clock held, until
        an observer says its contribution has reached what the curve's
        opening needs, or a bound is hit. Simulated: -19.8 C to -6.4 C at
        the hottest legal start, and nothing changes on a cold one.
        """
        self._precharge = None
        self.observer = None
        if self.observer_factory is not None and self.temperature is not None:
            try:
                self.observer = self.observer_factory(self.profile,
                                                      self.temperature)
            except Exception as e:
                print("# observer: not available (%r); loop acts on the present" % e)
                self.observer = None
        if self.precharge_factory is not None and self.temperature is not None:
            try:
                self._precharge = self.precharge_factory(self.profile,
                                                         self.temperature,
                                                         self.observer)
            except Exception as e:
                print("# precharge: not available (%r); starting directly" % e)
                self._precharge = None
        if self._precharge is None:
            self._begin_running(now)
            return
        self.supervisor.begin_run(
            now, expected_duration_s=(self._precharge.max_s
                                      + (self.profile.duration
                                         if self.profile else 0.0)))
        self._enter(STATE_PRECHARGE)
        self._emit(Event.STAGE_CHANGED, {"stage": "precharge"})

    def _in_precharge(self, now):
        pc = self._precharge
        temp = self.temperature
        if temp is None or pc is None:
            self.relay.set(False)
            if pc is None:
                self._begin_running(now)
            return
        pc.observer.update(now, temp, 1.0 if self.relay.is_on() else 0.0)
        duty = pc.duty(now)
        if duty is None:
            # Ready, or out of time. Enter the profile wherever the oven
            # now is -- entry_time_for is unchanged -- with an element that
            # can follow it. The supervisor keeps the run it was given.
            self.relay.set(False)
            self._emit(Event.STAGE_CHANGED,
                       {"stage": "precharge done",
                        "seconds": round(now - (pc.started_at or now), 1),
                        "z": round(pc.observer.z, 3)})
            self._begin_running(now, supervisor_already_running=True)
            return
        self.duty = duty
        self._drive(now, duty)

    def _begin_running(self, now, supervisor_already_running=False):
        # Enter the profile where the oven already is, not always at zero.
        #
        # A warm oven started at t=0 opens with the target below it, so the
        # controller withholds heat while the profile burns through a ramp
        # already achieved. Not a bug fix: two back-to-back SAC305 runs from
        # ~50 C both met their J-STD windows without this. It shortens a
        # warm run and gives the controller a meaningful target from the
        # first second. Not yet validated on hardware.
        entry = 0.0
        if self.profile is not None and self.temperature is not None:
            entry = self.profile.entry_time_for(self.temperature)

        self._run_started = now - entry
        self.elapsed = entry
        if not supervisor_already_running:
            self.supervisor.begin_run(
                now, expected_duration_s=(self.profile.duration - entry)
                if self.profile is not None else None)
        self.controller.reset(now)
        self._enter(STATE_RUNNING)
        payload = {"profile": self.profile.name}
        if entry > 0.0:
            # Worth saying out loud: it changes what the run means, and a
            # large skip is a sign the oven was not given time to cool.
            payload["entered_at_s"] = round(entry, 1)
            payload["oven_c"] = round(self.temperature, 1)
        self._emit(Event.RUN_STARTED, payload)

    def _in_running(self, now):
        self.elapsed = now - self._run_started
        temp = self.temperature
        self.target = self.profile.target_at(self.elapsed)
        self.metrics.add(self.elapsed, temp)
        self._track_stage()
        self._track_liquidus(temp)
        self._prompt_door_for_liquidus_window(temp)

        if self.elapsed >= self.profile.duration:
            self.relay.set(False)
            self._emit(Event.RUN_FINISHED, {})
            self._enter(STATE_COOLDOWN)
            return

        z = None
        if self.observer is not None and temp is not None:
            z = self.observer.update(now, temp,
                                     1.0 if self.relay.is_on() else 0.0)
        self.duty = self.controller.duty_for(self.elapsed, temp, now,
                                             element_z=z)
        self._drive(now, self.duty)

    def _in_cooldown(self, now):
        self.relay.set(False)
        self.duty = 0.0
        self.target = None
        temp = self.temperature
        if temp is None:
            return
        if self.metrics is not None:
            self.metrics.add(now - (self._run_started or now), temp)
        self._track_liquidus(temp)
        if not self._door_prompted and self.profile is not None:
            liq = self.profile.liquidus_c
            if liq is None or temp < liq:
                self._door_prompted = True
                self._emit(Event.OPEN_THE_DOOR, {"temp": temp})
        if temp <= COOLDOWN_TARGET_C:
            self.supervisor.end_run()
            self._enter(STATE_REPORT)

    # -- helpers -----------------------------------------------------------

    def _drive(self, now, duty):
        if not self.supervisor.allow_heat():
            self.relay.set(False)
            return
        if self.controller is not None:
            # Every heating state modulates through the same time-proportional
            # output. Preheat used to be a special case that bang-banged on
            # `duty > 0.5` -- while the only duty preheat ever asks for is
            # exactly 0.5, so the relay could never close. On hardware the
            # oven sat at 26.5 C with a 45 C target, reporting duty=0.500 each
            # step and cooling, and would have done so until the 900 s
            # timeout. Telemetry looked correct throughout, which is why this
            # went unnoticed through eleven runs: only profiles starting above
            # ambient enter preheat at all, and none of them had.
            self.relay.set(self.controller.relay_state(now, duty))
        else:
            self.relay.set(duty >= 0.5)

    def _read(self):
        try:
            return self.sensor.read()
        except Exception:
            return None

    def _track_stage(self):
        stages = self.profile.stages
        current = None
        for name, t0, t1 in stages:
            if t0 <= self.elapsed < t1:
                current = name
                break
        if current != self.stage:
            self.stage = current
            self._emit(Event.STAGE_CHANGED, {"stage": current})

    def _track_liquidus(self, temp):
        liq = self.profile.liquidus_c if self.profile else None
        if liq is None or temp is None:
            return
        above = temp >= liq
        if above and not self._above:
            self._above = True
            self._emit(Event.ABOVE_LIQUIDUS, {"temp": temp})
        elif not above and self._above:
            self._above = False
            self._emit(Event.BELOW_LIQUIDUS, {"temp": temp})

    def _enter(self, state):
        self.state = state
        self._state_entered = self.clock.monotonic()
        # Cooldown is entered from three places -- a finished profile, an
        # abort, and a preheat that timed out -- so the handover to the
        # cooldown clock is done here rather than at each of them.
        if state == STATE_COOLDOWN:
            self.supervisor.begin_cooldown(self._state_entered)

    def _emit(self, name, payload):
        try:
            self.on_event(name, payload)
        except Exception as e:
            # A broken UI must never stop the control loop -- but it should
            # not be able to hide either.
            print("# WARNING event handler failed for %s: %r" % (name, e))
