Taeron-Systems-Inc/BespokeToast/firmware/oven/metrics.py

# SPDX-License-Identifier: MIT
"""What actually happened during a run.

The previous firmware kept no record of any run it ever performed. These are
the numbers that decide whether the joints are sound, computed as the run
proceeds so they can also be shown live: time above liquidus is the one an
operator wants on screen while it is still possible to do something about it.

Limits follow J-STD-020 for lead-free assembly. They are defaults, not
gospel — a paste datasheet overrides them.
"""


class Limits(object):
    __slots__ = ("max_ramp_up_c_per_s", "max_ramp_down_c_per_s",
                 "tal_min_s", "tal_max_s", "peak_min_c", "peak_max_c",
                 "max_time_to_peak_s")

    def __init__(self, max_ramp_up_c_per_s=3.0, max_ramp_down_c_per_s=6.0,
                 tal_min_s=60.0, tal_max_s=150.0, peak_min_c=235.0,
                 peak_max_c=250.0, max_time_to_peak_s=480.0):
        self.max_ramp_up_c_per_s = max_ramp_up_c_per_s
        self.max_ramp_down_c_per_s = max_ramp_down_c_per_s
        self.tal_min_s = tal_min_s
        self.tal_max_s = tal_max_s
        self.peak_min_c = peak_min_c
        self.peak_max_c = peak_max_c
        self.max_time_to_peak_s = max_time_to_peak_s


    @classmethod
    def for_profile(cls, profile, peak_tolerance_c=10.0):
        """Judge a run against the profile it was asked to follow.

        A generic J-STD peak window is the wrong yardstick for a profile that
        deliberately peaks elsewhere: the datasheet curve for this paste tops
        out below the window, and marking every faithful run as a failure
        teaches operators to ignore the report. The absolute ramp limits stay
        as backstops, with the paste's own preheat limit preferred when it
        declares one.
        """
        peak = profile.peak[1]
        # Reflow only. See the note on the check itself.
        reflow = getattr(profile, "category", "reflow") == "reflow"
        return cls(
            max_time_to_peak_s=(480.0 if reflow else None),
            max_ramp_up_c_per_s=(profile.max_ramp_up_c_per_s or 3.0),
            peak_min_c=peak - peak_tolerance_c,
            peak_max_c=peak + peak_tolerance_c,
            tal_min_s=(profile.tal_min_s
                       if profile.tal_min_s is not None else 60.0),
            tal_max_s=(profile.tal_max_s
                       if profile.tal_max_s is not None else 150.0),
        )


class RunMetrics(object):
    """Accumulates a run sample by sample.

    Ramp rates are measured over a short window rather than between adjacent
    samples: at a 4 Hz cadence with 0.0625 C sensor resolution, consecutive
    differences are mostly quantisation noise, and a single step would read
    as 0.25 C/s out of nowhere.
    """

    def __init__(self, liquidus_c, rate_window_s=5.0, min_window_s=3.0):
        self.liquidus_c = liquidus_c
        self.rate_window_s = rate_window_s
        self.min_window_s = min_window_s
        self.samples = []
        self.peak_c = None
        self.peak_t = None
        self.time_above_liquidus = 0.0
        self.max_ramp_up = 0.0
        self.max_ramp_down = 0.0
        self._last_t = None
        self._last_above = False

    def add(self, t, temp_c):
        if self.peak_c is None or temp_c > self.peak_c:
            self.peak_c = temp_c
            self.peak_t = t

        # A bake has no liquidus, and "temp_c >= 0" is true from the
        # first sample: run 0009 reported tal=15302 s on a 15201 s bake,
        # a number larger than the run that produced it. Nothing above a
        # liquidus that does not exist.
        above = bool(self.liquidus_c) and temp_c >= self.liquidus_c
        if self._last_t is not None:
            dt = t - self._last_t
            if above and self._last_above:
                self.time_above_liquidus += dt
            elif above != self._last_above and self.samples:
                # interpolate the crossing instead of counting a whole step
                t0, c0 = self.samples[-1]
                if c0 != temp_c:
                    frac = (self.liquidus_c - c0) / (temp_c - c0)
                    cross = t0 + frac * (t - t0)
                    self.time_above_liquidus += (t - cross) if above else 0.0

        self.samples.append((t, temp_c))
        self._trim()
        rate = self._windowed_rate()
        if rate is not None:
            if rate > self.max_ramp_up:
                self.max_ramp_up = rate
            if rate < self.max_ramp_down:
                self.max_ramp_down = rate

        self._last_t = t
        self._last_above = above

    def _trim(self):
        # keep only what the rate window needs, plus a little slack
        cutoff = self.samples[-1][0] - self.rate_window_s * 2
        while len(self.samples) > 4 and self.samples[0][0] < cutoff:
            self.samples.pop(0)

    def _windowed_rate(self):
        """The rise over the longest window up to rate_window_s, or nothing.

        The upper bound was always here; the lower one was not, and for the
        first few seconds of a run the buffer holds only a fraction of a
        second. Run 0004 reported "max ramp up FAILED 3.20 C/s" against a
        2.5 limit -- a rate 73% above anything this oven can produce, absent
        from its own log, and not reproducible in simulation. Every other
        run of the day reported 1.87 to 2.03, which is the plant. A degree
        of thermocouple noise over a 0.3 s window is 3 C/s, and the report
        then shows a red line for a run that did nothing wrong, which is how
        operators learn to ignore reports.
        """
        if len(self.samples) < 2:
            return None
        t1, c1 = self.samples[-1]
        for t0, c0 in self.samples:
            if t1 - t0 <= self.rate_window_s:
                if t1 - t0 < self.min_window_s:
                    return None
                return (c1 - c0) / (t1 - t0)
        return None

    def time_to_peak(self):
        return self.peak_t

    def check(self, limits=None):
        """Compare against the limits. Returns a list of
        ``(name, value, ok, text)`` so a report can show every line, not just
        the failures."""
        lim = limits or Limits()
        out = []

        def add(name, value, ok, text):
            out.append((name, value, ok, text))

        add("peak", self.peak_c,
            self.peak_c is not None
            and lim.peak_min_c <= self.peak_c <= lim.peak_max_c,
            "%d \u00b0C (want %.0f-%.0f)" % (round(self.peak_c or 0),
                                          lim.peak_min_c, lim.peak_max_c))
        # Only where there is a liquidus to be above. A profile that melts
        # nothing -- the bake, the step test -- is constructed with 0.0 as
        # its liquidus, so every sample counts and the report shows a red
        # FAILED for a check the run could not pass or fail. STEP 250 C
        # reported "time above liquidus FAILED 1033 s" on a run that was
        # otherwise clean, and a report that cries wolf is one people stop
        # reading.
        if self.liquidus_c:
            add("time above liquidus", self.time_above_liquidus,
                lim.tal_min_s <= self.time_above_liquidus <= lim.tal_max_s,
                "%.0f s (want %.0f-%.0f)" % (self.time_above_liquidus,
                                             lim.tal_min_s, lim.tal_max_s))
        add("max ramp up", self.max_ramp_up,
            self.max_ramp_up <= lim.max_ramp_up_c_per_s,
            "%.2f \u00b0C/s (limit %.1f)" % (self.max_ramp_up,
                                          lim.max_ramp_up_c_per_s))
        add("max ramp down", self.max_ramp_down,
            -self.max_ramp_down <= lim.max_ramp_down_c_per_s,
            "%.2f \u00b0C/s (limit %.1f)" % (self.max_ramp_down,
                                          lim.max_ramp_down_c_per_s))
        # Only where getting there quickly is part of the process. The
        # 480 s ceiling is J-STD-020's, and it exists to limit how long a
        # board spends hot on the way to reflow. A bake deliberately spends
        # four hours at 125 C and reaches its "peak" whenever the room lets
        # it, so run 0024 -- a clean four-hour bake -- reported "time to
        # peak FAILED 5916 s (limit 480)". That is the same bug the
        # liquidus guard above exists for: a red FAILED on a check the run
        # could neither pass nor fail, on a report people then stop reading.
        if self.peak_t is not None and lim.max_time_to_peak_s:
            add("time to peak", self.peak_t,
                self.peak_t <= lim.max_time_to_peak_s,
                "%.0f s (limit %.0f)" % (self.peak_t,
                                         lim.max_time_to_peak_s))
        return out

    def passed(self, limits=None):
        return all(ok for _, _, ok, _ in self.check(limits))
