Taeron-Systems-Inc/BespokeToast/firmware/oven/hal.py

# SPDX-License-Identifier: MIT
"""Hardware interfaces.

Everything else in this package talks to the oven only through the shapes
described here. Nothing in this module imports ``board`` — the real
implementations live in ``hardware.py``, and the tests substitute simulated
ones. That separation is what lets the control and safety logic run under
CPython on a laptop.

These are documentation, not enforced base classes: CircuitPython has no
``abc``, and duck typing costs nothing here.

Clock
    ``monotonic()`` -> float seconds, monotonically increasing.

TempSensor
    ``read()`` -> ``Reading``. Must not raise for ordinary sensor faults;
    report them in the reading so the safety layer decides what they mean.

Relay
    ``set(on)`` and ``is_on()``. ``set(False)`` must be the safe direction.
    The real one is an ``Interlocked`` below, which adds ``hold_off`` and
    ``release``.
"""

# Sensor fault flags, combined as a bitmask on Reading.faults.
FAULT_NONE = 0
FAULT_OPEN_CIRCUIT = 1 << 0    # thermocouple open / disconnected
FAULT_SHORT_CIRCUIT = 1 << 1   # thermocouple shorted
FAULT_BUS = 1 << 2             # I2C or device communication failure
FAULT_RANGE = 1 << 3           # reading outside the sensor's valid range

FAULT_NAMES = (
    (FAULT_OPEN_CIRCUIT, "thermocouple open circuit"),
    (FAULT_SHORT_CIRCUIT, "thermocouple short circuit"),
    (FAULT_BUS, "sensor bus failure"),
    (FAULT_RANGE, "reading out of range"),
)


# The MCP9601's status register (0x04) carries the two probe faults. Bit 4 is
# what the MCP9600 calls "input range"; on this part it is set when the probe
# is open *or* its voltage is outside the type-K range, and at oven
# temperatures only a wiring fault produces the second. Bit 5 is a probe
# shorted to VDD or ground.
MCP9601_STATUS_OPEN_CIRCUIT = 1 << 4
MCP9601_STATUS_SHORT_CIRCUIT = 1 << 5


def mcp9601_status_faults(status):
    """FAULT_* bits for an MCP9601 status register value.

    Here rather than in hardware.py so it runs, and is tested, under CPython.
    """
    faults = FAULT_NONE
    if status & MCP9601_STATUS_OPEN_CIRCUIT:
        faults |= FAULT_OPEN_CIRCUIT
    if status & MCP9601_STATUS_SHORT_CIRCUIT:
        faults |= FAULT_SHORT_CIRCUIT
    return faults


def describe_faults(faults):
    """Human-readable list of the fault bits set in *faults*."""
    if not faults:
        return []
    return [name for bit, name in FAULT_NAMES if faults & bit]


class Reading(object):
    """One temperature sample.

    ``hot`` is the thermocouple junction in °C, or None if unavailable.
    ``cold`` is the sensor's own cold-junction temperature in °C, which
    doubles as a measure of how warm the enclosure is getting. ``faults`` is
    a bitmask of the FAULT_* constants above.

    A reading with faults set may still carry a value; it is the safety
    layer's job to refuse it, not the driver's job to hide it.
    """

    __slots__ = ("hot", "cold", "faults", "t", "cpu")

    def __init__(self, hot, cold=None, faults=FAULT_NONE, t=None, cpu=None):
        self.hot = hot
        self.cold = cold
        self.faults = faults
        self.t = t
        # Controller die temperature: a second thermometer in the same box on
        # a different chip. The difference between it and ``cold`` is what
        # shows whether the enclosure is warming or just the sensor.
        self.cpu = cpu

    @property
    def ok(self):
        return self.faults == FAULT_NONE and self.hot is not None

    def __repr__(self):
        return "Reading(hot=%r, cold=%r, faults=%d)" % (
            self.hot, self.cold, self.faults)


class Interlocked(object):
    """A relay that something else can hold open, whatever is asking for heat.

    The logic of hardware.Relay, kept here so it runs under CPython; the
    subclass supplies ``_drive(on)``, which writes the pin.

    ``hold_off(who)`` drives the relay open at once, and until every holder
    has called ``release(who)``, ``set(True)`` drives it open too. It exists
    for the speaker: there is no watchdog on this board, so a speaker call
    that hung with the relay closed would heat without bound. Holding the
    relay open first means any such hang happens with the oven cold. It is
    enforced here, in the object that owns the pin, because that is the one
    place no caller can go around.

    The holder is recorded before the pin is written, so a hold that fails
    part-way still refuses heat until it is released.
    """

    def __init__(self):
        self._on = False
        self._holds = []
        self.actuations = 0

    def _drive(self, on):
        raise NotImplementedError

    def set(self, on):
        on = bool(on) and not self._holds
        # Written first, recorded after: if the write raises, is_on() goes
        # on reporting what the pin was last known to be, not what was
        # asked for. A relay that could not be opened must not read open.
        self._drive(on)
        if on != self._on:
            self.actuations += 1
            self._on = on

    def is_on(self):
        return self._on

    def off(self):
        self.set(False)

    def hold_off(self, who):
        if who not in self._holds:
            self._holds.append(who)
        self.set(False)

    def release(self, who):
        if who in self._holds:
            self._holds.remove(who)

    @property
    def held(self):
        return bool(self._holds)
