Taeron-Systems-Inc/BespokeToast/tests/test_ui.py

"""Layout tests.

Screens are emitted as drawing primitives rather than pushed straight into
displayio, which makes the things that actually go wrong on a small resistive
touchscreen testable without a board: targets too small to hit, text running
off the edge, the abort button not being where a panicking hand expects it.
"""

import os

import pytest

from oven.ui import layout as L
from oven.ui import theme as T


def bounds_ok(cmd):
    kind = cmd[0]
    if kind == "text":
        _, x, y = cmd[0], cmd[1], cmd[2]
        return 0 <= x < T.SCREEN_W and 0 <= y < T.SCREEN_H
    if kind in ("rect", "touch"):
        _, x, y, w, h = cmd[0], cmd[1], cmd[2], cmd[3], cmd[4]
        return x >= 0 and y >= 0 and x + w <= T.SCREEN_W and y + h <= T.SCREEN_H
    return True


SCREENS = {
    "splash": lambda: L.splash("v2.0"),
    "home_ready": lambda: L.home(24.5, "SAC305 (this oven)", True),
    "home_hot": lambda: L.home(84.0, "SAC305 (this oven)", False, "oven too hot"),
    "home_networked": lambda: L.home(24.5, "NC191LTA10 (datasheet)", True,
                                     address="10.20.10.242"),
    "home_widest_address": lambda: L.home(24.5, "SAC305 reduced peak", True,
                                          address="255.255.255.255"),
    "running": lambda: L.running(212.4, 215.0, 300, 180, "reflow", 42,
                                 217, 0.62, True,
                                 history=[(i * 4.0, 25 + i * 2.0) for i in range(50)],
                                 profile_points=[(0, 25), (200, 180), (300, 235), (488, 150)],
                                 duration_s=488),
    "running_early": lambda: L.running(25.0, 25.0, 0, 480, "preheat", 0,
                                       217, 0.0, False),
    "door": lambda: L.open_the_door(205.0, -5.2),
    "fault": lambda: L.fault("thermocouple fault: open circuit"),
    "report": lambda: L.report([("peak", 237.0, True, "237 C (want 225-245)"),
                                ("time above liquidus", 94, True, "94 s")],
                               237.0, 94),
}


@pytest.mark.parametrize("name", sorted(SCREENS))
def test_everything_stays_on_screen(name):
    for cmd in SCREENS[name]():
        assert bounds_ok(cmd), "%s: %r runs off the display" % (name, cmd)


@pytest.mark.parametrize("name", sorted(SCREENS))
def test_text_does_not_run_off_the_right_edge(name):
    for cmd in SCREENS[name]():
        if cmd[0] != "text":
            continue
        _, x, _, text, _, font = cmd
        end = x + _width(text, font)
        assert end <= T.SCREEN_W, \
            "%s: %r ends at %d, past the %d px edge" % (name, text, end, T.SCREEN_W)


@pytest.mark.parametrize("name", sorted(SCREENS))
def test_touch_targets_are_big_enough_for_a_fingertip(name):
    for cmd in SCREENS[name]():
        if cmd[0] == "touch":
            _, _, _, w, h, target = cmd
            assert w >= T.MIN_TOUCH_PX and h >= T.MIN_TOUCH_PX, \
                "%s: target %r is %dx%d, too small for resistive touch" % (
                    name, target, w, h)


def test_abort_is_generous_and_in_a_corner():
    """Comfortably hittable and hard against a corner, because it is the one
    control pressed in a hurry. It moved from bottom-right to top-right when
    the chart took the middle of the screen, and was trimmed once it turned
    out to be larger than it needed to be."""
    cmds = SCREENS["running"]()
    abort = [c for c in cmds if c[0] == "touch" and c[5] == "abort"]
    assert abort, "the run screen must always offer abort"
    _, x, y, w, h, _ = abort[0]
    assert h >= T.ABORT_TOUCH_PX
    assert w >= T.ABORT_TOUCH_PX
    assert x + w >= T.SCREEN_W - 12, "abort must hug the right edge"
    assert y <= 20 or y + h >= T.SCREEN_H - 20, "and the top or bottom"
    others = [c for c in cmds if c[0] == "touch" and c[5] != "abort"]
    for _, _, _, ow, oh, _ in others:
        assert w * h >= ow * oh, "abort must be the largest target"


def test_hit_testing_finds_the_target():
    cmds = SCREENS["running"]()
    abort = [c for c in cmds if c[0] == "touch" and c[5] == "abort"][0]
    _, x, y, w, h, _ = abort
    assert L.hit(cmds, x + w // 2, y + h // 2) == "abort"
    assert L.hit(cmds, 2, 2) is None


def test_the_fault_screen_cannot_be_dismissed_by_accident():
    cmds = L.fault("over temperature: 261 C reached the 260 C limit")
    targets = [c[5] for c in cmds if c[0] == "touch"]
    assert targets == ["acknowledge"], "a fault screen offers one action only"


def test_the_delta_colour_escalates():
    assert T.delta_colour(1.0) == T.BRAND
    assert T.delta_colour(5.0) == T.CAUTION
    assert T.delta_colour(30.0) == T.DANGER
    assert T.delta_colour(-30.0) == T.DANGER
    assert T.delta_colour(None) == T.DIM


def test_the_current_stage_is_named():
    """The four-stage strip is gone -- the chart shows progress better than a
    row of words -- so only the stage actually in progress is named."""
    cmds = L.running(212.0, 215.0, 300, 180, "reflow", 42, 217, 0.6, True)
    named = [c[3] for c in cmds if c[0] == "text" and c[3] == "REFLOW"]
    assert named == ["REFLOW"]
    assert not [c for c in cmds if c[0] == "text" and c[3] == "PREHEAT"]


def test_the_run_screen_plots_target_against_actual():
    cmds = SCREENS["running"]()
    plots = [c for c in cmds if c[0] == "plot"]
    assert len(plots) == 1
    _, _, _, w, h, _, _, _, series, liquidus = plots[0]
    assert w > 200 and h > 80, "the chart should dominate the screen"
    assert len(series) == 2, "both the target curve and the actual trace"
    assert liquidus == 217, "the liquidus line is the reference that matters"


def test_missing_values_render_as_dashes_not_crashes():
    for cmd in L.running(None, None, 0, 0, None, None, 217, None, False):
        assert bounds_ok(cmd)


def test_assets_referenced_by_the_theme_exist():
    root = os.path.join(os.path.dirname(__file__), "..", "firmware")
    for path in (T.FONT_READOUT, T.FONT_READOUT_XL, T.FONT_LARGE,
                 T.FONT_BODY, T.FONT_SMALL,
                 T.LOGO_LARGE, T.LOGO_SMALL):
        assert os.path.exists(root + path), "%s is referenced but not shipped" % path


def test_font_budget_stays_small():
    """A full charset at 64 px is 329 KB; subsetting is what makes this fit."""
    root = os.path.join(os.path.dirname(__file__), "..", "firmware")
    total = sum(os.path.getsize(root + p) for p in
                (T.FONT_READOUT, T.FONT_READOUT_XL, T.FONT_LARGE,
                 T.FONT_BODY, T.FONT_SMALL))
    assert total < 60000, "fonts total %d bytes" % total


# -- font coverage ----------------------------------------------------------

def _coverage():
    import json
    root = os.path.join(os.path.dirname(__file__), "..", "firmware")
    return json.load(open(root + "/assets/fonts/coverage.json"))


@pytest.mark.parametrize("name", sorted(SCREENS))
def test_every_string_uses_glyphs_its_font_actually_has(name):
    """The readout font is subsetted to digits: a full charset at 64 px costs
    329 KB to draw ten numerals. Rendering a letter in it does not fall back,
    it raises TypeError deep inside adafruit_display_text.

    This shipped. The word OPEN was drawn in the digits-only font, so the
    firmware died the moment it entered cooldown -- and the fault screen had
    the same bug, which would have crashed the one screen that must survive.
    """
    cov = _coverage()
    for cmd in SCREENS[name]():
        if cmd[0] != "text":
            continue
        _, _, _, text, _, font = cmd
        if font not in cov:
            continue
        missing = sorted(set(str(text)) - set(cov[font]))
        assert not missing, (
            "%s: %r needs %r which is not in %s"
            % (name, text, "".join(missing), font.rsplit("/", 1)[-1]))


def test_the_readout_font_is_digits_only_and_stays_that_way():
    cov = _coverage()
    readout = set(cov["/assets/fonts/B612-Bold-64.pcf"])
    assert "O" not in readout and "A" not in readout
    assert set("0123456789.") <= readout


# -- geometry ---------------------------------------------------------------

def _metrics():
    """Real per-glyph advance widths, taken from the BDF the fonts were built
    from. Estimating a single width per font is how the stage strip ended up
    drawn through the target reading."""
    import json
    root = os.path.join(os.path.dirname(__file__), "..", "firmware")
    return json.load(open(root + "/assets/fonts/metrics.json"))


def _width(text, font):
    m = _metrics().get(font)
    if m is None:
        return len(str(text)) * 9
    widths = m["widths"]
    return sum(widths.get(str(ord(c)), m["max_width"]) for c in str(text))


def _rows(cmds):
    rows = {}
    for c in cmds:
        if c[0] == "text":
            _, x, y, text, _, font = c
            rows.setdefault(y, []).append((x, x + _width(text, font), text))
    return rows


@pytest.mark.parametrize("name", sorted(SCREENS))
def test_text_on_the_same_row_does_not_overlap(name):
    """displayio will happily draw one label over another. The first version
    of the chart screen put the stage strip straight through the target
    reading."""
    for y, items in _rows(SCREENS[name]()).items():
        items.sort()
        for (x0, x1, t0), (x2, _, t1) in zip(items, items[1:]):
            assert x1 <= x2 + 2, \
                "%s row y=%d: %r overlaps %r" % (name, y, t0, t1)


@pytest.mark.parametrize("name", sorted(SCREENS))
def test_large_text_fits_vertically(name):
    """Label.y is the vertical centre, not the top: a 64 px readout centred
    at y=4 is half off the display."""
    heights = {"/assets/fonts/B612-Bold-64.pcf": 64,
               "/assets/fonts/B612-Bold-48.pcf": 48,
               "/assets/fonts/B612-24s.pcf": 24}
    for c in SCREENS[name]():
        if c[0] != "text":
            continue
        _, _, y, text, _, font = c
        h = heights.get(font, 16)
        assert y - h // 2 >= 0, "%s: %r starts above the screen" % (name, text)
        assert y + h // 2 <= T.SCREEN_H, "%s: %r runs off the bottom" % (name, text)


def test_temperatures_carry_their_unit():
    """Written the way anyone writes it, so a number on screen is never
    ambiguous."""
    assert L._t(234.28) == "234 °C"
    assert L._t(-3.4) == "-3 °C"
    assert L._t(None) == "-- °C"
    assert "." not in L._t(212.55)
    assert L._rate(-5.2) == "-5.2 °C/s"
    assert L._rate(None) == "-- °C/s"


def test_report_text_is_not_truncated_mid_parenthesis():
    checks = [("peak", 237.0, True, "237° (want 225-245)")]
    for cmd in L.report(checks, 237.0, 94):
        if cmd[0] == "text" and "want" in str(cmd[3]):
            assert cmd[3].count("(") == cmd[3].count(")"), \
                "%r lost its closing bracket" % cmd[3]


@pytest.mark.parametrize("name", sorted(SCREENS))
def test_button_labels_stay_inside_their_boxes(name):
    """A label that overflows its outline reads as a rendering fault even
    when it is technically on screen."""
    cmds = SCREENS[name]()
    boxes = [(c[1], c[2], c[3], c[4]) for c in cmds if c[0] == "rect"
             and not c[6]]
    for c in cmds:
        if c[0] != "text":
            continue
        _, x, y, text, _, font = c
        end = x + _width(text, font)
        for bx, by, bw, bh in boxes:
            if bx <= x <= bx + bw and by <= y <= by + bh:
                assert end <= bx + bw + 1, \
                    "%s: %r overflows its box by %d px" % (
                        name, text, end - (bx + bw))


def test_the_run_screen_keeps_a_constant_shape():
    """Adding or removing an element forces the renderer to rebuild every
    object at once, and that burst is what fails on a fragmented heap. The
    first render failure of a run landed exactly as the oven crossed liquidus
    and the time-above-liquidus readout appeared, so elements are now always
    emitted and blanked instead."""
    def shape(cmds):
        return tuple((c[0], c[5] if c[0] == "text" else None) for c in cmds)
    variants = [
        L.running(25.0, 25.0, 0, 488, "preheat", 0, 217, 0.0, False),
        L.running(150.0, 152.0, 200, 288, "soak", 0, 217, 0.6, True),
        L.running(230.0, 232.0, 300, 188, "reflow", 45, 217, 0.4, True),
        L.running(220.0, 210.0, 400, 88, "cool", 140, 217, 0.0, False),
        L.running(None, None, 0, 0, None, None, 217, None, False),
    ]
    shapes = {shape(v) for v in variants}
    assert len(shapes) == 1, "the run screen changes shape between states"


def test_the_cooldown_screen_keeps_a_constant_shape():
    def shape(cmds):
        return tuple((c[0], c[5] if c[0] == "text" else None) for c in cmds)
    assert shape(L.open_the_door(200.0, -5.0)) == shape(L.open_the_door(80.0, -0.4))
    assert shape(L.open_the_door(200.0, None)) == shape(L.open_the_door(80.0, -0.4))


def test_every_string_a_run_can_produce_is_covered_by_its_font():
    """The screen-level test checks one sample of each screen. This walks the
    values a real run actually passes through -- negative deltas, blanked
    fields, every stage name, three-digit and two-digit temperatures -- because
    a glyph missing from a subsetted font does not fall back, it raises, and
    it will do so only on the frame that first needs the character."""
    cov = _coverage()
    seen = set()
    stages = [None, "preheat", "soak", "reflow", "cool"]
    for stage in stages:
        for temp, target in ((25.0, 25.0), (154.0, 155.8), (99.5, 101.0),
                             (236.5, 235.0), (-5.0, 0.0), (None, None)):
            for tal in (None, 0, 1, 42, 140):
                for relay in (True, False):
                    for cmd in L.running(temp, target, 300, 188, stage, tal,
                                         217, 0.5, relay):
                        if cmd[0] == "text":
                            seen.add((str(cmd[3]), cmd[5]))
    for text, font in sorted(seen):
        if font not in cov:
            continue
        missing = sorted(set(text) - set(cov[font]))
        assert not missing, "%r needs %r, absent from %s" % (
            text, "".join(missing), font.rsplit("/", 1)[-1])


def test_no_screen_ever_emits_an_empty_string():
    """adafruit_display_text raises TypeError out of _place_text on an empty
    string -- the same signature a missing glyph produces, which made it look
    like a font problem. Blank fields use a space.

    The first version of this test checked a couple of hand-picked variants
    and missed stage=None, which is what a run passes through before its
    first stage is known. It now sweeps the same space the glyph test does.
    """
    offenders = []
    for stage in (None, "", "preheat", "soak", "reflow", "cool"):
        for tal in (None, 0, 42):
            for temp, target in ((None, None), (25.0, 25.0), (230.0, 232.0)):
                for cmd in L.running(temp, target, 100, 300, stage, tal,
                                     217, 0.4, True):
                    if cmd[0] == "text" and str(cmd[3]) == "":
                        offenders.append("running(stage=%r,tal=%r)" % (stage, tal))
    for name, build in SCREENS.items():
        for cmd in build():
            if cmd[0] == "text" and str(cmd[3]) == "":
                offenders.append(name)
    for tal in (None, 0):
        for cmd in L.running(150.0, 152.0, 200, 288, "soak", tal, 217, 0.5, True):
            if cmd[0] == "text" and str(cmd[3]) == "":
                offenders.append("running(tal=%r)" % tal)
    for rate in (None, -0.4):
        for cmd in L.open_the_door(120.0, rate):
            if cmd[0] == "text" and str(cmd[3]) == "":
                offenders.append("open_the_door(rate=%r)" % rate)
    assert not offenders, "empty strings on: %s" % sorted(set(offenders))


def test_the_live_readout_is_not_the_largest_face():
    """The live readout stays at 48 px; 64 px is for the splash only.

    Glyph tiles are allocations, and the heap during a run has ~22 kB free
    with no contiguous hole above ~900 bytes (measured, not estimated). The
    larger face buys nothing at that cost -- "234 °C" is 153 px wide at 48 px
    against 205 at 64, and both read across a bench."""
    assert T.FONT_READOUT.endswith("48.pcf")
    assert T.FONT_READOUT_XL.endswith("64.pcf")
    live = {c[5] for c in L.running(230.0, 232.0, 300, 188, "reflow", 45,
                                    217, 0.5, True) if c[0] == "text"}
    assert T.FONT_READOUT_XL not in live, \
        "the largest face must not appear on a screen that updates"
    for cmds in (L.open_the_door(180.0, -2.0),
                 L.fault("x"),
                 L.report([("peak", 1, True, "ok")], 1, 1)):
        assert T.FONT_READOUT_XL not in {c[5] for c in cmds if c[0] == "text"}


def test_the_error_describer_never_raises():
    """A diagnostic that can fail destroys the information it exists to
    provide. This one read cmd[5] as a font path, which is true for text
    commands and false for every other kind -- on a plot it is a float, so
    reporting an error raised AttributeError, escaped the per-element catch
    and took down the entire screen."""
    _describe = L.describe_command
    samples = [
        ("text", 1, 2, "hello", 0xFFFFFF, "/assets/fonts/B612-12s.pcf"),
        ("plot", 6, 100, 278, 82, 480.0, 0.0, 250.0, [], 217),
        ("rect", 1, 2, 3, 4, 0xFFFFFF, True),
        ("bitmap", 0, 0, "/assets/taeron-logo-320.bmp"),
        ("touch", 1, 2, 3, 4, "start"),
        ("text",), (), ("weird", None), ("text", 1, 2, 3, 4, 5.0),
    ]
    for cmd in samples:
        out = _describe(cmd)
        assert isinstance(out, str) and out


def test_no_layout_asks_for_a_large_contiguous_allocation():
    """Every rect must fit in a hole a fragmented heap can still offer.

    adafruit_display_shapes.Rect allocates width x height at one bit per
    pixel whether it is filled or an outline. Measured mid-run, the heap has
    around 22 kB free but no contiguous block above ~900 bytes, so anything
    above that will fail -- and it failed on the fault screen, whose
    full-screen border wanted 9600 bytes in one piece. 900 bytes is 7200
    pixels; this holds every layout under that.
    """
    limit_px = 7200
    offenders = []
    for name in sorted(SCREENS):
        for cmd in SCREENS[name]():
            if cmd[0] != "rect":
                continue
            _, _x, _y, w, h, _colour, _filled = cmd
            if w * h > limit_px:
                offenders.append("%s: %dx%d = %d px (%d bytes)"
                                 % (name, w, h, w * h, w * h // 8))
    assert not offenders, "oversized rects: %s" % offenders


def test_a_value_is_never_split_from_its_unit():
    """"120.06" on one line and "°C" on the next defeats the point.

    Temperatures are written with the unit spelled out so a number on screen
    is never ambiguous; wrapping them apart puts the ambiguity back, and the
    fault screen is where it would happen, because that is the only place
    that wraps.
    """
    message = "sensor reading not changing: 120.06 °C for 31 s during a run"
    lines = L.wrap(message, T.FONT_BODY, 296, max_lines=3)
    for i, line in enumerate(lines[:-1]):
        assert not lines[i + 1].startswith("°"), (
            "line %d ends %r and the next begins with a unit: %r"
            % (i, line, lines[i + 1]))
    joined = " ".join(lines)
    assert "120.06 °C" in joined


def test_the_running_screen_can_show_the_door_prompt():
    """An event on the serial console is invisible at the oven.

    The person who has to open the door is standing in front of the screen,
    not reading a console, and they have about a minute in which opening it
    still changes the outcome.
    """
    kw = dict(history=[(0.0, 25.0), (100.0, 150.0)],
              profile_points=[[0, 25], [240, 165], [300, 95]],
              duration_s=300.0)
    quiet = L.running(150.0, 150.0, 150.0, 150.0, "reflow", 0.0, 137, 0.5,
                      True, **kw)
    loud = L.running(150.0, 150.0, 150.0, 150.0, "reflow", 0.0, 137, 0.5,
                     True, open_the_door=True, **kw)
    texts = [c[3] for c in loud if c[0] == "text"]
    assert "OPEN" in texts and "THE DOOR" in texts
    assert "THE DOOR" not in [c[3] for c in quiet if c[0] == "text"]
    # The banner replaces the chart rather than covering it, so the loud
    # screen is the SHORTER of the two. It used to be the longer one, and
    # on the real panel the axis labels came through the banner.
    assert len(loud) < len(quiet)
    assert not [c for c in loud if c[0] == "plot"]
    assert [c for c in quiet if c[0] == "plot"]

def test_the_door_prompt_is_drawn_in_the_alarm_colour():
    banner = [c for c in L.open_the_door(160.0, -0.3, -0.9)
              if c[0] == "text" and c[3] in ("OPEN", "THE DOOR")]
    assert len(banner) == 2
    assert all(c[4] == T.DANGER for c in banner), (
        "the cooldown screen used to draw this in COOL blue while the "
        "running screen drew it in red, which read as two requests")

def test_the_idle_screen_says_where_to_point_a_browser():
    """The address is not knowable from anywhere else. It comes from
    whatever DHCP server the oven meets, and on a network that does not
    carry broadcast nothing can discover the oven by asking for it -- so
    the screen is the only place an operator can read it.
    """
    drawn = [c[3] for c in L.home(24.5, "SAC305", True, address="10.20.10.242")
             if c[0] == "text"]
    assert "http://10.20.10.242" in drawn


def test_the_idle_screen_is_honest_when_there_is_no_network():
    drawn = [c[3] for c in L.home(24.5, "SAC305", True) if c[0] == "text"]
    assert "no network" in drawn
    assert not any("http" in t for t in drawn)


def test_the_address_is_written_out_for_someone_who_is_not_an_engineer():
    assert L.web_address("10.20.10.242") == "http://10.20.10.242"
    assert L.web_address(None) == "no network"
    assert L.web_address("") == "no network"


def test_no_touch_target_reaches_the_bottom_of_the_panel():
    """DONE sat at y=186 and reached 234 on a 240-pixel screen. It would
    not take a press -- twice, from someone standing at the oven -- while
    START at y=176 took every time. The bottom of this panel does not
    read, so nothing may be put there."""
    DEAD_BAND = 16
    for name in SCREENS:
        for cmd in SCREENS[name]():
            if cmd[0] != "touch":
                continue
            bottom = cmd[2] + cmd[4]
            assert bottom <= T.SCREEN_H - DEAD_BAND, (
                "%s: %r reaches y=%d, inside the %d px at the bottom that "
                "does not respond" % (name, cmd[5], bottom, DEAD_BAND))


def test_the_door_banner_does_not_share_the_screen_with_the_chart():
    """It used to be painted over the top of it. On the real screen the
    axis labels and the trace came through, because the renderer adds
    every label after every shape -- a background rect cannot cover text
    however the command list is ordered. Photographed at the oven."""
    door = L.running(156.0, 108.0, 288, -11, "cool", 77, 138, 0.0, False,
                     history=[(i * 4.0, 25 + i * 2.0) for i in range(40)],
                     profile_points=[(0, 25), (210, 138), (240, 165)],
                     duration_s=300, open_the_door=True)
    assert not [c for c in door if c[0] == "plot"], "chart still drawn"
    labels = [c[3] for c in door if c[0] == "text"]
    for axis in ("250", "150", "50", "liq"):
        assert axis not in labels, "%s label survives behind the banner" % axis
    assert "OPEN" in labels and "THE DOOR" in labels


def test_the_door_is_asked_for_once_in_one_form():
    """It was asked for twice, in two visual languages: a small red line on
    the running screen, then a huge blue OPEN / THE DOOR nineteen seconds
    later when the state changed. The operator read them as two separate
    requests and acted on the louder, later one.

    Measured cost on NC191LTA10: banner at 280.6 s, cooldown screen at
    299.3 s, door opened around 306 s. Twenty-six seconds above liquidus at
    -0.4 C/s -- the whole of a 97 s TAL against a 90 s ceiling.
    """
    running = L.running(160.0, 150.0, 280, 20, "cool", 60, 137, 0.0, False,
                        history=[(0, 25)], profile_points=[(0, 25), (300, 95)],
                        duration_s=300, open_the_door=True)
    cooling = L.open_the_door(160.0, -0.3, -0.9)

    def words(cmds):
        return [(c[3], c[4], c[5]) for c in cmds
                if c[0] == "text" and c[3] in ("OPEN", "THE DOOR")]

    a, b = words(running), words(cooling)
    assert a and b, "one of the two screens no longer asks"
    assert a == b, ("the two screens ask differently: %r vs %r -- same "
                    "words, same colour, same font, or it reads as two "
                    "instructions" % (a, b))


def test_the_door_gets_a_countdown_before_it_is_needed():
    """Asking with no notice is what cost NC191LTA10 its window: the
    request went up while the operator was across the room, and the 26 s
    it took to reach the oven was the whole overrun."""
    kw = dict(history=[(0, 25)], profile_points=[(0, 25), (300, 95)],
              duration_s=300)
    early = L.running(160.0, 150.0, 280, 20, "reflow", 40, 137, 0.0, False,
                      door_in_s=18.0, **kw)
    texts = [c[3] for c in early if c[0] == "text"]
    assert "OPEN" in texts and "THE DOOR" in texts
    assert "in 18 s" in texts


def test_the_countdown_is_the_same_instruction_not_a_second_one():
    """The words are up and unchanging from the countdown through to the
    moment itself. Only the line underneath moves."""
    kw = dict(history=[(0, 25)], profile_points=[(0, 25), (300, 95)],
              duration_s=300)

    def words(cmds):
        return [(c[3], c[4], c[5]) for c in cmds
                if c[0] == "text" and c[3] in ("OPEN", "THE DOOR")]

    counting = L.running(160.0, 150.0, 280, 20, "reflow", 40, 137, 0.0, False,
                         door_in_s=6.0, **kw)
    now = L.running(160.0, 150.0, 280, 20, "reflow", 40, 137, 0.0, False,
                    open_the_door=True, **kw)
    assert words(counting) == words(now), "the instruction changes at zero"
    assert "in 6 s" in [c[3] for c in counting if c[0] == "text"]
    assert "now" in [c[3] for c in now if c[0] == "text"]


def test_a_distant_door_does_not_take_over_the_screen():
    """The chart is worth having until the door is nearly due."""
    kw = dict(history=[(0, 25)], profile_points=[(0, 25), (300, 95)],
              duration_s=300)
    far = L.running(160.0, 150.0, 280, 20, "reflow", 40, 137, 0.0, False,
                    door_in_s=90.0, **kw)
    assert [c for c in far if c[0] == "plot"], "chart hidden far too early"
    assert "THE DOOR" not in [c[3] for c in far if c[0] == "text"]


def test_the_idle_screen_says_what_the_radio_is_doing():
    """That line used to be the only thing anyone had, and it said "no
    network" for the whole of a bring-up that looked like a hang."""
    assert L.web_address(None, "joining Voxelis") == "joining Voxelis"
    assert L.web_address(None, "setting the clock") == "setting the clock"
    # An address, once there is one, beats any status.
    assert L.web_address("10.20.10.242", "joining") == "http://10.20.10.242"
    # And nothing at all is still the honest answer.
    assert L.web_address(None, None) == "no network"


def test_the_status_reaches_the_idle_screen():
    """L.home takes it as a keyword with a default, so forgetting to pass
    it renders "no network" throughout a perfectly good bring-up and
    nothing anywhere fails -- the same shape of silent breakage that
    address= and open_the_door= both had."""
    screen = L.home(24.0, "TS391SNL", True, address=None,
                    net_status="looking for a network")
    texts = [c[3] for c in screen if c[0] == "text"]
    assert "looking for a network" in texts

    up = L.home(24.0, "TS391SNL", True, address="10.20.10.242",
                net_status="looking for a network")
    assert "http://10.20.10.242" in [c[3] for c in up if c[0] == "text"]


def test_the_idle_screen_still_takes_a_start_press_during_a_bring_up():
    """The reason there is no abort button. Nothing about the radio coming
    up stops someone using the oven, so there is nothing to abort."""
    screen = L.home(24.0, "TS391SNL", True, address=None,
                    net_status="joining Voxelis")
    assert L.hit(screen, 40, L.BUTTON_ROW_Y + 10) == "start"


def test_the_chart_does_not_copy_its_series_every_frame():
    """The running screen is composed four times a second for the whole of
    a run. Copying the history list each time -- up to 150 points, the
    largest single allocation the screen makes -- is 60,000 allocations in
    a four-hour bake, and run 0009 logged 3256 MemoryErrors composing a
    screen on a heap that had plenty free and no hole the right size.

    Identity, not equality: equality would pass on a copy.
    """
    history = [(0.0, 25.0), (10.0, 60.0), (20.0, 120.0)]
    points = [[0, 25], [100, 200], [200, 150]]
    screen = L.running(120.0, 118.0, 20.0, 180.0, "soak", 0.0, 217.0,
                       0.5, True, history=history, profile_points=points,
                       duration_s=200.0)
    plots = [c for c in screen if c[0] == "plot"]
    assert plots, "the running screen has no chart"
    series = plots[0][8]
    assert any(pts is points for _, pts in series), \
        "the profile curve is copied on every frame"
    assert any(pts is history for _, pts in series), \
        "the measured trace is copied on every frame"


def test_a_switched_off_feature_is_not_painted_as_a_failure():
    """Run logging is off whenever a programming cable owns the filesystem.
    That is a choice somebody made, not a fault, and a red FAIL beside it on
    a healthy oven is how a power-on screen teaches people to ignore it."""
    screen = L.self_test([("thermocouple", True),
                          ("run logging", "HOST"),
                          ("profiles", False)])
    labels = {}
    for c in screen:
        if c[0] == "text":
            labels[c[3]] = c[4]
    assert labels["OK"] == T.BRAND
    assert labels["FAIL"] == T.DANGER
    assert "HOST" in labels
    assert labels["HOST"] == T.CAUTION
    assert labels["HOST"] not in (T.DANGER, T.BRAND)
