Taeron-Systems-Inc/BespokeToast/tests/test_safety.py

"""The supervisor is the only thing that may permit heat, so these are the
tests that matter most. Every fault is injected the way the hardware would
actually produce it, and each one must both deny heat and stay denied."""

import pytest

from oven import hal
from oven.hal import Reading
from oven.safety import (Supervisor, Limits, FAULT_OVER_TEMP, FAULT_RATE,
                         FAULT_SENSOR, FAULT_SENSOR_STALE,
                         FAULT_SENSOR_FROZEN, FAULT_STALL, FAULT_ENCLOSURE,
                         FAULT_RUN_TIMEOUT, FAULT_IMPLAUSIBLE_START,
                         FAULT_CPU_HOT)


@pytest.fixture
def sup():
    s = Supervisor(Limits())
    s.begin_run(0.0)
    return s


def run(sup, temps, relay_on=True, step=0.25, start=0.0, cold=25.0):
    """Feed a series of temperatures at a fixed cadence."""
    t = start
    last = None
    for temp in temps:
        t += step
        last = sup.update(t, Reading(temp, cold=cold), relay_on)
    return last


# -- the baseline: a healthy run is not interfered with ---------------------

def test_a_normal_heating_run_never_trips(sup):
    temps = [25 + i * 0.2 for i in range(400)]     # 0.8 C/s, unremarkable
    assert run(sup, temps) is None
    assert sup.allow_heat()


def test_heat_is_permitted_before_anything_happens():
    assert Supervisor().allow_heat()


# -- over temperature -------------------------------------------------------

def test_absolute_ceiling_trips(sup):
    # climb at a rate the oven could actually produce, straight through it
    f = run(sup, [240 + i * 1.0 for i in range(25)], step=1.0)
    assert f.code == FAULT_OVER_TEMP
    assert not sup.allow_heat()


def test_ceiling_is_inclusive(sup):
    assert run(sup, [255.0, 257.0, 259.9], step=1.0) is None
    assert run(sup, [260.0], step=1.0, start=3.0).code == FAULT_OVER_TEMP


# -- the failure direction that actually hurts ------------------------------

def test_thermocouple_open_circuit_denies_heat(sup):
    f = sup.update(1.0, Reading(25.0, faults=hal.FAULT_OPEN_CIRCUIT), True)
    assert f.code == FAULT_SENSOR
    assert not sup.allow_heat()
    assert "open circuit" in f.message


def test_bus_failure_denies_heat(sup):
    f = sup.update(1.0, Reading(None, faults=hal.FAULT_BUS), True)
    assert not sup.allow_heat()


def test_a_reading_of_none_denies_heat(sup):
    f = sup.update(1.0, None, True)
    assert f is None, "one missed reading must not end the run"
    assert not sup.allow_heat()


# -- missed readings: tolerated, never heated through, and bounded ----------

def test_a_single_missed_reading_does_not_latch(sup):
    run(sup, [100.0 + i * 0.2 for i in range(8)], step=0.25)
    assert sup.update(2.25, Reading(None, faults=hal.FAULT_BUS), True) is None
    assert not sup.allow_heat()
    assert sup.update(2.5, Reading(101.8), False) is None
    assert sup.allow_heat(), "heat should return with the reading"
    assert not sup.tripped


def test_an_out_of_range_reading_is_a_miss_not_a_trip(sup):
    assert sup.update(1.0, Reading(-30.0, faults=hal.FAULT_RANGE), True) is None
    assert not sup.allow_heat()


def test_a_hot_reading_flagged_out_of_range_is_over_temperature(sup):
    f = sup.update(1.0, Reading(450.0, faults=hal.FAULT_RANGE), True)
    assert f is not None and f.code == FAULT_OVER_TEMP
    assert not sup.allow_heat()


def test_a_definite_probe_fault_still_trips_at_once(sup):
    f = sup.update(1.0, Reading(None, faults=hal.FAULT_BUS
                                | hal.FAULT_SHORT_CIRCUIT), True)
    assert f.code == FAULT_SENSOR


# -- the MCP9601's status register ------------------------------------------

def test_a_clear_mcp9601_status_is_no_fault():
    # Burst complete, temperature updated, all four alerts: none is a probe
    # fault.
    assert hal.mcp9601_status_faults(0b11001111) == hal.FAULT_NONE


@pytest.mark.parametrize("status, fault, name", [
    (1 << 4, hal.FAULT_OPEN_CIRCUIT, "open circuit"),
    (1 << 5, hal.FAULT_SHORT_CIRCUIT, "short circuit"),
])
def test_an_mcp9601_probe_fault_trips_at_once(sup, status, fault, name):
    faults = hal.mcp9601_status_faults(status)
    assert faults == fault
    f = sup.update(1.0, Reading(25.0, faults=faults), True)
    assert f.code == FAULT_SENSOR
    assert name in f.message
    assert not sup.allow_heat()


def test_an_open_and_shorted_probe_reports_both():
    assert hal.mcp9601_status_faults(0b00110000) == (
        hal.FAULT_OPEN_CIRCUIT | hal.FAULT_SHORT_CIRCUIT)


def test_too_many_misses_in_a_row_trips(sup):
    lim = sup.limits
    t = 0.0
    for _ in range(lim.max_consecutive_misses):
        t += 0.25
        assert sup.update(t, None, False) is None
    f = sup.update(t + 0.25, None, False)
    assert f.code == FAULT_SENSOR_STALE
    assert "in a row" in f.message
    assert not sup.allow_heat()


def test_a_sensor_that_misses_every_other_step_trips(sup):
    """Never two misses in a row, so only the window budget can catch it.
    Heat gets in between the misses, so this must not go on indefinitely."""
    t, f = 0.0, None
    for i in range(200):
        t += 0.25
        reading = None if i % 2 else Reading(100.0 + i * 0.05)
        f = sup.update(t, reading, reading is not None)
        if f is not None:
            break
    assert f is not None and f.code == FAULT_SENSOR_STALE
    assert t < 10.0, "took %.1f s to give up on a failing sensor" % t


def test_occasional_misses_spread_over_a_long_run_never_trip(sup):
    t = 0.0
    for i in range(4 * 600):                        # ten minutes at 4 Hz
        t += 0.25
        reading = None if i % 40 == 39 else Reading(25.0 + i * 0.05)
        assert sup.update(t, reading, reading is not None) is None


def test_misses_cannot_keep_resetting_the_stall_guard(sup):
    """The dangerous case for tolerating misses. A probe that has fallen out
    of the oven reads a slowly drifting room temperature, so the controller
    asks for full heat for ever. Each miss opens the relay for one step. If
    that reset the stall window, misses coming more often than the window --
    one every 10 s is inside the miss budget -- would mean the guard never
    completes, and the element would heat without bound."""
    lim = sup.limits
    every = int(lim.stall_window_s * 4 * 2 / 3)     # 10 s at the defaults
    assert every < lim.stall_window_s * 4, "misses must beat the window"
    t, f, relay, misses = 0.0, None, True, 0
    for i in range(4 * 300):
        t += 0.25
        if i % every == every - 1:
            misses += 1
            f = sup.update(t, None, relay)
            relay = False                           # forced open by the miss
        else:
            f = sup.update(t, Reading(25.0 + i * 0.0005), relay)
            relay = True
        if f is not None:
            break
    assert f is not None and f.code == FAULT_STALL
    assert misses >= 1, "no miss landed inside the window; not a test"
    assert t <= lim.stall_window_s + 1.0, (
        "%.1f s of heat before the stall guard caught it" % t)


def test_a_probe_that_has_fallen_out_is_caught_within_the_stall_window(sup):
    """Room temperature, flickering by one sensor step as a real probe does,
    with the relay closed throughout. The flicker is what keeps the frozen
    guard from seeing it, so the stall guard has to, and the threshold has
    to be clear of the flicker or each window would pass on noise."""
    lim = sup.limits
    t, f = 0.0, None
    for i in range(4 * 120):
        t += 0.25
        f = sup.update(t, Reading(24.0 + 0.0625 * ((i // 3) % 3 - 1)), True)
        if f is not None:
            break
    assert f is not None and f.code == FAULT_STALL
    assert t <= lim.stall_window_s + 0.5


def _measured_runs():
    """(name, [(t, temp, relay_on)]) for every run recorded with the relay
    state: the 4 Hz console capture the supervisor's cadence matches, the
    oven's own run logs, and the two step tests."""
    import glob
    import os
    import re
    root = os.path.join(os.path.dirname(__file__), "..", "data")
    out = []
    rows = []
    with open(os.path.join(root, "plant-id",
                           "run-ident-2026-09-11-console-4hz.txt")) as fh:
        for line in fh:
            p = line.strip().split(",")
            if len(p) == 8 and re.match(r"^\d+\.\d+$", p[0]):
                try:
                    rows.append((float(p[0]), float(p[2]), p[5] == "1"))
                except ValueError:
                    pass
    out.append(("console-4hz", rows))
    paths = (glob.glob(os.path.join(root, "*run-00*.csv"))
             + glob.glob(os.path.join(root, "e2-step-test*.csv")))
    for path in sorted(paths):
        rows = []
        with open(path) as fh:
            lines = [l for l in fh if l.strip() and not l.startswith("#")]
        head = lines[0].strip().split(",")
        for line in lines[1:]:
            d = dict(zip(head, line.strip().split(",")))
            if "actual_c" in d:
                rows.append((float(d["elapsed_s"]), float(d["actual_c"]),
                             d["relay"] == "1"))
            elif d.get("t_s") and d.get("hot_c"):
                rows.append((float(d["t_s"]), float(d["hot_c"]),
                             d["stage"] == "E2H"))
        out.append((os.path.basename(path), rows))
    return out


def test_the_stall_and_frozen_guards_pass_every_measured_run():
    """These two limits are as short as this oven allows: heat takes up to
    10 s to reach the probe at all. Shortening either one further must
    first survive what the oven actually did."""
    runs = _measured_runs()
    assert len(runs) >= 10 and all(len(r) > 100 for _, r in runs)
    for name, rows in runs:
        # Only the two guards under test: the logs are not all at the
        # control cadence, and nothing here is about rate or run length.
        sup = Supervisor(Limits(max_rate_c_per_s=1e6, sensor_stale_s=1e6,
                                max_run_s=1e9))
        for t, temp, relay in rows:
            f = sup.update(t, Reading(temp), relay)
            assert f is None, "%s at %.1f s: %s" % (name, t, f.message)


def test_a_miss_after_a_long_gap_still_counts_as_a_gap(sup):
    sup.update(1.0, Reading(100.0), False)
    f = sup.update(20.0, None, False)
    assert f.code == FAULT_SENSOR_STALE
    assert "without a check" in f.message


def test_acknowledging_clears_the_miss_history(sup):
    for i in range(sup.limits.max_consecutive_misses + 1):
        sup.update(0.25 * (i + 1), None, False)
    assert sup.tripped
    sup.acknowledge()
    assert sup.allow_heat()
    assert sup.update(5.0, None, False) is None


def test_a_sensor_reading_low_is_caught_by_the_stall_guard(sup):
    """The dangerous case: a probe that reads cold makes the controller ask
    for more heat. Nothing about the number itself looks wrong, so the guard
    that has to catch it is 'heat in, nothing out'."""
    f = run(sup, [30.0] * 500, relay_on=True)
    assert f is not None
    assert f.code in (FAULT_STALL, FAULT_SENSOR_FROZEN)
    assert not sup.allow_heat()


def test_frozen_reading_while_heating_trips(sup):
    f = run(sup, [42.0] * 200, relay_on=True)
    assert f.code in (FAULT_SENSOR_FROZEN, FAULT_STALL)


def test_a_steady_reading_with_the_relay_off_is_fine(sup):
    assert run(sup, [42.0] * 500, relay_on=False) is None
    assert sup.allow_heat()


# -- rate of rise -----------------------------------------------------------

def test_implausible_rate_trips(sup):
    f = run(sup, [25, 30, 90], step=1.0)          # 60 C in one second
    assert f.code == FAULT_RATE


def test_a_brisk_but_real_ramp_does_not_trip(sup):
    f = run(sup, [25 + i * 2.0 for i in range(50)], step=1.0)   # 2 C/s
    assert f is None


# -- stall ------------------------------------------------------------------

def test_heating_with_no_rise_trips(sup):
    f = run(sup, [50.0 + i * 0.001 for i in range(600)], relay_on=True)
    assert f.code in (FAULT_STALL, FAULT_SENSOR_FROZEN)


def test_stall_window_resets_when_the_oven_does_rise(sup):
    # Rises a little more than the minimum every stall window, for six
    # windows: never a stall.
    lim = sup.limits
    steps = int(lim.stall_window_s * 4)
    per_step = lim.stall_min_rise_c * 1.2 / steps
    temps = [50.0 + i * per_step for i in range(6 * steps)]
    assert run(sup, temps, relay_on=True) is None


def test_slower_than_the_minimum_rise_is_a_stall(sup):
    lim = sup.limits
    steps = int(lim.stall_window_s * 4)
    per_step = lim.stall_min_rise_c * 0.8 / steps
    f = run(sup, [50.0 + i * per_step for i in range(2 * steps)],
            relay_on=True)
    assert f is not None and f.code == FAULT_STALL


# -- enclosure --------------------------------------------------------------

def test_hot_enclosure_trips(sup):
    f = sup.update(1.0, Reading(120.0, cold=75.0), True)
    assert f.code == FAULT_ENCLOSURE
    assert "enclosure" in f.message


def test_warm_enclosure_is_tolerated(sup):
    """Back-to-back runs leave the box in the fifties and sixties; that is
    normal use, not a fault."""
    assert sup.update(1.0, Reading(120.0, cold=45.0), True) is None
    assert sup.update(1.5, Reading(120.0, cold=62.0), True) is None


def test_absent_enclosure_reading_does_not_trip(sup):
    assert sup.update(1.0, Reading(120.0, cold=None), True) is None


# -- watchdog-ish: gaps in supervision --------------------------------------

def test_a_long_gap_while_heating_trips(sup):
    sup.update(1.0, Reading(100.0), True)
    f = sup.update(20.0, Reading(105.0), True)     # 19 s unwatched, relay on
    assert f.code == FAULT_SENSOR_STALE


def test_a_long_gap_with_the_relay_off_still_trips_inside_a_run(sup):
    """This originally asserted the opposite. The rule was 'a gap only
    matters while heating', which misses that a gap during a run advances the
    profile clock unsupervised whatever the relay was doing."""
    sup.update(1.0, Reading(100.0), False)
    assert sup.update(20.0, Reading(99.0), False).code == FAULT_SENSOR_STALE


# -- run duration -----------------------------------------------------------

def test_run_timeout_trips(sup):
    f = sup.update(3601.0, Reading(100.0), True)
    assert f.code == FAULT_RUN_TIMEOUT


# -- latching ---------------------------------------------------------------

def test_a_fault_latches_even_once_conditions_are_good_again(sup):
    run(sup, [240 + i * 1.0 for i in range(25)], step=1.0)
    assert not sup.allow_heat()
    for _ in range(100):
        sup.update(999.0, Reading(25.0), False)    # perfectly healthy now
    assert not sup.allow_heat(), "fault cleared itself"


def test_the_first_cause_is_kept_not_the_last(sup):
    run(sup, [240 + i * 1.0 for i in range(25)], step=1.0)   # over temp
    first = sup.fault
    sup.update(500.0, Reading(None), True)         # then a sensor failure
    assert sup.fault is first
    assert sup.fault.code == FAULT_OVER_TEMP


def test_acknowledgement_clears_it(sup):
    run(sup, [240 + i * 1.0 for i in range(25)], step=1.0)
    sup.acknowledge()
    assert sup.allow_heat()


def test_acknowledgement_does_not_resurrect_stale_history(sup):
    run(sup, [25 + i for i in range(50)], step=1.0)
    sup.acknowledge()
    # a big jump straight after ack must not be read as a huge rate
    assert sup.update(1000.0, Reading(200.0), True) is None


# -- pre-flight -------------------------------------------------------------

def test_start_refused_when_the_oven_is_still_hot():
    s = Supervisor()
    f = s.check_start(Reading(84.0))
    assert f.code == FAULT_IMPLAUSIBLE_START
    assert "84.0" in f.message


def test_start_refused_with_a_faulty_probe():
    s = Supervisor()
    assert s.check_start(
        Reading(25.0, faults=hal.FAULT_OPEN_CIRCUIT)).code == FAULT_SENSOR


def test_start_refused_with_no_reading():
    assert Supervisor().check_start(None).code == FAULT_SENSOR_STALE


def test_start_allowed_from_ambient():
    assert Supervisor().check_start(Reading(22.0)) is None


def test_refusing_to_start_does_not_latch():
    s = Supervisor()
    s.check_start(Reading(84.0))
    assert s.allow_heat(), "a refused start should not need acknowledgement"


def test_a_sustained_impossible_rise_trips_the_rate_guard(sup):
    """A rise the oven cannot physically produce, held long enough to be
    real, must trip."""
    f = run(sup, [100.0 + i * 2.5 for i in range(40)], step=0.25)
    assert f.code == FAULT_RATE
    assert not sup.allow_heat()


def test_a_single_noisy_sample_does_not_trip_the_rate_guard(sup):
    """Measured on hardware: at 4 Hz on a probe quantised to 0.0625 C,
    neighbour-to-neighbour rates of 7-11 C/s show up in ordinary data on an
    oven whose real maximum is 1.85 C/s. Judging rate between adjacent
    samples faulted a healthy run mid-profile. The guard now measures across
    a window, where the same data peaks at 1.79 C/s."""
    temps = [100.0 + i * 0.2 for i in range(40)]
    temps[20] += 2.0                    # one spike, gone by the next sample
    assert run(sup, temps, step=0.25) is None
    assert sup.allow_heat()


def test_a_warm_start_is_allowed():
    """A tool in use gets started warm -- back-to-back boards, or a run begun
    soon after the last one. Refusing at 35 °C would make that impossible."""
    s = Supervisor()
    assert s.check_start(Reading(35.0)) is None
    assert s.check_start(Reading(50.0)) is None


def test_the_enclosure_limit_reflects_the_electronics_not_the_plastic():
    """The printed parts sit away from the oven on thermally protected
    wiring, so softening is not the constraint. The TFT is, at about 70 °C.
    At 60 °C the oven could not run twice in a row: the enclosure rises about
    21 °C per run and peaks after it finishes."""
    assert Limits().max_enclosure_c == 70.0
    s = Supervisor()
    s.begin_run(0.0)
    assert s.update(1.0, Reading(150.0, cold=65.0), True) is None
    s2 = Supervisor()
    s2.begin_run(0.0)
    assert s2.update(1.0, Reading(150.0, cold=71.0), True).code == FAULT_ENCLOSURE


def test_a_hot_controller_die_trips(sup):
    """The SAMD51 is rated to 85 °C. Measured across a full run its die does
    not move at all -- the MCP9600's cold junction rises 12-15 °C while this
    stays flat -- so reaching 80 °C would mean something unlike any run so
    far."""
    f = sup.update(1.0, Reading(150.0, cold=45.0, cpu=82.0), True)
    assert f.code == FAULT_CPU_HOT
    assert "controller" in f.message


def test_a_normal_controller_die_does_not_trip(sup):
    assert sup.update(1.0, Reading(150.0, cold=45.0, cpu=36.0), True) is None


def test_an_absent_die_reading_does_not_trip(sup):
    assert sup.update(1.0, Reading(150.0, cold=45.0, cpu=None), True) is None


def test_a_gap_during_a_run_trips_even_with_the_relay_off(sup):
    """A gap is not harmless just because the relay happened to be off at
    that instant. The profile clock advanced without supervision, so the
    controller would resume against a timeline that no longer describes the
    oven -- and command heat to catch up."""
    sup.update(1.0, Reading(100.0), False)
    f = sup.update(40.0, Reading(100.0), False)
    assert f.code == FAULT_SENSOR_STALE
    assert "during a run" in f.message


def test_a_gap_outside_a_run_is_still_harmless():
    s = Supervisor()                      # begin_run never called
    s.update(1.0, Reading(25.0), False)
    assert s.update(600.0, Reading(25.0), False) is None


def test_the_run_timeout_follows_the_profile_it_was_given():
    """A flat hour was both too slack and, for the MSL bake, impossible.

    The 125 C bake is 15201 s, so under a fixed 3600 s limit it could never
    have completed -- it would have faulted at the one-hour mark every time.
    A short reflow, meanwhile, had an hour to sit stuck.
    """
    from oven.safety import Supervisor, Limits, FAULT_RUN_TIMEOUT
    from oven.hal import Reading

    def trip_time(expected):
        sup = Supervisor(Limits(max_rate_c_per_s=1e6))
        sup.begin_run(0.0, expected_duration_s=expected)
        t = 0.0
        while t < expected * 4 + 8000:
            t += 1.0
            f = sup.update(t, Reading(25.0 + (t % 3), cold=25.0), False)
            if f is not None:
                assert f.code == FAULT_RUN_TIMEOUT, f.message
                return t
        return None

    short = trip_time(360.0)
    long_ = trip_time(15201.0)
    assert short is not None and long_ is not None
    assert short < 1200, "a 6-minute profile should not get an hour"
    assert long_ > 15201, "the bake must be allowed to finish"


def test_cooldown_gets_its_own_clock():
    """Passive cooling outlasts the profile that caused it."""
    from oven.safety import Supervisor, Limits, FAULT_RUN_TIMEOUT
    from oven.hal import Reading
    sup = Supervisor(Limits(max_rate_c_per_s=1e6))
    sup.begin_run(0.0, expected_duration_s=360.0)
    sup.begin_cooldown(360.0)
    t = 360.0
    temp = 224.0
    while t < 360.0 + 1800.0:
        t += 1.0
        temp = max(30.0, temp - 0.11)
        f = sup.update(t, Reading(temp, cold=25.0), False)
        assert f is None, "faulted while cooling: %s" % f.message
