Taeron-Systems-Inc/BespokeToast/tests/test_firmware_contract.py

"""display.py and code.py are never imported by this suite -- they need a
board -- so nothing else here would notice a name disappearing from them.

That is not hypothetical. Moving one function out of display.py cut a span
that also contained _font() and preload(), deleting both. Every test passed,
the deploy reported success, and the firmware died on boot with
"ImportError: cannot import name preload". These checks parse the modules
instead of importing them, so board-only code still gets verified.
"""

import ast
import os

FIRMWARE = os.path.join(os.path.dirname(__file__), "..", "firmware")


def _tree(rel):
    return ast.parse(open(os.path.join(FIRMWARE, rel)).read())


def _defined(tree):
    names = set()
    for node in tree.body:
        if isinstance(node, (ast.FunctionDef, ast.ClassDef)):
            names.add(node.name)
        elif isinstance(node, ast.Assign):
            for t in node.targets:
                if isinstance(t, ast.Name):
                    names.add(t.id)
    return names


def _imported_from(tree, module):
    wanted = set()
    for node in ast.walk(tree):
        if isinstance(node, ast.ImportFrom) and node.module == module:
            wanted.update(a.name for a in node.names)
    return wanted


def _calls_named(node, name):
    return any(isinstance(n, ast.Call) and getattr(n.func, "id", None) == name
               for n in ast.walk(node))


def test_code_py_only_imports_names_that_exist():
    code = _tree("code.py")
    for module, rel in (("oven.ui.display", "oven/ui/display.py"),
                        ("oven.ui.layout", "oven/ui/layout.py"),
                        ("oven.hardware", "oven/hardware.py"),
                        ("oven.app", "oven/app.py"),
                        ("oven.controller", "oven/controller.py"),
                        ("oven.profile", "oven/profile.py"),
                        ("oven.metrics", "oven/metrics.py")):
        wanted = _imported_from(code, module)
        if not wanted:
            continue
        have = _defined(_tree(rel))
        missing = wanted - have
        assert not missing, "code.py imports %s from %s, which does not define it" % (
            sorted(missing), rel)


def test_display_imports_names_that_exist():
    disp = _tree("oven/ui/display.py")
    wanted = _imported_from(disp, ".layout")
    have = _defined(_tree("oven/ui/layout.py"))
    missing = wanted - have
    assert not missing, "display.py imports %s from layout.py" % sorted(missing)


def test_display_still_defines_what_it_is_expected_to():
    """A blunt guard on the module that no test can import."""
    have = _defined(_tree("oven/ui/display.py"))
    for name in ("Display", "preload", "_font"):
        assert name in have, "display.py no longer defines %s" % name


def test_every_firmware_module_parses():
    for base, dirs, names in os.walk(FIRMWARE):
        dirs[:] = [d for d in dirs if d != "__pycache__"]
        for n in names:
            if n.endswith(".py"):
                ast.parse(open(os.path.join(base, n)).read())


def test_code_py_reserves_the_chart_buffer_at_startup():
    """The chart buffer is ~5.9 KB and used to be allocated on the first
    running screen -- after a run had already started, on whatever heap
    remained. A freshly booted device managed it; one that had been working a
    while failed with MemoryError and ran with no chart."""
    src = open(os.path.join(FIRMWARE, "code.py")).read()
    assert "reserve_chart" in src, "code.py must claim the chart buffer at boot"
    main = src[src.index("def main("):]
    reserve = main.index("reserve_chart")
    loop = main.index("while True:")
    assert reserve < loop, "the reservation must happen before the main loop"


def test_the_renderer_does_not_release_the_chart_buffer():
    """Releasing it when a chart-less screen appears means re-allocating on
    the next run, on a heap that has meanwhile fragmented -- which is the
    failure that releasing it was meant to avoid."""
    src = open(os.path.join(FIRMWARE, "oven/ui/display.py")).read()
    rebuild = src[src.index("def _rebuild"):src.index("def _update")]
    assert "self._chart = None" not in rebuild, \
        "_rebuild must not drop the chart buffer"


def _code_py_tree():
    import ast
    import os
    path = os.path.join(os.path.dirname(__file__), "..", "firmware", "code.py")
    return ast.parse(open(path).read())


def _guarded_calls(tree):
    """Names of functions called inside a try that handles MemoryError."""
    import ast
    out = set()
    for node in ast.walk(tree):
        if not isinstance(node, ast.Try):
            continue
        handles_memory = any(
            (isinstance(h.type, ast.Name) and h.type.id == "MemoryError")
            or (isinstance(h.type, ast.Tuple)
                and any(getattr(e, "id", "") == "MemoryError"
                        for e in h.type.elts))
            for h in node.handlers)
        if not handles_memory:
            continue
        for inner in ast.walk(node):
            if isinstance(inner, ast.Call):
                f = inner.func
                out.add(getattr(f, "id", None) or getattr(f, "attr", None))
    return out


def test_the_display_path_cannot_kill_a_run():
    """A run died at 90 C, relay at full duty, on a 256-byte allocation.

    It was history.append in the main loop, and the MemoryError propagated
    out of main(). The relay was driven low on the way out so it failed
    safe, but the oven stopped controlling and stopped answering ABORT.
    Everything that only feeds the screen must be survivable.
    """
    guarded = _guarded_calls(_code_py_tree())
    for name in ("running", "fault", "render", "add", "_emit"):
        assert name in guarded, (
            "%s() is not inside a try that handles MemoryError; a failure "
            "there would stop the firmware mid-run" % name)


def test_the_control_step_is_not_swallowed():
    """app.tick() must NOT be wrapped: a fault there has to surface."""
    guarded = _guarded_calls(_code_py_tree())
    assert "tick" not in guarded, (
        "the control step is inside a MemoryError handler; safety logic "
        "must not be silently skipped")


def _end_log(**names):
    """end_log() lifted out of main() and bound to stand-ins for its closure."""
    import ast
    tree = _code_py_tree()
    fn = next(n for n in ast.walk(tree)
              if isinstance(n, ast.FunctionDef) and n.name == "end_log")
    scope = dict(names)
    exec(compile(ast.Module(body=[fn], type_ignores=[]), "code.py", "exec"),
         scope)
    return scope["end_log"]


def test_a_run_that_ends_before_its_first_sample_closes_its_log():
    """A run that faulted straight after START crashed code.py in end_log.

    Metrics existed but had no sample yet, so peak_c was None and
    "%.1f" % None raised a TypeError out of the main loop. The controller
    stopped with it.
    """
    from oven.metrics import RunMetrics

    class Logs:
        def __init__(self):
            self.ended = []

        def event(self, *args):
            pass

        def end(self, summary):
            self.ended.append(summary)

    class App:
        metrics = RunMetrics(liquidus_c=None)
        profile = None
        elapsed = 0.0

    logs = Logs()
    logging_run = [True]
    end_log = _end_log(app=App(), logs=logs, logging_run=logging_run,
                       MetricLimits=None)
    end_log()
    assert logs.ended == [None]
    assert logging_run == [False]


def test_both_ways_of_starting_a_run_record_it():
    """The touchscreen path is the one most likely to be unattended.

    Logging was once wired into the console START and not into the touch
    handler, so a run begun by pressing START on the oven -- the case the
    log exists for -- would not have been recorded. Two call sites was the
    fix then.

    It is one call site now, and deliberately: the log opens on the
    run_started event, which the state machine emits however the run was
    begun. That also fixed a second bug, because request_start enters
    PREHEAT and the warm-start offset is not known until the transition
    into RUNNING -- opening at the old sites recorded the offset as zero.

    So the invariant is no longer "two calls". It is that the one call
    hangs off the event, and that no start path opens the log itself.
    """
    import ast
    tree = _code_py_tree()
    starts = [n for n in ast.walk(tree)
              if isinstance(n, ast.Call)
              and getattr(n.func, "attr", None) == "request_start"]
    assert len(starts) >= 2, (
        "expected a console and a touchscreen start path, found %d"
        % len(starts))

    opens = [n for n in ast.walk(tree)
             if isinstance(n, ast.Call) and getattr(n.func, "id", None)
             == "begin_log"]
    assert len(opens) == 1, (
        "begin_log is called %d times; it belongs on the run_started event "
        "so that every way of starting a run reaches it once" % len(opens))

    announce = [n for n in ast.walk(tree)
                if isinstance(n, ast.FunctionDef) and n.name == "announce"]
    assert announce, "code.py no longer has an event handler called announce"
    assert _calls_named(announce[0], "begin_log"), (
        "begin_log is not reached from the event handler, so a run started "
        "by touch may go unrecorded")
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
