Taeron-Systems-Inc/BespokeToast/(commit log)

2023-04-16 Delete BespokeToast_Rev-0_v77.brd
    No longer in use
    [BespokeToast_Rev-0_v77.brd]
2023-04-16 Delete BespokeToast_Rev-0_v77.sch
    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
    [BespokeToast_Rev-0_v77.sch]
2026-08-25 Replace contents with a clean record of the oven's current state
    The tree now records the oven as it is: the firmware running on it, the reflow
    profiles it uses, and reference notes on the hardware. The previous contents —
    the 2023 controller, its development, and the vendored Adafruit libraries —
    remain in this repository's history and are unaffected.
    - firmware/ controller and profiles, mirroring the CIRCUITPY volume
    - docs/ hardware reference and firmware description
    - LICENSE / NOTICE.md restore the MIT attribution for the Adafruit-derived
    controller, whose SPDX header had been dropped
    Carried forward from the history rather than left buried: the 2023 coast
    measurement (~2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
    [code.py]
2026-08-25 Preserve the device's CRLF line endings in firmware/code.py
    The file on the oven uses CRLF throughout. Adding the licence header via a
    text-mode rewrite normalised the whole file to LF, so the copy here was not the
    faithful record NOTICE.md describes. Rewritten byte-exact: stripping the header
    now reproduces the device file's md5 exactly.
2026-08-25 Clean sheet: hardware interfaces, profiles, and safety supervision
    Removes the previous controller entirely. What replaces it is split so that
    the parts that decide anything can be tested off the hardware: nothing in
    oven/ imports board except hardware.py, which does not exist yet.
    oven/hal.py the shapes the rest of the code talks to, and Reading,
    which carries sensor fault flags rather than hiding them
    oven/profile.py JSON profiles: load, validate strictly, interpolate.
    Stages are derived from the curve and the liquidus rather
    than stored, because the profile in this repo's history
    declared a melting point that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
    [code.py, hal.py, profile.py, safety.py, test_profile.py, test_safety.py]
2026-08-25 Ground the model in measurement we can defend, not in inherited numbers
    The simulator was fitted to a single 2023 calibration point. Three free
    parameters through one point is not a fit, and tuning against it would have
    laundered a weak number into an authoritative-looking model. Replaced with a
    plant *family* bounded from first principles — what a 1200-1500 W domestic
    oven physically is — and the controller is now required to behave across all
    of it. Transport lag gets the widest bound because the probe's placement in
    this oven is unknown, and it dominates the difficulty.
    Profiles now come from the paste datasheet rather than from the old files.
    MG Chemicals 4900P TDS: SAC305 confirmed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
    [controller.py, metrics.py, profile.py, test_controller.py, test_profile.py]
2026-08-25 Hardware layer, boot safe-state, model fitting, and the rule that enforces both
    oven/hardware.py is the designated single point of contact with the board,
    and test_architecture.py enforces that: every other module in oven/ is parsed
    and rejected if it imports board, digitalio, busio and friends, then imported
    under CPython to prove it. The previous firmware became untestable by exactly
    this drift, one import at a time.
    Sensor faults are reported rather than hidden, with a caveat recorded in the
    module: the MCP9600 lacks the MCP9601's open- and short-circuit detection, so
    a disconnected probe produces a reading rather than an error. That is why the
    supervisor's stall and frozen-value guards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
    [boot.py, fit_model.py, hardware.py, test_architecture.py]
2026-08-25 Replace the guessed plant with measured data from the oven
    E0, E1 and E2 ran on the hardware. Three findings drove this commit.
    The relay FAILS SAFE. Reading D4 back under each internal pull gives
    False/False: an external pulldown dominates, so releasing the pin
    de-energises. Reproduced on three separate runs. Every guard in safety.py
    rested on this and it is now measured.
    The 2023 coast figure was wrong by 28x. Measured: 1.06 C over 3 s, against
    29.6 C over 37 s recorded in the old config. Tuning a predictive cutoff
    against the old number would have stopped heating ~30 C early on every run,
    and the error would have been invisible in simulation because the simulator
    would have been wrong t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
    [e2-step-test-2026-08-25.csv]
2026-08-25 Record measured oven behaviour, replacing the unverified entries
    The relay fail-safe question is answered: an external pulldown holds it
    de-energised whenever D4 is not driven, reproduced on three runs. Two step
    tests give heating and cooling rates across 26-240 C, the coast at both 200
    and 240 C, and the enclosure's thermal rise.
    The 2023 coast figure is kept only as a correction: it is wrong by a factor
    of 28 and nothing should be derived from it.
2026-08-25 A profile this oven can actually run, and the bug that found
    Merging the second step test extends the characterisation to 240 C, which is
    where reflow actually happens: the oven manages 0.75 C/s at 220 C and 0.69 C/s
    at 235 C, against the 1.67-2.07 C/s both existing profiles demand there. It
    reaches 240 C comfortably -- the peak was never the problem, the rate was.
    That is what the undocumented 225->235 C bump in 2024 was chasing, and raising
    the setpoint could not fix a rate limit.
    profiles/sac305-this-oven.json is derived from the measured curves instead:
    rise segments at 80% of measured capability so the controller keeps headroom,
    a slow soak, and a 32 s dwell at peak. The dwell is the c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
    [e2-step-test-240c-2026-08-25.csv]
2026-08-25 Fix a test left asserting the gap the second step test closed
    test_hold_duty_table_is_not_extrapolated_past_its_evidence asserted the
    hold-duty range stopped below the liquidus, which was true when the data
    stopped at 200 C and everything reflow needed was extrapolation. Extending
    the characterisation to 240 C made it false. Inverted: the range must now
    cover the peak, and must still not exceed the step test that produced it.
    [test_measured.py]
2026-08-26 Run state machine and fixed-cadence scheduler
    app.py holds the run lifecycle: idle, preheat, running, cooldown, report,
    fault. Two properties it exists to guarantee.
    The control step fires on a fixed 250 ms grid measured against a monotonic
    clock, scheduled from its own deadline rather than from "now", so a slow
    render makes one step late instead of walking the cadence permanently
    backwards. A long stall resets the grid rather than firing a burst of
    catch-up steps. The previous firmware refreshed the display inside its
    control loop, which is how a redraw became a control-timing problem.
    Nothing reaches the relay without the supervisor agreeing. The controller
    proposes a duty and the superv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
    [app.py, test_app.py]
2026-08-26 Interface, entry point, and the displayio adapter
    Screens are emitted as drawing primitives rather than pushed straight into
    displayio, so layout is testable without a board. What that buys is the
    things that actually go wrong on a small resistive touchscreen: targets too
    small for a fingertip, text running off the edge, the abort button not being
    where a panicking hand reaches. 24 tests cover exactly those, including that
    the fault screen offers precisely one action.
    Type is B612 -- PolarSys/Eclipse, OFL-1.1, drawn for Airbus cockpit displays.
    Subsetted to PCF, the whole interface costs 31 KB of font, and a test guards
    that budget. The accent colour is lifted from the Taeron wordmark, whic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
    [code.py, display.py, layout.py, test_ui.py]
2026-08-26 Deploy tool, and bring the docs in line with the rewrite
    tools/deploy.py syncs firmware/ to CIRCUITPY, verifies every file by digest
    afterwards, and refuses to write while a run is in progress -- auto-reload
    would restart the controller mid-profile.
    docs/firmware.md described a controller this branch has deleted, so it is now
    docs/original-firmware.md and says so. README describes the actual layout and
    the rule that keeps the test suite runnable off-hardware.
2026-08-26 Validate the new firmware on the actual device, without deploying it
    The largest remaining unknown was whether any of this runs on CircuitPython
    8.0.5 at all -- syntax the compiler accepts, imports that resolve, and
    whether it fits in a SAMD51's RAM. None of that is visible from CPython, and
    174 passing tests on a laptop say nothing about it.
    Copied oven/, profiles/ and assets/ to CIRCUITPY but deliberately left
    code.py and boot.py alone, so the board still boots what it always booted,
    then imported and drove everything from the REPL. Reversible by deleting
    three directories, and no heat at any point.
    Everything works. 29 KB to import the lot, 155 KB free with the app and the
    UI loaded, an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
    [onboard_test.py]
2026-08-26 Fixes from the first real run on the oven
    The run itself worked: peak 235.6 C against 237.2 predicted, 99 s above
    liquidus against 94 predicted. The measured-plant model holds up. Three
    things it exposed did not.
    A missing glyph killed the firmware. The 64 px readout font is subsetted to
    digits, because a full charset at that size costs 329 KB to draw ten
    numerals. The cooldown screen drew the word OPEN in it, which does not fall
    back -- it raises TypeError inside adafruit_display_text. So the firmware
    died the instant the run finished, which is why no door prompt appeared. The
    fault screen had the identical bug, meaning the one screen that must survive
    would have crashed instead of warning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
    [code.py, controller.py, display.py, hardware.py, layout.py, profile.py, test_profile.py, test_ui.py]
2026-08-26 Rework the run screen around a chart, and clean up the numbers
    From watching a real run on the bench:
    The run screen is now a chart -- target curve, actual trace, and the liquidus
    as a dashed line -- with abort moved hard into the top-right corner to make
    room. Two numbers say where you are; the shape says whether it is going
    right, which is what an operator is actually watching. The four-stage strip
    is gone because the chart shows progress better than a row of words.
    Temperatures are whole degrees and always carry the sign. A tenth of a degree
    is below what the probe means and below what anyone acts on.
    The cooldown screen shows the actual cooling rate instead of a bare "-- C/s"
    that sig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
    [code.py, display.py, layout.py, metrics.py, test_ui.py]
2026-08-26 Write temperatures with their unit: 234 °C
    A bare degree sign leaves the reader to infer the scale. Every temperature
    and rate on screen now carries it the way anyone would write it by hand.
    The main readout drops from 64 px to 48 px to make room -- six glyphs beside
    the abort target do not fit at 64 -- which is still large enough to read
    across a bench. The 64 px face stays shipped for anywhere a bare number is
    wanted.
    [layout.py, metrics.py, test_ui.py, theme.py]
2026-08-26 Trim the abort target and restore the full-size readout
    Abort was larger than it needed to be. At 94x48 it is still comfortably
    hittable with a fingertip on resistive touch, and shrinking it frees the
    width for "234 °C" at 64 px rather than 48.
    Layout tests now use the fonts' real per-glyph advance widths, extracted
    from the BDF sources into assets/fonts/metrics.json, instead of one estimated
    width per font. Guessing a single width is exactly how the stage strip ended
    up drawn through the target reading, and how the abort label came to overhang
    its own outline by three pixels. Two new checks fall out of having real
    metrics: nothing may run off the right edge, and a button label may not
    ove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
2026-08-26 Bench feedback: false-tripping rate guard, and a UI pass
    The run faulted on "temperature rising too fast: 7.0 C/s exceeds 5.0 C/s".
    That was a false positive and the same bug I had already fixed in the PID and
    failed to carry across: the guard measured rate between adjacent samples. At
    4 Hz on a probe quantised to 0.0625 C, ordinary data shows 7-11 C/s between
    neighbours on an oven whose real maximum is 1.85 C/s. Measured across a 3 s
    window the same data peaks at 1.79 C/s, so the guard now uses a window and a
    4 C/s limit -- which tracks physics with 2.2x headroom instead of measuring
    noise. I could not replay the exact run: I killed the capture before that
    deploy and did not restart it.
    UI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
    [display.py, layout.py, safety.py, test_safety.py, theme.py]
2026-08-26 Stop swallowing failures, reuse the chart buffer, and point the eye somewhere
    The chart vanished intermittently on the bench. It was allocating a fresh
    Bitmap every frame at 4 Hz, which fragments the heap until a contiguous block
    is gone: 728 MemoryErrors in one run, each a frame with no chart. The buffer
    is allocated once and redrawn in place, and rendering is throttled to 2 Hz,
    which is past what anyone reads and halves the churn.
    A full-width rule across the chart draws the eye everywhere and says nothing
    about where it matters. The stretch of the TARGET curve above liquidus is now
    drawn bright and dashed instead -- the part of the run being pointed at --
    and the chart has axes: a temper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
    [app.py, code.py, display.py, layout.py, test_diagnostics.py]
2026-08-26 Tune the PID against the measured plant
    Run 3 lagged the early ramp by up to 15 °C, and only 1% of the samples that
    were behind target had duty saturated -- headroom sitting unused because the
    gains were too soft. They were never tuned; I picked them.
    kp 0.03 -> 0.22, ki 0.0015 -> 0.004, integral clamp 0.5 -> 0.6, swept against
    the measured plant. Mean early-ramp error drops from 5.9 °C to 1.6 °C and
    relay actuations from 58 to 34 in replay. Checked against +/-20% plant error
    and a warm start: every case stays inside the peak and time-above-liquidus
    windows, so the gains do not depend on the model being exactly right.
    [code.py, test_measured.py]
2026-08-26 Set the enclosure limit from the electronics, not the plastic
    The printed parts are separate from the oven and reached by thermally
    protected wiring, so material softening -- which is what 60 °C was reasoned
    from -- is not the constraint. The binding component is the TFT at about
    70 °C operating; the SAMD51 is good to 85 °C and the MCP9600 to 125 °C.
    60 °C also made back-to-back runs impossible. The enclosure rises about 21 °C
    per run and peaks after it finishes, so a second run had to wait for it to
    shed heat. A warm start is normal for a tool in use and now has a test.
    [app.py, safety.py, test_safety.py]
2026-08-26 Fix an enclosure test left asserting the old 60 °C limit
    Committed while failing, which is twice today. The threshold moved to 70 °C
    and the test still fed it 61 °C expecting a trip.
    [test_safety.py]
2026-08-26 Draw the chart incrementally; solid, thicker target curve
    The chart still blinked after the allocation fix. Clearing the whole bitmap
    and redrawing every frame means displayio can refresh while the buffer is
    blank. The target curve is static for a whole run and the measured trace only
    grows, so nothing needs clearing: the chart is drawn incrementally, and a
    full clear happens only when the geometry changes or a series gets shorter,
    which means a new run.
    The target curve is now two pixels thick, and the stretch above liquidus is
    solid red rather than dashed -- a broken line is hardest to follow exactly
    where it matters most.
    [display.py]
2026-08-26 Make deploy refuse while the oven is running
    I said twice that I would not deploy mid-run, and then did -- the second time
    into a profile already at 160 °C, aborting it. Remembering was the mechanism
    and remembering failed, so the check is mechanical now.
    tools/deploy.py asks the device directly: the firmware prints its run state
    in every telemetry line, so a few seconds of listening is a direct answer
    rather than an inference. running, preheat and cooldown all block -- preheat
    is already applying heat, and rebooting during cooldown discards the run
    report. It fails closed: a port that cannot be read, or a device that says
    nothing, is unknown rather than idle. --force exists and says so lo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
    [deploy.py, test_deploy.py]
2026-08-26 Fix the crash on run start, and the exit path that failed with it
    Two bugs, both mine, both from the incremental-chart change.
    The run crashed immediately on ValueError('Layer already in a group'). _plot
    returned the same TileGrid every frame, but render builds a fresh Group each
    frame and displayio will not put one layer in two groups. A new TileGrid per
    frame over the SAME bitmap: the bitmap is the expensive object and is what
    needs reusing, the TileGrid is a cheap wrapper.
    The crash then exposed a worse one. The top-level finally constructed a
    second DigitalInOut on D4 to drive the relay low, which raises 'D4 in use'
    because Hardware already owns the pin -- so the deliberate drive-low n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
    [code.py, display.py]
2026-08-27 Remote start: a console command interface, and a host-side supervisor
    Tomorrow's run has to be started without anyone at the oven, so the firmware
    now accepts commands on the serial console -- START, ABORT, ACK, STATUS, one
    per line. Reading the console does not disable the REPL; Ctrl-C still
    interrupts. ABORT is unconditional, which is the point of having it.
    START goes through the application's own request_start, so the same
    pre-flight the touchscreen gets applies: it refuses a hot oven, a faulty
    probe, or a device that is not idle.
    tools/start_run.py adds a second, independent opinion from outside. The
    device's guards are the real protection and do not depend on the host, the
    serial lin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
2026-08-27 Log the controller die temperature, and what it revealed
    Suggested from the bench: there is a second temperature sensor in the
    enclosure, on the SAMD51. Reading it alongside the MCP9600's cold junction
    turns out to say something neither says alone.
    Across a full run the cold junction rises 12-15 °C while the controller die,
    centimetres away in the same box, does not move at all. The enclosure is not
    warming -- one chip is. That rules out warm air and points at conduction,
    almost certainly heat travelling up the thermocouple wires into the MCP9600's
    terminals.
    Which matters beyond the box, because cold-junction compensation assumes the
    die and the terminals are at the same temperature. Hea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
2026-08-27 Do not let a new telemetry column break the tools that read it
    Adding the controller die temperature took the row from seven fields to
    eight, and start_run.py's strict length check then refused every pre-flight
    with 'no telemetry' -- which looks like a dead device rather than a parser
    disagreeing about column count. It would have blocked tomorrow's start.
    Parsing now requires the fields it needs and ignores extras, with a test
    covering seven, eight and nine columns.
2026-08-27 Stop rebuilding the display every frame; keep verbatim device logs
    Measured on hardware: 155 render failures in one run, all MemoryError on
    1848- and 2156-byte requests, while roughly 100 KB was nominally free. Free
    memory was never the problem -- contiguous space was, because every Label,
    Rect and Group was reconstructed twice a second.
    The display group and the objects in it now persist. A frame whose shape
    matches the last -- same sequence of kinds, same fonts, same bitmap paths --
    updates text, colour and position in place and allocates nothing; a change of
    screen rebuilds once. Over 200 consecutive frames on the device: no failures.
    This is a prerequisite for WiFi rather than a tidy-u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
    [display.py, start_run.py]
2026-08-27 Keep the screen shape constant, and fault on any supervision gap in a run
    Run 5 cut render failures from 155 to 21, and the remaining 21 say exactly
    where the rest were: every one is on the rebuild path -- "build failed", never
    "update failed" -- so the steady-state path now allocates nothing, as
    intended. Rebuilds happen when the screen's shape changes, and the timing is
    unambiguous: the first failure of the run landed at 217.2 C, precisely as the
    oven crossed liquidus and the time-above-liquidus readout appeared.
    So elements are emitted unconditionally and blanked instead of added and
    removed. One rebuild on entering a screen, none afterwards, with tests that
    fail if either the run screen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
    [layout.py, safety.py, test_network_hostile.py, test_safety.py, test_ui.py]
2026-08-27 Profile library, per-alloy limits, and the last empty-string site
    Five profiles added, each generated from this oven's measured capability
    rather than from a generic curve, and each checked against it:
    Sn42Bi58 low-temp 170 C peak, 64 s above liquidus
    SAC305 reduced peak 230 C peak, 62 s
    Sn63Pb37 leaded 210 C peak, 107 s
    Bake 125 C (MSL) four hours, J-STD-033
    Hold 150 C half an hour, rework and cure
    The low-temp profile exists for a specific problem: a TE MS5525DSO pressure
    sensor rated "250 C, 5 sec max" with no reflow profile published and plastic
    barbed ports, being hand-soldered with damage. A 170 C peak sits about 80 C
    under that maximum.
    Two thi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
    [display.py, layout.py, metrics.py, profile.py, test_ui.py]
2026-08-28 Raise the Python stack, and stop hardcoding a device number
    Three faults, found by trying to add remote profile selection.
    The firmware crashed on its first loop: poll_command returns None whenever no
    complete line has arrived, and the new prefix match called .startswith on it.
    The equality branches tolerated None; that one did not. Guarded, with a test
    that fails if a prefix match is ever placed before the None check.
    "RuntimeError: pystack exhausted" on the splash and self-test. Not heap --
    stack. Building a bitmap_label recurses through PCF glyph loading, and at
    boot that happens inside main -> render -> _rebuild -> _build -> Label ->
    glyph, which is deep enough to exhaust the default.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
    [code.py, display.py, start_run.py, test_app.py]
2026-08-28 Preload glyphs, not just fonts; let a finished report start a run
    Run 8 was clean through the whole profile -- zero render failures -- and then
    failed five times on the cooldown screen's first frame, on "pystack
    exhausted". Raising the stack fixed boot and the failure simply moved: fonts
    were preloaded but adafruit_bitmap_font loads GLYPHS lazily, so the recursion
    reappeared the first time the word OPEN was ever drawn. preload() now pulls
    each font's whole covered glyph set from the coverage manifest, at the top of
    main where the stack is shallow, with 8192 behind it as headroom. Zero boot
    warnings after a hard reset -- which the stack setting requires; a soft reboot
    does not re-read setting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
    [code.py, display.py, start_run.py, test_app.py]
2026-08-28 Run 9: the low-temp profile works, and the readout was too large
    Sn42Bi58 at 170 C peak, first non-SAC305 run this oven has done. Peak 171.5 C
    against 170 asked, 20 relay actuations, and 72 s above the 138 C liquidus --
    inside the 60-90 s window the alloy wants. The controller tracks well outside
    the regime it was tuned in.
    The descent measured what the door costs. The profile commands -2.5 C/s on
    the stated open-door assumption; shut, this oven manages -0.15 C/s, so by the
    end of the profile it sat 55 C above the curve. That is the door instruction
    turned from a calculation into an observation, and in production it is a
    non-issue: somebody is already there to load the board.
    93 render fai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
    [test_ui.py, theme.py]
2026-08-28 A fast diagnostic profile, and a diagnostic that cannot itself fail
    Suggested from the bench: iterate on the problems that have nothing to do
    with temperature using a profile that does not take half an hour to cool.
    profiles/diagnostic-fast.json peaks at 52 C and runs 143 s. It exercises the
    whole machine -- preheat, soak, a liquidus crossing, peak, cooldown, report,
    every screen, the chart, the console commands -- and the oven is back under
    the 45 C pre-flight limit within a couple of minutes rather than thirty. Its
    liquidus is set to 45 C purely so the run crosses it; that number means
    nothing metallurgical, and a `diagnostic` flag suppresses the alloy warnings
    that would otherwise fire,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
    [deploy.py, display.py, layout.py, profile.py, test_deploy.py, test_profile.py, test_ui.py]
2026-08-28 The paste manufacturer's own profile, and a capability check that looks where it matters
    profiles/nc191lta10-datasheet.json is Chip Quik's recommended curve for the
    NC191LTA10 paste, digitised from the datasheet chart: 90 C at 90 s, 130 C at
    180 s, liquidus 137 C at 210 s, peak 165 C at 240 s, back through 137 C at
    270 s. Time above liquidus comes out at 60 s -- the bottom of the window, so
    any shortfall shows as cold joints rather than overheating. Chip Quik
    describe it as a starting point for process optimisation, not a recipe, and
    the profile says so.
    It also needs the door opened at peak: 165 C down to 137 C in 30 s is
    -0.93 C/s and this oven does about -0.13 C/s shut.
    Adding it expose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
    [profile.py, test_measured.py]
2026-08-28 Restore two functions I deleted, and test the modules no test can import
    Moving one function out of display.py cut the span between it and the class
    below -- which also contained _font() and preload(). Both were deleted. All
    259 tests passed, the deploy reported success and verified the file matched
    the repo, and the firmware died on boot with "ImportError: cannot import
    name preload".
    The gap is structural: display.py and code.py need a board, so the suite
    never imports them, and nothing noticed names vanishing. tests/
    test_firmware_contract.py now parses rather than imports: it checks that
    every name code.py imports actually exists in the module it claims to come
    from, that display.py's i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
2026-08-31 First fully clean run, and a diagnostic profile that actually iterates fast
    Run 11 on the diagnostic profile: zero render failures across the whole
    lifecycle -- running, cooldown and report. That is 155 -> 21 -> 6 -> 0 across
    the memory and stack work, and the first run to reach "report" without the
    firmware dying since the low-temp runs started failing.
    Two things the fast profile taught in its first use.
    It overshot its 52 C peak by ten degrees. On a curve that short the
    feed-forward commands heat the thermal mass carries past; real profiles have
    long enough ramps that it settles. Recorded rather than tuned out, because
    it does not affect the profiles that matter.
    And it was not actuall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
2026-08-31 Reserve the chart buffer at boot; make the abort test refuse a hollow pass
    ABORT works on real hardware: issued mid-run, the relay showed energised in
    zero subsequent samples and the machine went cooldown -> report. But the test
    was honest about why that pass was weak -- the relay had never come on at
    all. The oven was at 43.6 C and the diagnostic profile peaks at 39, so the
    curve never asked for heat and there was nothing to abort. The test now
    detects that and exits INVALID rather than reporting a pass, and says what
    starting temperature the profile needs.
    The run also failed to allocate the chart: MemoryError on 5904 bytes. Run 11
    managed it every time from a freshly booted device; this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
    [code.py, display.py, test_firmware_contract.py]
2026-09-01 Fix preheat never heating, and the render failures behind the run deaths
    Four defects, all found by testing the paths rather than the temperatures.
    Preheat commanded duty but never closed the relay. _drive gated the
    non-running states on `duty > 0.5`, and the only duty preheat ever asks
    for is exactly 0.5. On the bench the oven sat at 26.5 C with a 45 C
    target, printing duty=0.500 every step while cooling, and would have done
    so until the 900 s timeout. Every heating state now modulates through the
    same time-proportional output instead of having a second, weaker path.
    This went unseen through eleven runs because only a profile starting
    above ambient enters preheat, and none of them had.
    Re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
    [app.py, code.py, deploy.py, display.py, layout.py, soak.py, test_app.py, test_deploy.py]
2026-09-01 Stop a run dying on memory, bound the chart, and let a bake finish
    The run that died at 90 C with the relay at full duty did so on
    history.append: the chart trace was a plain list appended to for the
    length of the run, and growing it wanted 256 contiguous bytes the heap
    could not offer. It is a History now, bounded at 150 points -- past that
    it drops every other sample and doubles its interval, so the trace keeps
    the shape of the whole run at lower resolution and the allocation
    ceiling stops moving. The longest shipped profile is a four-hour bake;
    the chart is 308 pixels wide. There was never a reason to hold more.
    More importantly the MemoryError propagated out of main() and stopped
    the fi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
2026-09-01 Give cooldown its own clock
    Making the run timeout follow the profile broke every run, and the
    on-device simulator caught it within one pass: a completed 360 s profile
    faulted at 1050 s with "run exceeded its time limit" while it was
    passively cooling from 224 C. Because faults latch, the next eight
    profiles never heated at all -- they inherited the fault and reported the
    same message, which made a single mistake look like nine.
    The timeout was measured from the start of the run and kept counting
    through cooldown, so tightening it to the profile's own duration left no
    allowance for the part that takes longest. Measured passive cooling is
    about -0.7 C/s at 190 C and falls off sharply toward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
    [app.py, safety.py, test_app.py, test_safety.py]
2026-09-01 Exercise the fault paths and the four-hour bake on the device, without heat
    Two harnesses for the paths that a heated run reaches slowly or not at
    all. Neither can heat: like the rest of tools/device they never import
    oven.hardware, so the relay pin is never claimed.
    faults.py provokes over-temperature, an open thermocouple, a frozen
    sensor and a sensor that returns nothing, and checks the whole path for
    each: the right fault trips, the relay is commanded off, the fault screen
    renders on the real display, heat stays refused while the fault is
    latched, ACK returns the oven to idle, and a run can be started again
    afterwards. All four pass, with free memory identical after every case,
    so the f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
2026-09-01 Guard text against missing glyphs, and render the screens where they can be seen
    Every check in this project proved that rendering did not raise. None of
    them proved the screen was right: a label can be clipped, overlap its
    neighbour, or come out blank and the whole suite still passes. The only
    real check has been someone photographing the oven.
    tools/render_screens.py draws the command lists layout.py emits using the
    same PCF files the device loads, glyph for glyph, to PNGs. It is not a
    mock of the display library -- same geometry, same fonts, somewhere it can
    be looked at. It found a typographic fault immediately: the fault screen
    wrapped "120.06" onto one line and "°C" onto the next, wh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
    [display.py, glyphs.py, layout.py, render_screens.py, test_runtime_strings.py, test_ui.py]
2026-09-01 Load one profile instead of ten, and measure what WiFi would cost
    Asked whether the memory problems get worse with WiFi, the answer was
    worth measuring rather than guessing. On the device the stack costs 31 kB
    -- 16 kB for adafruit_esp32spi and 13.7 kB for adafruit_requests -- and
    the running firmware had 16 kB free. Roughly twice the entire heap.
    So the budget was measured too, part by part in the order code.py builds
    them. Fonts and their glyphs are the largest single item at 59 kB, which
    cannot be reduced without rebuilding the subsets and there is no font
    toolchain in this repo. The next largest was ten profiles at 24 kB, of
    which exactly one is ever in use.
    Profiles are now catalogued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
    [code.py, profile.py, test_firmware_contract.py, test_profile_catalogue.py]
2026-09-01 Put the oven on WiFi, and measure what it can afford to do there
    The oven is on the network: it scans, joins whichever known network is
    strongest, and fetched a real page over a raw socket -- HTTP/1.1 200 OK
    from eridani, 512 bytes. IP 10.20.10.242 at -36 dBm from inside the
    enclosure, so the radio was never the constraint.
    Memory is. Measured rather than assumed, and the numbers decide the
    architecture:
    firmware free, idle 30352
    the running screen costs -14080
    free during a run 16272
    esp32spi + socket, resident 18192
    a connected session 4400
    WiFi needs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
2026-09-01 Measure the touchscreen calibration instead of inheriting it
    Nothing about touch had ever been verified on this oven. The calibration
    was carried over from the previous firmware because that was the only
    place it had been written down, and every control depends on it --
    including ABORT, which is the one that has to work.
    Measured with a person touching five crosses at known points. The
    inherited values read consistently high: mean bias +11.8 px in x and
    +5.6 px in y, with the bias almost equal to the mean absolute error, so
    it was systematic offset rather than noise. Shifting both ends of each
    axis by the same number of raw counts moves the output without changing
    the scale, which is what a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
    [hardware.py, test_device_tools.py, touchtest.py]
2026-09-01 Hand the filesystem to whoever should have it, and fix a shadowed import
    USB is present for programming and absent in normal use, and CircuitPython
    can only write to CIRCUITPY when the host is not. So the oven should own
    the filesystem when it is standalone -- that is the only time it can keep
    a record of a run, and the only time anything else would.
    The obvious signal does not work. supervisor.runtime.usb_connected reads
    False inside boot.py even with a cable attached, because CircuitPython
    starts USB after boot.py finishes. Sampling it handed the filesystem to
    the oven while it was plugged in and locked the host out of its own
    volume. Polling it for five seconds did exactly the same thing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
    [boot.py, bootmode.py, code.py, deploy.py, test_bootmode.py, test_firmware_contract.py]
2026-09-01 Ask the network the time, and enter a profile where the oven already is
    NTP, because the oven has no battery-backed clock and every run it records
    is otherwise stamped with seconds since boot -- enough to plot a run
    against itself and useless for saying which run it was. The wire format
    lives away from the radio because that is the part worth testing: a
    malformed or hostile reply must raise rather than return a plausible
    number, since a clock set from a bad answer is worse than one that is
    admittedly unset. Twenty-three tests, including a client packet echoed
    back, a kiss-of-death stratum, an unsynchronised server and a truncated
    reply.
    Writing those found a fact about the protocol: the tra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
2026-09-01 Pack the measured rate curves into arrays
    The characterisation arrives as JSON lists of [temperature, rate] pairs and
    was kept in that shape, costing 7.2 kB of SRAM on a board with about 30 kB
    free. Almost none of that is the numbers: a Python float is a heap object,
    a two-element list is another, and sixty of them come to roughly a hundred
    bytes apiece before holding a value. Two array('f') hold the same curve at
    four bytes per number, contiguous, with no per-element object at all.
    The interpolation is unchanged, and the test says so rather than assuming
    it: RateTable is checked against the plain pair-list interpolation across
    the whole measured span at half-degree steps, on the real chara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
2026-09-01 Release the parsed characterisation once its curves are packed
    Packing the rate curves into array('f') made things worse before it made
    them better. FeedForward copies the numbers out, but code.py held the
    parsed JSON dict for the life of main(), so the original lists of
    [temperature, rate] pairs stayed alive alongside the arrays. Measured on
    the device, free fell from 30352 to 27056: a saving that cost 3 kB.
    Dropping the dict once the curves and the coast constant are out of it
    gives 34160 free, which is the packing's ~5 kB less about 1.5 kB of
    bytecode for the new module. The self-test still reports whether the
    characterisation loaded, from a boolean captured before the dict goes.
    A test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
2026-09-01 Ask for the door at the peak, and record a run without a host
    First run written entirely by the oven to its own filesystem, with the
    host holding nothing: 886 lines, header, 879 samples at 1 Hz, and a
    trailer with the summary. At 17.6 kB for a ten-minute run the 7.6 MB free
    holds roughly 430 of them. It also exercised the warm-start entry on
    hardware for the first time -- run_started reported entered_at_s 1.5 from
    an oven at 27 C.
    The run was the NC191LTA10 datasheet profile, never run before, and it
    found something that matters for using it in production. It reached
    169.7 C against a 165 C spec, which is fine, and then held 133 s above
    liquidus against a 60-90 s window, which is not. Every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
2026-09-01 Ask for the door a thermal lag early, not at the peak
    An operator ran the NC191 datasheet profile and opened the door within two
    seconds of being asked. The thermocouple did not show it for a minute: the
    reading rose for another 10 s on element inertia, fell at -0.4 C/s for 50 s
    more -- indistinguishable from a shut door -- and only then dropped at
    -5.2 C/s. The probe follows the cavity walls, not the air, so the door's
    effect is delayed rather than weak.
    Read from the trace alone that looked like a slow operator, and this commit
    first "fixed" it by prompting on accumulated time above liquidus with a 15 s
    allowance for reaction. That model was wrong in both terms. The operator
    said what the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
    [app.py, layout.py, test_app.py, test_ui.py]
2026-09-02 Correct the door timing: the lag was four seconds, not sixty
    The operator said they had opened the door within two seconds of being
    asked, which did not match the trace at all -- the reading did not move
    for a further sixty. I wrote that up as thermal lag in the probe. It was
    neither that nor a slow operator: the red banner added earlier was never
    wired into code.py. The edit that was supposed to pass open_the_door to
    L.running silently failed to match, so nothing was ever drawn, and what
    the operator actually responded to was the cooldown screen a minute later.
    The instrument was wrong, not the oven.
    Anchored to the screen change they did respond to, the numbers are
    ordinary: cooling faste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
    [nc191-measured-run.csv]
2026-09-02 Set the clock from the network, then hand the memory back
    Run logs were stamped "monotonic+40", which is enough to plot a run
    against itself and useless for saying which run it was. They now read
    2026-09-02T22-23-06Z, and the filesystem gets real dates too -- the
    previous log is dated Dec 31 1999.
    The time comes from the ESP32's own SNTP rather than a hand-rolled NTP
    exchange over SPI, which is the least trodden path in that library. It is
    still run past timesync's bounds check, because an unsynced co-processor
    returns a small number rather than an error. It also is not ready the
    instant the network is joined -- asking immediately raises "_GET_TIME
    returned 0", which is what it says instead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
    [code.py, radio.py, test_architecture.py, test_diagnostics.py]
2026-09-02 Stop shadowing the libraries this firmware already has frozen
    The PyPortal firmware carries adafruit_esp32spi, adafruit_display_text,
    adafruit_requests, neopixel, adafruit_bus_device and adafruit_portalbase
    frozen into flash -- help("modules") on the device lists them, and the
    build log says FREEZE on exactly those. CIRCUITPY also carried .mpy
    copies, which shadow the frozen ones and get loaded into RAM instead. The
    Adafruit bundle puts them there; nothing was wrong except that nobody had
    asked what was already in the firmware.
    import adafruit_esp32spi 16064 bytes shadowed, 16 frozen
    whole connected session 22592 bytes shadowed, 1872 frozen
    idle free memory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
    [deploy.py]
2026-09-02 Freeze the oven's own code into the firmware
    Module bytecode loaded from the filesystem lives in a 256 kB RAM that also
    has to build a UI; bytecode frozen into the CircuitPython image executes
    from flash. Freezing the oven package took free memory from 36032 to 77952
    bytes and the largest contiguous block from 2608 to 7024.
    Across the whole effort, measured on the board with the oven idle:
    all ten profiles, libraries shadowed 16384 free, largest 1696
    one profile loaded 30352 largest 4912
    rate curves packed into arrays 34160
    shadowing libraries moved aside 36032 largest 2608
    oven package frozen 77952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
2026-09-03 Add a one-command build and flash, and measure what the memory bought
    Freezing oven/ into the firmware means edits there no longer take effect by
    deploying: they need a rebuild and a reflash. That loop has to be one
    command or it will be skipped, and someone will spend an afternoon
    wondering why their change did nothing. tools/release.py syncs the sources
    to the build host, builds, fetches the image and puts the board into its
    bootloader over serial -- no physical access, which matters because the USB
    port is behind a panel. Writing to the bootloader is left as a deliberate
    manual step.
    It also refuses to flash while anything on the volume would shadow the
    frozen build, and a test holds its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
    [release.py, test_release.py]
2026-09-03 Build the run archive upload; the transport is not yet proven
    The oven can record a run with no host attached, and now has somewhere to
    send it: uploader.py decides what to send and what counts as delivered,
    netconfig reads an optional archive endpoint, logstore can read a run back
    and mark it handed over, and tools/collector/serve.py receives them and
    prints a one-line summary. 532 tests.
    Two rules in there matter more than the plumbing. A log is marked sent only
    on a 2xx, because marking it wrongly leaves the oven's copy as the only one
    and the next eviction may delete it. And eviction now removes uploaded runs
    before unsent ones, for the same reason -- a run that has not been handed
    over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
    [code.py, logstore.py, netconfig.py, radio.py, release.py, test_collector.py, test_logstore.py]
2026-09-03 Stream run logs to the archive; the chain now closes end to end
    Three runs uploaded themselves at boot, unprompted, and arrived intact:
    26601 bytes of NC191, 13425 of the diagnostic, 35730 of SAC305, each with
    its summary read back correctly by the receiver. The oven records a run
    with no host attached, boots, sets its clock from the network, hands the
    logs over and marks them sent.
    Four separate things were wrong, and each hid the next.
    The build silently omitted a module. CircuitPython writes the freeze
    manifest once and make then treats it as current, so oven/uploader.py
    never reached the image while the build reported success. release.py now
    clears the manifest and verifies every modul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
    [code.py, logstore.py, radio.py, test_logstore.py, test_uploader.py, uploader.py]
2026-09-03 Surface faults in the notification, not just the summary
    The oven cannot tell anyone anything during a run: the radio may not come
    up while a profile is running, because an SPI call can block 227 ms
    against a 250 ms control deadline. So the notification happens when the
    run is handed over afterwards, which is the earliest moment there is.
    That makes the summary line the only thing anyone reads promptly, so it
    now carries what actually went wrong -- faults, aborts, and any J-STD
    check that failed -- rather than only the peak and time above liquidus. A
    run that faulted at 262 C and one that finished cleanly used to produce
    summaries that looked much the same.
    notify-example.sh is a starting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
    [test_collector.py]
2026-09-03 Track the bench host's own scripts and units
    Writing up where everything is stored turned up three things that existed
    in exactly one place. Two of them were mine and are now in the repo: the
    session launcher, and the two systemd units that keep this host reachable
    -- the WiFi power-save fix and the gratuitous ARP announcer.
    They were living only on an SD card that is 92 % full and had already gone
    read-only once mid-session. Neither is needed for the oven to run, which
    is precisely why nobody would notice they were gone until they were needed.
    The third, wifi.json on the oven, stays out on purpose: it holds the
    network passwords. It should be wherever passwords normally live.
    Co-Authored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
2026-09-03 Serve the oven's own runs over HTTP; it starts and then loses the network
    The archive upload was aimed at the wrong place and I should have asked
    before building it. In normal operation the oven is on Taeron and the
    collector is on 10.20.10.x, which it cannot reach -- so the uploads work
    and are pointed at a host that does not exist from the oven's point of
    view. What was actually wanted is to take logs off the oven directly.
    I did not put that decision to anyone. I asked for a firewall port, which
    made an architectural choice look like plumbing.
    So: the oven serves its own page. oven/webapp.py holds the routing,
    rendering and refusals with no hardware in it, tested on the host -- 24
    tests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
    [code.py, test_firmware_contract.py, test_webapp.py, webapp.py]
2026-09-04 Correct the record: the web service works, and always did
    The previous commit said the server starts and then loses the network. It
    does not. An operator can fetch the oven's page in 0.49 s and a 26601-byte
    run log in 2.74 s, and could have from the first attempt.
    What could not reach it was the machine I was testing from. The oven
    answers the gateway, a wired host and another wireless host on every
    attempt, and never answers taeronpi -- arping gets 0 responses from 3
    broadcasts there while bench5 answers 2 of 2, with every ARP sysctl at its
    default. Mutual, specific to that pair, and unexplained.
    Recorded in docs/network.md along with the two wrong explanations that
    came first, both of wh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
2026-09-04 Diagnose the unreachable oven: it ignores broadcast ARP
    The failure was never mutual and never unexplained. A host with an empty
    ARP cache cannot reach the oven; a host handed its MAC address reaches it
    perfectly, and the kernel's unicast refresh probe is answered. tcpdump
    shows the requests leaving the radio with nothing coming back and nothing
    dropped by the kernel, so the Pi's stack is not at fault -- it is just the
    only host the oven has never addressed first, and so the only one that
    ever had to ask.
    An operator's phone will be in the same position. The fix belongs in the
    firmware: announce the address unprompted, by gratuitous ARP or mDNS.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
2026-09-04 Find the real fault: this AP delivers no broadcast to its clients
    Two devices sharing nothing -- a Broadcom radio in a Pi and the oven's
    Espressif co-processor -- receive zero group-addressed frames on this
    network, while unicast is perfect both ways. 180 s of tcpdump on one and
    a UDP listener on the other, each with a control that arrived. A device
    that cannot receive a broadcast cannot answer a broadcast ARP, so neither
    can be found by anything that does not already know its MAC address.
    That is the access point, and no firmware change can reach it. A power
    saving fix was written for the previous theory and is reverted here: NINA
    accepted WIFI_PS_NONE and it changed nothing.
    Also correct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
2026-09-04 Put the oven's address on its own screen
    On a network that does not carry broadcast, nothing can discover the oven
    by asking for it, and the address is different on every network because
    it comes from whatever DHCP server is there. The screen is the only
    channel that still works, so the idle screen now reads
    "http://10.20.10.242", or "no network" when there is none.
    This is not a fix for the underlying fault and is not meant to be one. It
    is what makes the fault answerable: an operator reads the address off the
    front of the oven and types it into a phone, and that either works or it
    does not. The test costs five seconds instead of an afternoon.
    Proved on the way here that no announcement s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
    [code.py, layout.py, render_screens.py, test_firmware_contract.py, test_ui.py]
2026-09-04 Rebuild the runs page around what a reader came for
    Named for the machine it is. The status line is gone: this page only
    ever serves while the oven is idle, so "idle" told nobody anything, and
    the selected profile cannot be changed or started from here, so it was
    decoration. Both were reported as such.
    Runs are a table of date, time, profile and size, newest first, read
    back out of each log's own header rather than kept in an index -- the
    filesystem is the index, and a run that survived a power cut still
    carries its start time and profile. A run written before the clock was
    set says "run 0001" instead of a date it does not have; that is not only
    old files, it is the first run after every po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
2026-09-05 Serve run logs under a name that means something to whoever gets one
    Hiding .sent on the page was cosmetic. The file still arrived called
    0003-SAC305-this-oven.csv.sent, which will not open in the thing people
    open CSVs with and tells them nothing about what they are holding.
    The link, the URL and the Content-Disposition filename are now all the
    clean name, and safe_log_name maps a request back to whatever is
    actually on flash -- so an old .sent link still resolves, and a name the
    store does not list is still refused.
    The suffix stays on flash, where it is what it always was: a note to the
    eviction order that this run exists somewhere else. That is a fact about
    housekeeping and it now stop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
    [code.py, test_webapp.py, webapp.py]
2026-09-05 Delete the sent suffix, and read times where the oven is
    The suffix could not be justified, so it is gone. Nothing renames a run
    any more: whether a run has been handed to an archive is recorded in a
    sent-index beside the logs, which runs() steps over. The three files on
    the oven are renamed back.
    The argument in the code for the rename was that it is one atomic
    operation where an index is a second thing to keep consistent, wrong
    after a power cut mid-write. Sound as far as it went, and it missed
    where the cost lands. The index can only fail by losing names, which
    offers a run again -- the cheap mistake. Marking a run sent when it was
    not is the expensive one, and neither scheme does that.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
    [code.py, logstore.py, pacific.py, test_logstore.py, test_pacific.py, test_uploader.py, test_webapp.py, uploader.py]
2026-09-05 Cut the profile set to the pastes that are actually stocked
    Ten profiles down to five, one per paste, named the way the syringe is
    labelled: TS391SNL, TS391LT, NC191LTA10, Bake 125 C, and DIAGNOSTIC
    which is no longer offered to whoever is choosing.
    The "(this oven)" and "(datasheet)" qualifiers are gone. They only ever
    existed to tell two curves for one paste apart, and after the cull each
    paste has one.
    TS391SNL keeps the measured curve and is re-cited to Chip Quik rev 1.2.
    Its datasheet chart asks 1.40 C/s from 175 to 217 C and 1.07 C/s from
    217 to 249 C, where measured capability is about 0.90 and 0.70. Running
    it would miss both ramps and make a joint nobody characterised. Peak
    stays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
    [code.py, faults.py, profile.py, render_screens.py, test_app.py, test_controller.py, test_measured.py, test_network_hostile.py]
2026-09-05 Stop deploy leaving a board that cannot boot, or profiles that are gone
    Two gaps found by walking into both of them while shipping the profile
    cut.
    Deploy copied and never removed, so cutting ten profiles to five left
    all ten on the board. A stale profile is not inert: it is offered to
    whoever is choosing one, and one of the ten sat above the liquidus of
    both low-temp pastes now in the fridge. Deploy now prunes directories
    the repository owns completely, which today is profiles/, and says what
    it removes. Nothing else on the volume is touched -- wifi.json, the logs
    and boot_out.txt are not the repository's to delete.
    The second is worse. oven/ is frozen into the firmware, so a name added
    t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
2026-09-05 Build the page in pieces, because one string was too big for the heap
    Adding the upload form doubled the page to 3.4 kB, and building it as a
    single concatenated string asked the heap for a 3304-byte block it could
    not reliably find. The service caught the MemoryError, stopped and
    restarted, so the page answered roughly one request in four -- which
    read like a flaky network and was not.
    It is now returned as thirteen pieces, largest 1177 bytes, and the WSGI
    app encodes them one at a time. The log download has streamed in
    512-byte pieces since it hit exactly this wall; this is the same fix in
    the same place, and it should have been written this way to begin with.
    Verified on the oven: ten f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
    [code.py, test_webapp.py, webapp.py]
2026-09-05 Document what the page can do now, and what the tools are
    network.md enumerated what the page can and cannot do and was written
    before it could take a profile. It now records the upload, what an
    upload is not allowed to do to itself, and that the 2560-byte limit is
    measured rather than chosen.
    README described tools/ as "deploy, model fitting", which predates
    release, rollback, screen rendering, profile formatting, the on-device
    tools and the collector.
    Claude-Session: https://claude.ai/code/session_01V2zgdtVfvC5mZtZSH1bbi6
2026-09-05 Test the rollback on real hardware, and fix the two things that found
    You do not know a recovery path works until you have used it. Rolled a
    board back and forward, twice, and it was broken in two ways.
    The first: --rollback swapped the two archived images before printing
    which one to copy, so the path in the message held the image being
    rolled back FROM by the time anyone read it. It flashed forward and
    looked like it had worked -- exactly the silent no-op the swap was meant
    to prevent. The image is now copied to a third name the rotation never
    touches, so what is printed and what is flashed cannot drift apart.
    Confirmed by checksum and by asking the board which build it is running.
    The s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
    [release.py, test_release.py]
2026-09-08 Ask for the door once, in one form, and open the log when the run starts
    The door was asked for twice, in two visual languages. A small red line
    inside a frame on the running screen, then nineteen seconds later a huge
    blue OPEN / THE DOOR when the state changed to cooldown. The operator
    read them as two separate requests and acted on the louder, later one,
    which is the reasonable thing to do.
    Measured on NC191LTA10: banner at 280.6 s, cooldown screen at 299.3 s,
    cooling still -0.4 C/s at 302 s and -2.5 C/s by 308, so the door opened
    around 306. Twenty-six seconds above liquidus at -0.4 C/s is the whole
    of that run's 97 s time above liquidus against a 90 s ceiling. Opening
    on the banner woul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
2026-09-08 Count the door down instead of asking with no notice
    The request went up the instant it was needed, and on NC191LTA10 that
    was while the operator was across the room. The 26 s it took them to
    reach the oven was the whole of that run's 97 s time above liquidus
    against a 90 s ceiling.
    It turns out to need no prediction machinery. Time above liquidus grows
    at one second per second while the oven is above it, so the shortfall
    between where the run is and where it needs to be IS the countdown, and
    it self-corrects every tick as the temperature moves. The last twenty
    seconds of it are shown.
    The instruction does not change at zero. OPEN / THE DOOR is already up,
    in the same words, size, colour a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
    [run-0006-nc191lta10.csv]
2026-09-08 Measure what the door does, and make the step test a profile
    Run 0007 is the first time the door has been measured against a known
    open instant: the firmware asked at 281.7 s and the operator opened
    inside a second, against ten seconds of flat -0.44 C/s beforehand.
    onset 1-2 s
    full effect about 3 s
    peak rate -8.31 C/s at about 4 s
    A nineteenfold change, at the probe, inside two seconds. The peak is
    well above the -5.2 C/s quoted throughout this project, and both are
    right about different things: the rate decays as the gap to ambient
    closes, so the average over a descent lands near 5 -- which is what
    DOOR_COOLING_C_PER_S is used for, and this run is the first ev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
2026-09-08 Extend the measured oven to 250 C, and stop the report crying wolf
    The step test reached 252.75 C with the cutoff engaging at 251 and
    coasting 1.75 C, seven under the supervisor's ceiling. The enclosure
    peaked at 53.4 C against 41.8 on the 240 C run, still 17 below the fault
    point. So 249 C is reachable -- but the datasheet ramp is not: TS391SNL
    asks 1.07 C/s from 217 to 249 and this managed 0.63. Reaching 249 is a
    matter of taking longer, not of going faster.
    Heating above 235 C and cooling above 240 C were extrapolation until
    now, and the single cooling entry that did exist at 240 C was an
    end-of-data artifact. Both are measured.
    The awkward part is recorded rather than smoothed over. Th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
2026-09-09 Withdraw two cooling numbers, one of which I did not measure
    The 250 C step test did not extend the cooling table, and the previous
    commit said it did. The controller held 250 C until 333 s, by which
    point the oven was already down to 231.6, so the highest genuinely
    free-cooling sample is 223.7 C -- below where the table already ran.
    The entry at 240 C came from a window that straddled the hold. The entry
    at 250 C I interpolated and then described as measured. Both are gone.
    Heating is genuinely measured to 248 C and stays, relabelled from 250 to
    the temperature it was actually taken at.
    This surfaced because the operator left the door shut as asked and the
    log kept running to 1040 s, whic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
2026-09-10 Stop closing the radio for a run: that is the DONE button lag
    Pressing DONE at the end of a run returned the oven to idle, and the next
    pass of the main loop called web.start() -- a WiFi scan and associate,
    documented in docs/network.md at 9-18 s. Measured on the board across a
    boot: the 4 Hz telemetry stops at t=85419.25 and resumes at 85443.47.
    24.22 s with no telemetry, no touch polling, no console, and the report
    screen still up because the render never got a turn either.
    It happened on exactly one transition -- back to idle -- which is the DONE
    button at the end of every single run. Reported twice as "the DONE button
    doesn't work"; once fixed by moving the button, which was also real a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
    [code.py, test_firmware_contract.py]
2026-09-10 Give CIRCUITPY back to the oven, and stop calling a working reset a failure
    A deploy needs the host to own CIRCUITPY; the oven needs to own it to
    record a run. deploy.py could take it (claim_volume_for_the_host) and had
    nothing to give it back, so every deploy left the oven silently unable to
    log -- it runs perfectly and simply keeps no record, discovered only when
    someone goes looking for the log afterwards. That happened today.
    python3 tools/deploy.py --standalone
    Unplugging the cable is the obvious alternative and takes two power cycles,
    because the mode is recorded a boot late by design. This is one reset, with
    the cable attached, which is also the only way to watch the result.
    It r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
    [deploy.py, test_deploy.py]
2026-09-10 Nothing is above a liquidus that does not exist
    Run 0009 -- a 15201 s bake -- closed its log with "tal=15302": a time above
    liquidus longer than the run that produced it. A bake carries liquidus_c of
    0, and "temp_c >= 0" is true from the first sample, so every sample counted.
    The check on that number was already suppressed for profiles with no
    liquidus. Suppressing the check left the counter running, so the report was
    quiet and the log still carried the nonsense -- which is worse, because the
    log is what gets read later by someone who was not there.
    Two changes: the metric stops accumulating, and the summary line stops
    printing a field that has no meaning for the profile.
    metrics.py is fr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
2026-09-10 Record the trial day: five runs, and the bake passes
    docs/profiles.md said "Never run" or "pending" for three profiles that have
    since run, and the results were only in a conversation. Written from the
    logs, not from memory -- four of the numbers I had been carrying were wrong
    by a digit, and run 0004 had a FAILED check I had recorded as a clean pass.
    0004 DIAGNOSTIC peak 103.5 C max ramp up FAILED 3.20 C/s vs 2.5
    0005 TS391LT peak 169.8 C TAL 83 s passed, first attempt
    0006 NC191LTA10 peak 169.3 C TAL 98 s FAILED by 8 s
    0007 NC191LTA10 peak 169.3 C TAL 76 s passed
    0008 STEP 250 C peak 252.8 C 249 C demonstrated
    0009 Bake 125 C peak 127.2 C pa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
    [bake-125c-run-0009-2026-09-09.csv]
2026-09-10 Do not call a third of a second a ramp rate
    Run 0004 reported "max ramp up FAILED 3.20 C/s" against a 2.5 limit, on a
    run that was otherwise clean. That rate is 73% above anything this oven has
    produced:
    step tests, peak of the heating table 1.85 C/s near 80 C
    run 0004's own log, recomputed 1.58
    the same profile simulated end to end 1.84
    every other run that day 1.87 - 2.03
    The rate window had an upper bound of 5 s and no lower bound. It scans from
    the oldest sample within the window, so for the first seconds of a run it
    was measuring over a fraction of a second -- and a degree of thermocouple
    noise over 0.3 s is 3 C/s.
    The 4 Hz samp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
    [metrics.py, test_metrics.py]
2026-09-10 Generate the curves from the measurement they claim to come from
    Three profiles said "derived from data/oven-characterisation.json" and
    nothing derived them. The points were worked out once, by hand; the
    characterisation has since been measured three times and the curves never
    moved, because moving them meant somebody redoing the arithmetic.
    data/profile-specs.json now says what each profile is metallurgically and
    tools/make_profile.py turns that into points using the measured rate
    tables. A test asserts every shipped file is byte-identical to what its
    spec generates, so it cannot drift again.
    Two things stop being somebody's job to remember. cooling_assumes_open_door
    is derived -- whether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
    [make_profile.py, test_measured.py, test_profile.py]
2026-09-10 Keep this Pi and the oven findable, and stop the fix eating the oven
    taeronpi became unreachable from bench5 while it was up, associated and
    healthy -- 16 days uptime, gateway at 6 ms, 3 of 3. The same fault the oven
    has had all along: broadcast ARP does not resolve on this access point, and
    bench5's entry had gone STALE. Pinning it by hand took the Pi from 0/3 to
    4/4 in one command.
    Measured while fixing it, and it sharpens what was known: from this Pi a
    cold-cache ping of WIRED eridani resolves 3 of 3 with the entry deleted
    first, while wireless bench5 and the oven do not resolve at all. A broadcast
    leaving this host reaches the wire and not the air. That decides what each
    half of the fix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
2026-09-10 Boot once, and never stop the oven to talk to the radio
    Reported as "it boots up twice and looks hung at the screen where the
    components all passed OK". It did, and it was.
    splash, self-test, then 24.22 s of FROZEN LOOP for the clock's own
    connection, then supervisor.reload(), then splash and self-test again,
    then another 24.22 s of frozen loop for the page's connection
    About fifty seconds, most of it answering nothing at all -- no telemetry, no
    touch, no console -- with the self-test panel on screen and every line
    reading OK. Indistinguishable from a hang, which is what it was called.
    Measured on the board after this change, cold boot with the clock unset:
    t = 9.9 s first tel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
2026-09-10 Stop rebuilding the chart's data on every frame
    Run 0009 logged "composing a screen ran out of memory 3256 times" over a
    four-hour bake. The display recovered each time -- the previous frame stays
    up -- so the run was unaffected and the screen was stale about five percent
    of the time. The cause:
    series.append((T.DIM, list(profile_points)))
    series.append((T.BRAND, list(history)))
    Both lists copied on every compose, four times a second, for the whole of a
    run. The history one holds up to 150 points and is the largest single
    allocation the running screen makes; over 15201 s that is roughly sixty
    thousand of them. A non-compacting collector turns that into a heap with
    plenty free and n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
2026-09-10 Measure what a compose actually costs, and say which byte mattered
    The previous commit removed two list copies on the argument that they were
    churn. Measured on the board since, and the real argument is sharper:
    one compose of the running screen 2896 bytes held
    of which list(history), 150 pts 1056
    and list(profile_points), 25 160
    Forty-two percent of the compose, four times a second. But the total is not
    the point. The 1056-byte copy was the LARGEST SINGLE REQUEST the screen
    made, and run 0009 ended with a largest free block of 1776 bytes while
    reporting 50 kB free. A fragmented heap satisfies forty small tuples and
    fails one kilobyte in one piece -- which i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
    [layout.py]
2026-09-10 Withdraw the access point fault: it is not reproducible
    docs/network.md has asserted since 2026-09-04 that this access point
    delivers no broadcast to its wireless clients. It was audited by someone
    with access to it and it is clean: client isolation off on both interfaces,
    no broadcast or multicast filtering, multicast-to-unicast off, IGMP snooping
    off, Multicast Enhancement 0, no ebtables, intra-BSS forwarding on. A
    broadcast ARP from the router was answered by all twelve associated wireless
    clients on both bands, this Pi and the oven included.
    Re-tested here, forcing every probe to broadcast instead of letting arping
    fall back to unicast:
    arping -b -c 5 oven 10.20.10.242 (wire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
2026-09-10 A cable left in should not cost the oven its logging
    Reported as a red FAIL beside "run logging" on the power-on screen after a
    cold boot. The oven was fine; it genuinely could not log, and it could not
    have logged on any boot until somebody unplugged the cable.
    remember_boot_mode wrote HOST whenever it saw a cable. So with a programming
    cable attached -- which is how this bench works -- every boot rewrote the
    mode back to HOST, and every following boot came up with the volume owned by
    the host and logging off. Handing it back with --standalone lasted exactly
    one boot. The message that tool prints even said so, and called it design.
    Now only one direction is automatic:
    cable comes out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
    [bootmode.py, code.py, deploy.py, layout.py, test_firmware_contract.py, test_ui.py]
2026-09-10 Rebuild the cooling table from run 0010, and find what run 0008 was telling us
    Ran STEP 250 C on the rebuilt profile. It did what it was rebuilt to do:
    peak 252.94 C (simulated 253.04)
    relay last fired at 250.94 C (run 0008: 232 C)
    cold junction max 47.31 C (fault at 70)
    free cooling 3762 samples, 245.1 C to 58.4 C, relay open
    Run 0008 stopped driving at 232 C, below where the cooling table already
    reached, and so extended nothing. This one hands over 187 degrees of clean
    free fall, which is what the descent-follows-the-measured-curve change was
    for.
    THE COOLING TABLE IS NOW THIS RUN, replacing the one stitched from the two
    20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
    [step-250c-run-0010-2026-09-10.csv]
2026-09-10 Run the new lead-free curve, and find what a warm start does to it
    Run 0011, TS391SNL at 245 C, the first time the regenerated curve has been
    on hardware:
    peak 246.69 C (asked 245, simulated 246.2)
    time above liquidus 97.7 s (window 60-150)
    max ramp up 2.00 C/s (limit 2.5)
    time to peak 305 s (limit 480)
    cold junction max 48.06 C (fault at 70)
    Every check passed. The peak sits 29.7 C above liquidus, inside the 20-40 a
    SAC305 joint wants; run 0003 on the old 235 C curve sat 19.4 above, below
    the range that makes the joint. That was the reason for moving it, and the
    oven landed within half a degree of sim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
    [ts391snl-run-0011-2026-09-10.csv]
2026-09-10 Settle the warm start by measuring the worst case, and run the fixture
    Four runs today, every check passed on all of them. Two of them were to
    answer the question left open by run 0011 rather than to make a joint.
    RUN 0013: the warm start, at the hottest temperature the supervisor allows.
    Run 0011 entered 33.9 s in from a 34.1 C oven and lagged 24.3 C. The obvious
    worry was that a warmer start enters a steeper part of the curve and does
    worse. It does, slightly, and it does not matter:
    start entry worst lag peak TAL
    34.1 C 33.9 s -24.3 C 246.69 C 97.7 s
    59.4 C 56.9 s -32.2 C 246.75 C 99.5 s
    Eight more degrees of transient for tw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
    [ts391snl-warm-start-run-0013-2026-09-10.csv]
2026-09-10 Run TS391LT: the generated opening, measured
    Run 0014, the first time the regenerated low-temperature opening has been on
    hardware.
    worst error, first 120 s -6.6 C (old curve: -23 to +15)
    mean |error|, first 120 s 2.69 C (simulated under 4)
    peak 168.4 C (window 155-175)
    max ramp up 1.80 C/s (limit 2.5)
    This is the single biggest tracking improvement in the firmware and it is
    now measured rather than simulated. The digitised chart asked 1.33 C/s from
    cold where this oven does about 0.58, so the old curve had the oven 21 s
    behind the line at 45 C and then 15 s AHEAD of it at 90 C -- saturating
    against an impossible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
    [ts391lt-run-0014-2026-09-10.csv]
2026-09-10 Run the bake's new approach: five times less overshoot than the old one
    Run 0015, from 30.3 C, aborted once it had settled at the setpoint.
    peak 125.44 C overshoot 0.44
    run 0009, old curve 127.19 C overshoot 2.19
    simulated 126.70 C overshoot 1.70
    Five times less, where the model promised less than two. J-STD-033 allows
    plus or minus five, so the old curve was never failing -- but 0.44 C leaves
    the whole allowance for a bake started on a warm oven, which is the case
    this has to survive and the one nobody has run.
    It reached 125 C at 256 s against 239. Seventeen seconds, on a four-hour
    run, for that.
    Aborted deliberately at the setpoint r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
2026-09-11 Give the page back its dates, and tell people what a profile is
    Three things, all reported from actually browsing it.
    THE DATES. Ten of fifteen runs showed "?". The header wrote started_at until
    2026-09-08 and started_at_epoch after it -- I changed the header when the "t"
    column was reworked and never told the page, which went on reading the old
    key. Nothing failed; it just quietly stopped knowing when anything happened,
    and the runs that still had dates were the OLD ones, which is the shape of
    bug that survives a glance.
    when() now takes either form. Run 0001 still says "?" and that is right: its
    header reads "started_at,monotonic+40" because the oven did not know the date
    that day.
    The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
    [code.py, test_webapp.py, webapp.py]
2026-09-11 Identify the state the plant model does not have
    Analysis only. Nothing here is wired into the firmware, the simulator or the
    tests -- tools/identify_plant.py reads captures and prints numbers, and the
    789 tests are untouched. It is recorded because the finding is worth more
    than the afternoon it took, and because it is the evidence for a controller
    change that has not been agreed.
    WHAT STARTED IT. Asked whether I was tuning the loop or bending the profiles
    to the oven. The answer was the profiles, and the reason turned out to be
    better than I could have argued at the time:
    - decomposed tracking error across the real runs, heating phase only, since
    the cooling tail is the door's erro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
    [run-0011-ts391snl-warm.csv, run-0013-ts391snl-hot.csv, run-0014-ts391lt.csv, run-0015-bake-125c.csv]
2026-09-11 Write down the loop that works, before replacing it
    docs/control-loop.md, and a tag. The existing feed-forward-plus-PID passed
    every check on every profile across runs 0010-0015 and is about to be
    replaced, so what it is, what it achieves and how to put it back are now
    recorded rather than reconstructable.
    git checkout known-good-loop-2026-09-10
    The flashed image and its code.py are kept alongside, with checksums, at
    ~/.bespoketoast/images/known-good/. Both, because code.py is not frozen and
    does not travel with a .uf2 -- rolling the firmware back without it leaves a
    board that boots and serves a dead page, which was found by doing it.
    Recorded with it: what the loop achieves (2.47 C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
2026-09-11 Build the one device harness that is allowed to heat
    Tomorrow is a day of control development on the real oven, and identifying a
    plant needs the plant. Every existing tool in tools/device/ deliberately
    avoids importing oven.hardware so the relay pin is never claimed; this is
    the first that claims it, and the exception is made narrow and loud rather
    than quietly.
    WHY A NEW EXPERIMENT AT ALL. The fits so far reuse profile runs, where duty
    is almost always 0 or 1 and tightly correlated with temperature. That pins
    down the steady-state rate at each temperature -- which is what the rate
    tables already are -- and says little about the dynamics. The missing state
    is the element charging, so the e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
    [heat_step_test.py, test_device_tools.py]
2026-09-11 The heating harness refused its own schedule, which is the interlock working
    First attempt to run the identification schedule on the oven:
    ValueError: ceiling 255.0 is above what this oven has been
    characterised to; the supervisor stops at 260 and that is a
    backstop, not a plan
    The 235 C plateau put its ceiling at setpoint + 20 = 255, and Step refuses
    anything over 250. No heat was applied; it refused at construction, before
    the relay pin was touched.
    The limit was right and the schedule was wrong, so the ceiling is now capped
    at 250 rather than the limit raised. 15 C of headroom at the top plateau is
    enough: a +/-0.15 duty square wave around the hold duty drifts a few
    degrees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
    [heat_step_test.py]
2026-09-11 A climb stops short of its plateau by what the element still has to give
    Second attempt at the identification schedule, stopped at 82 C after one
    plateau. The climb ended at 60 C as designed and the charged element then
    carried the oven 22 C past it -- relay last on at 64.1 C, peak 82.1 C
    34 s later -- so the entire settle window sat above the plateau's 80 C
    ceiling with the excitation clamped to zero. Safe, and the ceiling doing
    exactly its job, but it would have repeated at every plateau and cost the
    data the run exists to collect.
    That 22 C is the first measurement of the day. The characterisation records
    about 1 C of coast, measured from 200 C on a REGULATED oven whose element
    was alrea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
    [heat_step_test.py, plateau_dynamics.py]
2026-09-11 Record a model that does not work, and why
    Keep the measured rate tables exactly and lag only the element's
    contribution. It is the obvious design -- rule six says the tables are
    right, so extend them rather than replace them -- and it fails:
    held out elem-lag two-state current
    run-0011-ts391snl-warm 7.99 6.54 14.28
    run-0013-ts391snl-hot 12.95 5.79 16.21
    run-0014-ts391lt 17.87 6.06 13.02
    run-0015-bake-125c 18.23 4.64 23.58
    Worse than the current model on two of four held-out runs. An earlier
    version that lagged the whole rate, loss included, scored 7.6 to 20; t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
    [negative_result_element_lag.py]
2026-09-11 The warm-start fix is timing, not gain -- and the first design that says so
    Three results from simulation while the identification run heats the oven,
    in the order they arrived.
    THE LINEAR TWO-STATE MODEL IS 30% OFF THE MEASURED HEATING TABLE at the
    ends of the range. It is linear where the oven radiates. Rule six in
    docs/control-loop.md says the tables are right, so the obvious fix was a
    hybrid: table steady state, two-state dynamics. Leave-one-out, it is WORSE
    than the pure linear model on every fold -- 7.8 to 17.5 C rms against 4.6
    to 6.5 -- and worse than the current one-state model on one. So pinning the
    model to the table degrades it. One reading: the table is not steady state.
    It cam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
    [elementff.py]
2026-09-11 Pre-charge the element before the run clock starts
    A new state between PREHEAT and RUNNING. The element is driven at full duty
    with the profile clock held, an observer estimates its contribution to
    chamber rate, and the run starts when that reaches what the curve's opening
    needs or at a 40 s bound. Then the oven enters the profile wherever it is,
    as before, with an element that can follow.
    Simulated through the real App on the identified two-state plant, with the
    old feed-forward, PID, cutoff and output stage all unchanged:
    without with charge
    TS391SNL 59 C start rms 12.51 lag -25.2 rms 4.10 lag -8.5 40 s
    TS391SNL 34 C start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
2026-09-11 Converter: a console capture into a data/plant-id/ file
    The run logs carry no duty column, so identification works from the
    console. This keeps the rows that matter, re-bases time, and decimates to
    1 Hz, which is what identify_plant.py expects and what a 14 s element time
    constant needs. Written now so the identification capture goes into the
    five-run refit with one command when it lands.
    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
2026-09-11 The plateau tool says when its answer is flat
    On the first real capture the free fit returned tau = 96 s at one plateau
    and a gain of 0.000 at another, and neither was a measurement: a +/-0.15
    duty square wave on a 0.0625 C probe is a few degrees of signal, and over a
    60 s half period a large gain with a long time constant fits it as well as
    a small gain with a short one. The fitter was not wrong; the question was
    not well posed.
    tau is now bounded to 3-40 s, the range every other measurement puts it
    in, and the rms with tau pinned at 8, 14 and 25 s is printed beside the
    free fit, so a flat minimum reads as one. The 60 C plateau is flagged
    flat; the 100 C plateau shows a weak preference for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
    [plateau_dynamics.py]
2026-09-11 A second identification schedule the local fit can use
    The v1 schedule's square waves were too gentle for a per-plateau fit:
    +/-0.15 duty on a 0.0625 C probe is a few degrees of signal, a 60 s half
    period lets the response settle so completely that gain and time constant
    trade off freely, and at the 60 C plateau the down half clamped to zero
    because 0.043 - 0.15 is negative. tools/plateau_dynamics.py flagged one
    plateau flat and put tau anywhere from 8 to 40 s at another.
    v2: amplitude 0.3, half period 30 s, four cycles, and the low plateaux
    held at a duty high enough that the down half is a real step and not a
    rail. The climbs -- full power, stop short, coast -- were always the
    strong exci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
    [heat_step_test.py]
2026-09-11 Identification run: the element time constant falls with temperature
    First run of tools/device/heat_step_test.py on the oven. Plateaux at 60,
    100, 150, 195 and 235 C, each held and then square-waved in duty. Stopped
    by hand at step 35 of 41 with the cold junction at 65 C -- five degrees
    under the fault -- and the top plateau clamping on its ceiling; the 235 C
    excitation and the scheduled cooling are not in it. Peak 250.8 C, 10,205
    rows, no faults.
    Per plateau, from tools/plateau_dynamics.py with tau bounded and the rms
    profile printed:
    150 C gain 1.71 C/s tau ~15-18 s clear minimum
    212 C gain 1.46 C/s tau ~9 s clear minimum
    60 C and 100 C: too gentle an excitati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
    [run-ident-2026-09-11.csv]
2026-09-11 Run 0016: pre-charge measured on hardware, 59 C start rms 13.21 -> 2.41
    Same start as run 0013 on the pre-charge firmware. 33 s of charge, entered
    the profile at 80.5 C, worst lag -5.1 C against -32.0, peak within 0.2 C.
    Capture banked in data/plant-id.
    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
    [run-0016-ts391snl-hot-precharge.csv]
2026-09-11 Score the heating phase from the entry sample on; 0016 is 1.57 rms, 0013 13.06
    The first control sample of a run carries the profile's t=0 target before
    the entry offset applies; two such samples were a third of the rms.
    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
2026-09-11 Predictive tracking: the loop acts on where the chamber will be, 6 s ahead
    The element stores ten seconds and more of heat the chamber has not seen,
    so the old loop drove full-on into a knee and coasted 14 C past it (run
    0017, TS391LT hot start, +4.1 C at the soak knee). Controller.duty_for now
    takes the observer's element state and, with a lead configured, evaluates
    the feed-forward and the PID on the curve lead_s ahead against the
    two-state model's prediction of the chamber there. The App owns one
    observer per run: pre-charge fills it, the run keeps feeding it with what
    the relay did.
    Through the firmware's own Controller and ElementObserver on the
    identified plant, lead 6 s: TS391LT cold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
2026-09-11 code.py: CircuitPython functions do not take attributes; the board said so
    The first boot of the predictive image stopped at make_precharge_factory
    with "can't set attribute 'model'". The model is now loaded once by
    load_element_model and handed to the pre-charge and observer factories.
    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
2026-09-11 Run 0017 banked; a contract test for attributes set on functions in code.py
    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
    [run-0017-ts391lt-hot-precharge.csv]
2026-09-11 Run 0018 banked: 34 C start on the predictive loop, rms 1.87, worst lag -5.3
    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
    [run-0018-ts391snl-warm-predictive.csv]
2026-09-11 Predictive tracking assumes the loop's last duty persists; unbiased on hardware
    Replayed against runs 0016, 0018 and 0019, the decay-form prediction
    under-predicted the chamber six seconds out by +0.85 C on average, and
    run 0019 ran that much hot from 160 C to the peak. Predicting with the
    element on its way to the steady state of the last commanded duty is
    unbiased to 0.05 C with half the spread. Lead stays at 6 s.
    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
2026-09-11 Run 0019 banked: 59 C start on the first predictive image, rms 1.91
    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
    [run-0019-ts391snl-hot-predictive.csv]
2026-09-11 Run 0020: the corrected prediction, LT hot start, rms 0.78 and no knee overshoot
    The +4.1 C the loop coasted past the soak knee on run 0017 is 0.8 C, the
    peak lands within 0.3 C instead of 3.1 C over, and duty saturates for 6%
    of the heating phase against 21%. Costs 22 relay actuations.
    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
    [run-0020-ts391lt-hot-predictive.csv]
2026-09-11 Run 0021: cold start on the corrected prediction, rms 0.95
    The cold start was never the weak case and the old loop managed 2.46 rms
    on the easier profile; this is the reflow curve at 0.95, peak within
    0.9 C, duty saturated 16% of the heating phase.
    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
    [run-0021-ts391snl-cold-predictive.csv]
2026-09-11 Run 0022: the corrected prediction on the hot start, rms 1.13 against 1.91
    Same profile, same 59 C start and same 29 s of charge as run 0019; only
    the prediction changed. The +1.5 to +1.8 C bias 0019 carried from 160 C
    to the peak is within 0.5 C. What remains is 2.4 C behind between 80 and
    120 C with the relay closed, which is the oven at full power on the low
    end of the heating table.
    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
    [run-0022-ts391snl-hot-predictive.csv]
2026-09-11 STATUS reports the network; a failed join only ever said so once
    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
    [code.py]
2026-09-11 A reflashed board cannot join for a minute, and an undated run is forever
    Runs 0020, 0021 and 0022 carry no date: they were started in the window
    after a flash where the radio had not joined, and the network is the only
    thing that ever set the clock. code.py now takes CLOCK <epoch> on the
    console and deploy.py sends it when it hands the volume back. Best
    effort; a failure costs a date, not a run.
    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
    [code.py, deploy.py, test_device_tools.py]
2026-09-15 docs: proxy ARP on the router fixed it; the retraction was wrong
    A laptop could not reach the oven. The router now answers ARP for its
    wireless clients from its own cache. Verified from the Pi (router answering
    in 4-35 ms against the oven's 24-122 ms) and by a 26-minute idle test from a
    laptop with no cached entry: first-time resolution, 4 of 4 pings, HTTP 200.
    Records the Qualcomm driver trap, why the ESP32 power-save suggestion does
    not apply to NINA and is not needed, and that arp-pin hides the fault from
    the Pi, which is why it was never seen from here.
    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
2026-09-15 Announce a latched fault once; measured holds in the ID schedule; no MACs in the docs
    A sensor that stopped answering on 2026-09-11 produced the same fault
    event every control step, 888 times: into the console, burying the
    answer to STATUS while it mattered whether the relay was open, and into
    the run's log. The relay is still opened every step; the event is now
    announced once.
    The identification schedule's 150, 195 and 235 C holds are the ones the
    first run measured. The table's 0.526 is what sent the 235 C plateau to
    248.8 C and onto its ceiling.
    docs/network.md carried three MAC addresses against the rule that none
    live in this repository; they are kept on the Pi instead.
    Co-Authored-B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
2026-09-15 docs: the amplifier latch-up, and how to actually cut the oven's power from the Pi
    The MCP9600 held SDA to ground mid-bake on 2026-09-11; a processor reset
    did not clear it and removing power did. On this Pi 3B the USB ports are
    switched together through port 2; asking for port 4 reports off and cuts
    nothing, which was mistaken for a real power cycle at the time.
    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
2026-09-16 Take a fixed address when one is configured, instead of asking DHCP
    The access point began answering ARP for its own clients on 2026-09-15.
    Before binding an address DHCP has offered, this stack broadcasts an ARP
    request for it and treats any reply as a conflict, comparing the address
    only and never the MAC. So the access point answered with this device's own
    MAC and the stack refused the address it had just been given. From the
    router's side: 37 associations, 37 completed handshakes, 37 addresses
    handed out, and the device reporting itself unconnected every time. Other
    clients compare the MAC as well and were unaffected.
    A network in wifi.json may now carry ip and gateway (and optionally m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
    [bringup.py, netconfig.py, test_bringup.py, test_netconfig.py]
2026-09-16 docs: point the baseline at the image the board is actually running
    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
2026-09-16 docs: the stack was following RFC 5227, not ignoring it
    During probing, any ARP packet whose sender address is the probed address
    means the address is in use; the sender-MAC test belongs to the later
    phases. This said the opposite. Records the revert on the access point.
    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
2026-09-16 docs: power save is measurably not the cause, tested on one live association
    Same association, held open across both rounds, with a control: the Pi
    resolves other wireless peers 5 of 5 in the same minutes and the oven 0 of
    8, with power save on and with it off. The 2026-09-04 test that found the
    same thing was confounded; this one is not.
    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
2026-09-16 arp-pin: install the remembered mapping before pinging, not after
    The verification is a ping, and a ping cannot leave the host while the
    kernel's entry is FAILED -- the state an unresolvable peer leaves behind.
    So the check could never pass in the one case the script exists for, and it
    reported holding a mapping it had not installed. Hit today: the oven was
    unreachable from this host with its MAC sitting in arp-known, and one
    by hand restored 4 of 4 pings and the page.
    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
2026-09-16 The oven answers unicast ARP 12 of 12 and broadcast 0 of 12
    Its ARP is fine and its receiver is not weak in general: frames addressed
    to it are answered every time, in the same minute that group-addressed ones
    get nothing. 0 of 172 broadcast probes tonight. 802.11 retries unicast and
    never retries group-addressed frames, which is why unicast hides this and
    why the access point reports excessive retries.
    arping could not have shown this -- it only switches to unicast after a
    reply, so every probe to a silent peer is a broadcast. tools/host/arp-probe.py
    builds the frame instead.
    Claude-Session: https://claude.ai/code/session_01V2zgdtVfvC5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
2026-09-16 Two 2.4 GHz clients are group-frame blind; bench5 was never a control
    The bench Pi receives zero group-addressed frames in 70 s, including zero
    of 20 broadcasts sent from the wired host during the window. So the oven's
    radio is exonerated: an ESP32 and a Broadcom radio with power save off fail
    identically on this BSS.
    Every wireless control in the previous section is withdrawn. bench5 is on
    5 GHz channel 36, a different BSSID, so it only ever tested the 5 GHz group
    path. This file already recorded the same error once, with a wireless host
    that was wired. A control is not a control until its band and BSSID are
    written next to the number.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
2026-09-16 The access point's own measurement: three of four 2.4 GHz clients at ~10%
    Its operator probed four clients from br-lan, 10 each: printer 11, bench Pi
    1, oven 1, Kasa plug 1, unicast perfect for all. Three unrelated clients
    including a mainstream Linux host fail the same way, so this is not the oven
    and the co-processor beacon/DTIM line is dropped.
    Both group-to-unicast escapes are closed: Qualcomm multicast enhancement is
    compiled out of that firmware, and the oven advertises no DMS support. Their
    lead is a radio configured for 40 MHz but running at 20 because eight
    stations are 40 MHz intolerant.
    Claude-Session: https://claude.ai/code/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
2026-09-16 Ten minutes on this radio, zero group-addressed frames received
    600 s, associated throughout, unicast to the gateway fine immediately after,
    and not one ARP, mDNS, SSDP or DHCP broadcast from any host. The access
    point measured this same Pi at 1 of 10. Their measurement is responder-side
    and mine is receiver-side, and neither should be near zero at 10%, so the
    two disagree about one host.
    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
2026-09-16 Resolved: the access point's radio had been up 155 days and was delivering one group frame in ten
    Restarting it fixed everything. The oven now answers 30 of 30 broadcast ARP
    probes with no gaps, against 0 of 172 before, and this Pi receives 548 group
    frames in 90 s including 114 mDNS where it saw 0 in 600 s.
    The totals hid this for three days and the gaps identified it in ninety
    seconds, so arp-probe.py now prints them and group-canary checks hourly.
    Records three wrong turns of ours, and one open firmware defect: the oven
    reported a live network for eight hours after losing its association and
    never re-joined until code.py was restarted.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
2026-09-16 group-canary: say what a zero reading means, since zero has no gaps to show
    The dry run against a local listener exposed it: the alert told the reader
    to look at a gap pattern that a 0-of-12 reading cannot contain. A real
    recurrence reads about 1 of 12, where the gaps are the whole signal, but
    zero is possible too, and the message now says to re-probe for the pattern
    rather than pointing at gaps that are not there.
    Tested end to end against a local listener rather than the real relay: a
    false alarm there would prompt a radio restart that drops every client on
    the network. Detection, logging, one post per episode and a silent second
    run all behave.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
2026-09-16 group-canary: alert locally, now that the shared relay is retired
    The relay it posted to is being torn down, and a monitor pointing at a dead
    endpoint is worse than none. It now writes the alert to
    /var/lib/toaster/group-canary-ALERT.txt and sends it to any logged-in
    session, and it carries the fix with it: wifi down then wifi up on the
    access point, since wifi reload there is a no-op that looks like a clean
    negative result.
    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
2026-09-16 The canary alerts locally; the shared relay is gone
    The agent relay the canary posted to has been torn down now that the work
    with the router's operator is finished. The README described an endpoint
    that no longer exists.
    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
2026-09-16 Remove the group-frame canary
    Not wanted running, and a monitoring program nobody asked to keep is bloat
    on a host with 35 MB free. The diagnostic that matters survives in
    tools/host/arp-probe.py, and the knowledge survives in docs/network.md:
    compare gap patterns rather than totals, a clean 1-in-N is the access
    point's radio, and the fix there is wifi down then wifi up.
    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
2026-09-16 Remove the ARP workarounds: the fault they covered was the access point's
    arp-announce and arp-pin held neighbour entries for peers this host could
    not resolve by asking. That was the access point's radio delivering one
    group frame in ten, and restarting it fixed resolution for everything.
    Verified here: with the pin dropped and both units removed, this host
    resolves and reaches the oven normally.
    They were network-specific as well as obsolete. The peer list and the
    remembered MACs named one network's addresses, and on the next network this
    host joins they would pin mappings that mean nothing.
    Claude-Session: https://claude.ai/code/sess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
2026-09-16 Prune network.md to the current state, and finish the README cleanup
    network.md was 872 lines and 36 headings, most of it a running narrative of
    positions later withdrawn: a false access-point theory, its correction, the
    proxy ARP episode and its reversal, and four successive readings of the
    group-frame fault. It now states what is true -- credentials, the radio's
    memory cost, log serving, boot bring-up, the fixed-address support that
    exists and is off, the resolved fault with its signature and fix, and the
    one open defect -- plus the four rules the episode cost. 284 lines.
    The host README still told the reader that the router answers ARP by proxy,
    reverted a day ago, and that two units sta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
2026-09-16 release.py: refuse without TOASTER_BUILD_HOST instead of guessing one bench
    It defaulted to the address of the machine that happened to build the
    firmware here. Anywhere else that address does not exist or belongs to
    somebody else, and the failure read as 'cannot reach the build host' rather
    than 'you have not said which host'.
    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
    [release.py]
2026-09-16 The web service notices when the radio has silently left the network
    On 2026-09-16 the access point restarted its radio, the oven lost its
    association, and for eight hours it reported a joined network and a live
    address while answering nothing and being absent from the station table.
    Its own console could not be told from a healthy one. Restarting code.py
    rejoined it in seconds, so the recovery was always there and only the
    noticing was missing.
    The idle path now asks the co-processor once a minute whether it is still
    associated, and on a no, tears the service down so the next pass runs a
    fresh bring-up and the screen goes back to saying which stage it is in. One
    SPI call per interval, neve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
    [code.py, test_firmware_contract.py]
2026-09-16 time to peak is a reflow check; a bake cannot pass or fail it
    Run 0024, a clean four-hour bake, reported 'time to peak FAILED 5916 s
    (limit 480)'. That ceiling is J-STD-020's and exists to limit how long a
    board spends hot on the way to reflow; a bake deliberately spends four
    hours at 125 C and reaches its peak whenever the room lets it.
    Gated by category in Limits.for_profile, the same way time above liquidus
    is already gated, and for the same reason recorded there: a red FAILED on a
    check the run could neither pass nor fail is how people learn to stop
    reading the report.
    Claude-Session: https://claude.ai/code/session_01V2zgdtVfvC5mZtZ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
    [metrics.py]
2026-09-16 Serve the page on the report screen, and stop pre-charging when nothing asks for a rise
    Two faults found by taking the oven through a run that never heats.
    The page was gated on STATE_IDLE while netconfig.SAFE_STATES has always
    listed report as safe too, so after every run the oven parked on the report
    screen with the page unreachable until somebody pressed DONE. Measured:
    ping 0% loss through the whole run and the whole report, HTTP dead for
    both, back within 34 s of DONE. The radio never went anywhere; it reads
    exactly like 'it doesn't come back after a run'.
    Pre-charge decided by need = rate + d*(temp - ambient) > 0. On a flat
    opening the rate term vanishes and the test collapses to 'is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
    [code.py, test_firmware_contract.py]
2026-09-17 Rewrite control-loop.md as the loop that exists, not the path to it
    324 lines to 184. It opened with a fallback section describing a
    superseded loop, then narrated pre-charge and predictive tracking as dated
    episodes with their simulation sweeps, rejected alternatives and
    run-by-run investigations. It now describes the loop: what each stage does,
    why the constants are what they are, what it measures, where it still
    loses, how to roll back, and the seven rules any replacement must keep.
    Both fixes from the no-heat run are verified on hardware: the page answers
    during the report screen (HTTP 200 sixteen seconds after the run ended, a
    minute before DONE), and pre-charge no longer runs on a cur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
2026-09-17 network.md: record the idle SPI deaths, and that the liveness fix is unproven
    The web service stopped twice on its own across two idle windows and
    restarted itself 11 s and 40 s later, with the association untouched
    throughout. Undiagnosed, self-healing, and worth writing down rather than
    leaving as folklore.
    Also corrects the section above it: the liveness check exists now, but it
    has never been observed firing against the real fault, which is a different
    claim from 'fixed'.
    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
2026-09-17 Rewrite profiles.md as what each profile is, not how it got there
    481 lines to 170. It was organised around dated runs and superseded
    readings -- old-curve-versus-new comparisons, per-run check tables, and an
    argument about a table artifact that was fixed three days later. What
    survives is what someone changing a profile needs: how the curves are
    generated, each paste's peak and ramps and why, the constraints that bite
    (TS391SNL's unmeetable ramp into peak, TS391LT's 96 C post-assembly limit,
    the step test's 245 C table ceiling), and the door's measured behaviour.
    One section had also gone stale in a way that mattered: TS391SNL's warm
    start was documented at length as not needing fixing, wi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
2026-09-17 Release pass over the remaining docs
    hardware.md: the open questions asked two things the document already
    answered, including whether the relay fails safe -- which is measured three
    times over a few paragraphs above. The amplifier latch-up becomes a standing
    failure mode rather than a dated incident.
    original-firmware.md: 135 lines to 72, and it opened by contradicting
    itself -- 'the original no longer exists, references are against tag v1'
    immediately followed by 'how the controller in firmware/ works, references
    are against firmware/code.py'. Every line number in it is v1, so as written
    it sent readers chasing line 312 of today's code. What survives is what the
    rewrite was for: squared-e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
2026-09-17 26 runs, not 24, and two of them are mine
    Counted off the oven rather than inferred from the highest log number. The
    two no-heat network tests are runs 0025 and 0026; they exercise the
    run-to-idle transition and establish nothing about heating, so they are
    named as such rather than folded into the validation count.
    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
2026-09-17 A failed bring-up retries instead of taking the oven off the network for good
    The main loop calls web.advance() only while it returns True, and the flag
    that gates it is set True once at startup and never restored. A bring-up
    that exhausted its three join attempts returned False, so the oven stayed
    off the network until a human rebooted it -- idle, healthy, no fault,
    retrying nothing. Observed today: four minutes unreachable across two
    liveness intervals with a silent console, cleared instantly by a reload.
    This morning's liveness check never covered it. That sits behind
    and only guards an association lost after a
    server exists, so the eight-hour outage of 2026-09-15 was most likely this
    l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
    [code.py, test_firmware_contract.py]
2026-09-17 Baseline the verified pair: image plus the code.py that was tested with it
    The board runs image b6fc67b32a05 with code.py 094bf903cdac, and that
    combination was exercised end to end: a bring-up failure staged on purpose,
    two retries 120 s apart, and a clean recovery once the real credentials came
    back. The recorded hash was still the code.py from before the retry fix.
    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
2026-09-17 Correct the root documents; the licence notice was misstating provenance
    NOTICE.md said firmware/code.py was Adafruit's EZ Make Oven with six
    restored header lines as its sole difference, 'unmodified and byte-identical
    below the header'. That was true of v1 and became false at the rewrite:
    measured, v1 is 416 lines, the current code.py is 1394, and they share no
    line in common. A licence notice asserting the wrong authorship of the
    shipped code is not something to ship. It now states what is true, keeps the
    Adafruit attribution where it belongs -- the history at tag v1, which is why
    LICENSE carries that copyright line -- and records the B612 fonts as OFL
    with their licence travelling alongsi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
2026-09-21 Make every cited run reachable from a fresh clone, and say how to install
    A clone had no record for run 0024, the four-hour bake the release figures
    rest on, and the bake comparison leaned on run 0015 -- 3.2 minutes of hold
    against 0024's four hours. Both are now in data/, complete rather than
    decimated, alongside run 0009: the only other four-hour bake, and the
    honest comparison. It is a narrower win than 0015 suggested, so the
    document now says so.
    tools/score_runs.py recomputes every tracking figure the documentation
    quotes, from those files, and tests/test_scores.py holds the published
    numbers against it -- including a test that no document cites a run whose
    record is absent. Four figur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
    [bake-125c-run-0009-2026-09-09.csv, bake-125c-run-0015-2026-09-10.csv, bake-125c-run-0024-2026-09-16.csv]
2026-09-21 Prune network.md to what is true now, and stamp runs v2.0 rather than v2.0-dev
    network.md had grown a running narrative -- what was measured first and
    then corrected, what boot used to do, which conclusion an earlier section
    had reached. A release branch should read as the state of the system, so
    each of those is now the rule it produced: the radio stays up because
    closing it costs 24.22 s of frozen loop, the bring-up holds three rules
    worth fifty seconds of dead screen, memory is not what keeps the network
    out of the control loop and timing is. 245 lines become 99.
    VERSION is stamped into the header of every run log and onto the splash.
    Shipping "v2.0-dev" on the release would put -dev in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
    [code.py, render_screens.py]
2026-09-21 hardware.md described the firmware this one replaced, in two places
    The ESP32 was listed under "fitted, not used" with no secrets.py and
    networking inactive. That was true of the controller as found; this one
    sets its clock and serves its page over that radio, and what keeps it out
    of the control loop is a 227 ms SPI call against a 250 ms deadline, not
    disuse.
    "Roughly 20 actuations in a typical session" was the old controller
    holding the relay across consecutive saturated windows. A 4 s
    time-proportional window costs 8.19 closures per minute across the hold of
    run 0024 -- about 1965 in a four-hour bake. Relay life is what the
    tracking was bought with, and the number should say so.
    Co-Auth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
2026-09-21 The wifi template said the options existed without saying how to use them
    "A network entry may also carry ip and gateway" is not instructions. Both
    optional features now appear as filled-in JSON under underscored keys the
    firmware ignores, with the fields, the defaults and the failure modes
    written next to them: ip and gateway are required together, mask defaults
    to 255.255.255.0, dns to the gateway; an archive needs only host, with
    port defaulting to 80 and path to /runs, and is switched on by renaming
    one key.
    Two tests run those examples through the real parsers, so a template that
    shows a shape netconfig rejects fails instead of misleading somebody at a
    wiped volume. network.md gains th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
    [test_netconfig.py]
2026-09-21 Name the release tags, not the dated baselines that are going away
    The tag scheme becomes v1 and v2. Four known-good-loop-* tags carried the
    working baselines during the rebuild and are being removed, so every
    reference to one is replaced first: the README's tag table, the checkout
    line and the rollback list in control-loop.md, and the module docstring in
    elementff.py. All four commits stay reachable from main, so this removes
    names rather than history, and the one baseline still worth comparing
    against is cited by commit instead.
    elementff.py is frozen into the image, so the flashed firmware now differs
    from this source by a docstring and nothing else.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
    [elementff.py]
2026-09-21 Report the version the tag names: v2, not v2.0
    VERSION is stamped into the header of every run log and onto the splash,
    and the release tag is v2. Two names for one release is one too many, and
    the log header is the copy that outlives the conversation.
    The test fixtures that passed "v2.0" as a firmware string move with it.
    test_collector keeps "v2.0-dev" on purpose: it is a fixture of a log the
    oven really wrote, and logs from that period really do carry it.
    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
    [code.py, render_screens.py, test_logstore.py, test_ui.py]
2026-09-21 One version name, and it is the one already in the field: v2.0
    The rename to "v2" made the repository and the oven disagree, and the oven
    is the copy that stamps itself into the permanent header of every run log.
    So the tag moves to the firmware rather than the firmware to the tag:
    VERSION, the splash, the screenshot harness, the fixtures and the three
    documents that name the tag all read v2.0.
    firmware/code.py is now byte-identical to what the board is running
    (md5 353586c976729e0a39f8bbb86aa08fad), so nothing needs deploying to it.
    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
    [code.py, render_screens.py, test_logstore.py, test_ui.py]
2026-09-21 The deploy guard failed open on any host without pyserial
    running_check returned None when `import serial` failed, and main() reads
    None as "nothing is running" and deploys. Writing to CIRCUITPY soft-reboots
    the board, so on a machine without pyserial the one mechanical guard against
    deploying into a live profile was not there at all. The docstring already
    said what the behaviour should be -- a device that says nothing is unknown,
    not idle -- and set_boot_mode already returned a reason string in the same
    situation.
    This bench has pyserial installed, which is why the suite passed here on
    every run while CI failed on every commit since the workflow was added.
    tests/test_deploy.py now pins the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
    [deploy.py, test_deploy.py]
2026-10-01 Profiles get versions, an archive, and deletes that need a download first
    An upload under a name already listed used to overwrite it. It now adds the
    next version beside it -- ts391lt.v2.json next to ts391lt.json -- and the
    newest version is the one the oven runs. Versions are files rather than a
    field, so a profile cannot claim to be a version it is not and every
    version stays a complete profile that can be sent back.
    The page can archive a profile, which takes it off the oven's PROFILE
    button and touches nothing else: an empty <stem>.archived marker sits
    beside the files. It can delete one version or the whole profile, and the
    delete buttons stay greyed out until what they would delete ha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
2026-10-01 One missed temperature reading no longer ends the run
    A single failed read (nothing returned, a bus error, an out-of-range
    value) used to latch a fault and stop the profile. It is now a miss,
    tolerated only under rules that keep the oven from heating blind:
    - A missed step denies heat. The relay opens and the controller does
    not run, so while the sensor is blind the oven can only cool.
    - Misses are bounded: more than 3 in a row, or more than 8 in 60 s,
    latches a sensor fault as before. The cadence guard still applies.
    - The relay opening for a miss does not restart the stall and frozen
    guards. Otherwise misses coming more often than the stall window
    would keep it from completing, an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
    [app.py, safety.py, test_app.py, test_predictive.py, test_safety.py]
2026-10-01 Nobody at the oven could tell a run had ended, or that it had failed
    The screen is the only indicator, and nobody watches it for the length of a
    profile. The speaker now plays a short rising arpeggio when a profile
    finishes (0.7 s) and a falling tone pair, twice, on a fault or a preheat
    that timed out (1.3 s). An abort someone asked for is silent. CHIME DONE
    and CHIME FAULT on the console play them on demand while the oven is idle.
    Notes change from the main loop rather than with sleeps, so a sound never
    holds up the 250 ms control step, and the speaker loops one 32-byte
    waveform cycle at the note's pitch instead of needing a rendered buffer.
    There is no watchdog, so a speaker call that hu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
    [chime.py, code.py, hal.py, hardware.py, test_chime.py]
2026-10-08 Trip over-temperature on a hot range-flagged reading; keep cold in blind rows
    A reading above max_temp_c with only FAULT_RANGE set was counted as a
    miss and latched as "no sensor reading" a second later. It now trips
    FAULT_OVER_TEMP at once. The blind-step sample row keeps the
    cold-junction value the reading carried.
    Claude-Session: https://claude.ai/code/session_019Su6D3SW5s3zC24jQvmbjP
2026-10-08 Escape quotes in profile names; keep uploads off the diagnostic profile
    The list's attributes are single-quoted and the escaper left quotes
    alone, so a profile name could break out of one. Uploads matched names
    against every profile including DIAGNOSTIC, so a profile named for it
    became its newest version with the flag stripped and landed on the
    oven's button. Both closed, with tests.
    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
2026-10-08 Chime: stop() is a no-op when idle, keeps a hold it could not confirm
    Console START calls stop() in every state, and stop() took the hold
    unconditionally, so a START during a run opened the relay for a step and
    touched the DAC. It now returns at once when nothing is playing and no
    hold is held, releases only after quiet() succeeded, and tries to quiet
    the amplifier when a tone fails. Also a broken line continuation.
    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
2026-10-14 Opening a run log no longer stalls the control loop at START
    LogStore.runs() sorted with key=_sequence_of. MicroPython calls a key
    function on every comparison, and its quicksort is quadratic on input that
    is already in order, which a directory listing is. With 53 logs on the board
    each call took 1.05 s, and begin() made two of them inside a control step.
    The 3 s cadence guard then faulted every run about half a second in:
    "no sensor reading: 3.1 s without a check during a run".
    The stall had been growing with the log count (about 1.6 s at log 40,
    2.5 s at log 49) and crossed the limit on 2026-10-14.
    - runs() computes each key once and sorts the (key, name) pairs.
    - _next_name() takes the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
2026-10-14 A run that ends before its first sample closes its log
    end_log() formatted app.metrics.peak_c, which is None until the first
    sample is recorded. A fault at START therefore raised
    "TypeError: can't convert NoneType to float" out of the main loop and
    stopped the controller. The summary is now skipped when there is no peak.
2026-10-24 The oven uses an MCP9601 and a stainless-tipped probe
    The amplifier is now an MCP9601 (Adafruit 5165) and the probe an Adafruit
    3245, in place of the MCP9600 (4101) and the bare-bead 270.
    The MCP9601 reports an open probe in bit 4 of its status register and a
    probe shorted to VDD or ground in bit 5. hardware.py read bit 4 as the
    MCP9600's input-range flag, a tolerable miss; it now reports the two as
    FAULT_OPEN_CIRCUIT and FAULT_SHORT_CIRCUIT, which the supervisor already
    latches on at once. The decoding lives in hal so it is tested off-board.
    The driver accepts either chip, so hardware.py reads the device ID itself
    and refuses anything but the MCP9601's 0x41: on an MCP9600 the same bits
    me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
